roravec/RastoBot/Docs/ESP32/ESP32Pinout-FullPinout-768x576.png

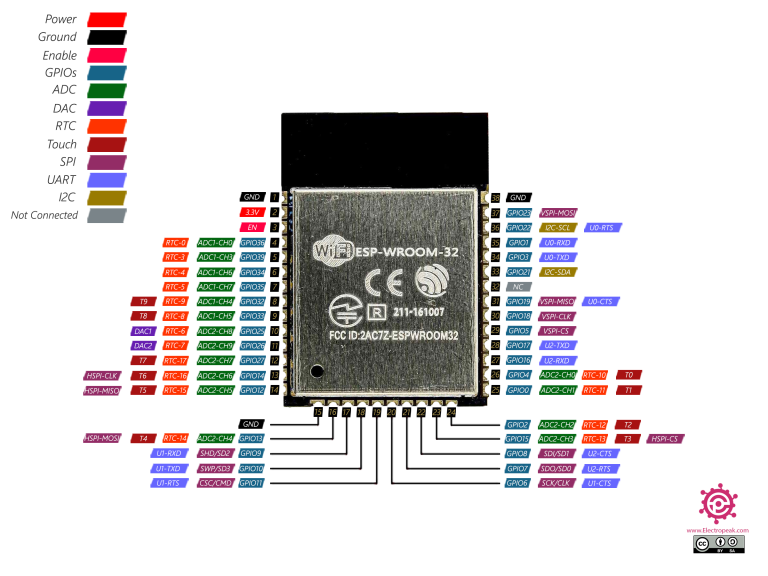
Docs/ESP32/ESP32Pinout-FullPinout-768x576.png
