roravec/RastoBot/Docs/ESP32/ESP32-S-pinout-mischianti-low-resolution.jpg

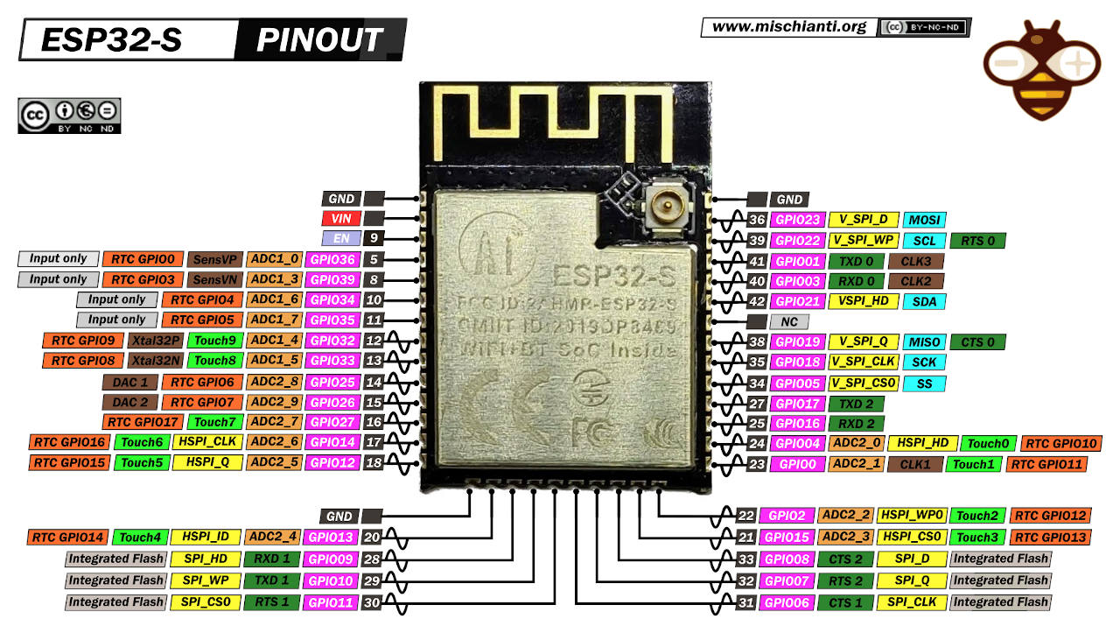
Docs/ESP32/ESP32-S-pinout-mischianti-low-resolution.jpg
