roravec/RastoBot/Docs/ACS712/d-768x346.png

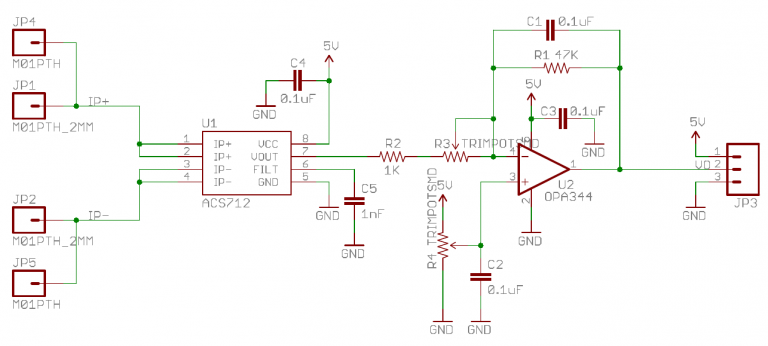
Docs/ACS712/d-768x346.png
