roravec/RastoBot/Docs/ESP32/xRequired-Circuit-For-Bare-Minimum-ESP32-Module.jpg.pagespeed.ic.3xBncZGP1E.webp

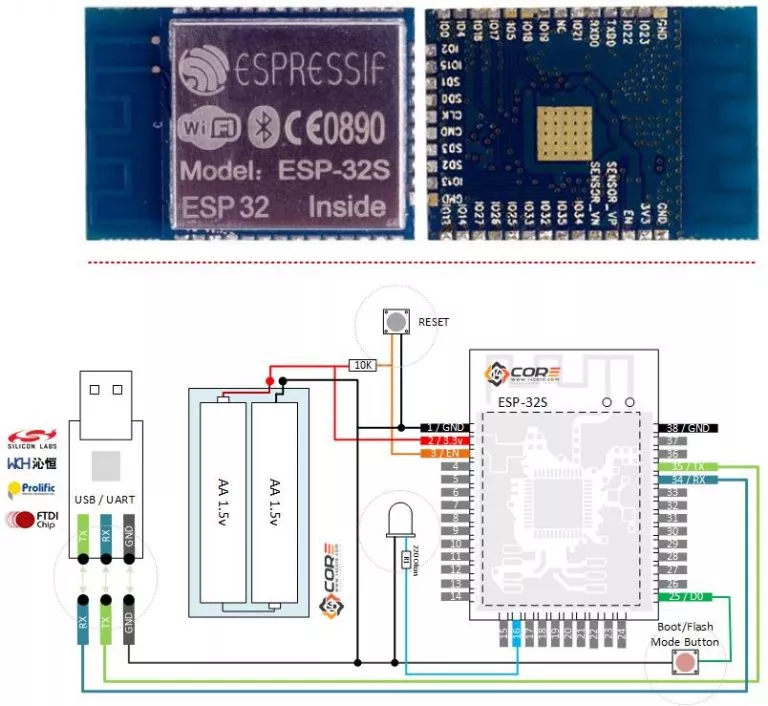
Docs/ESP32/xRequired-Circuit-For-Bare-Minimum-ESP32-Module.jpg.pagespeed.ic.3xBncZGP1E.webp
