roravec/RastoBot/Docs/mosfet driving.png

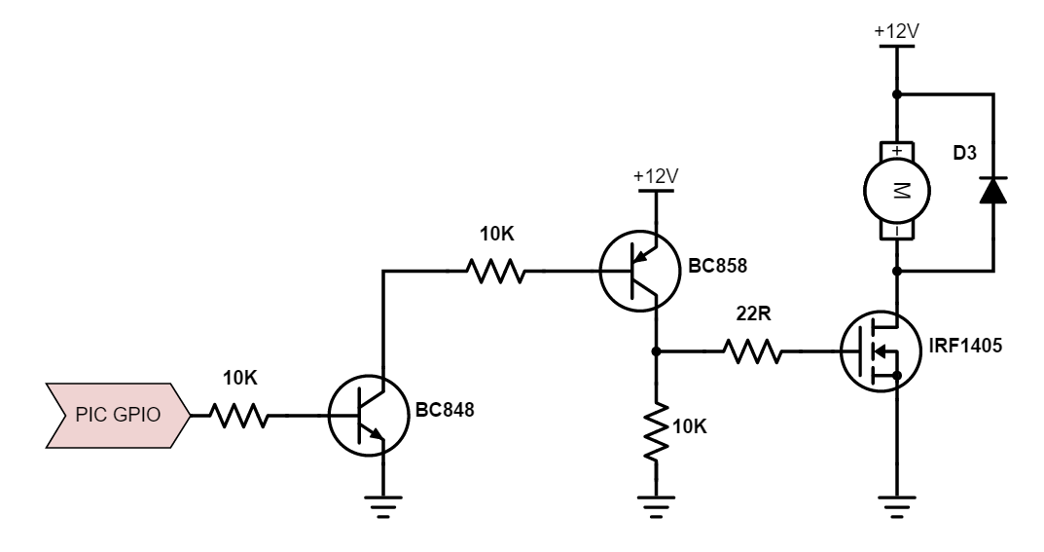
Docs/mosfet driving.png
