roravec/RastoBot/Docs/MP6500/MP6500.png

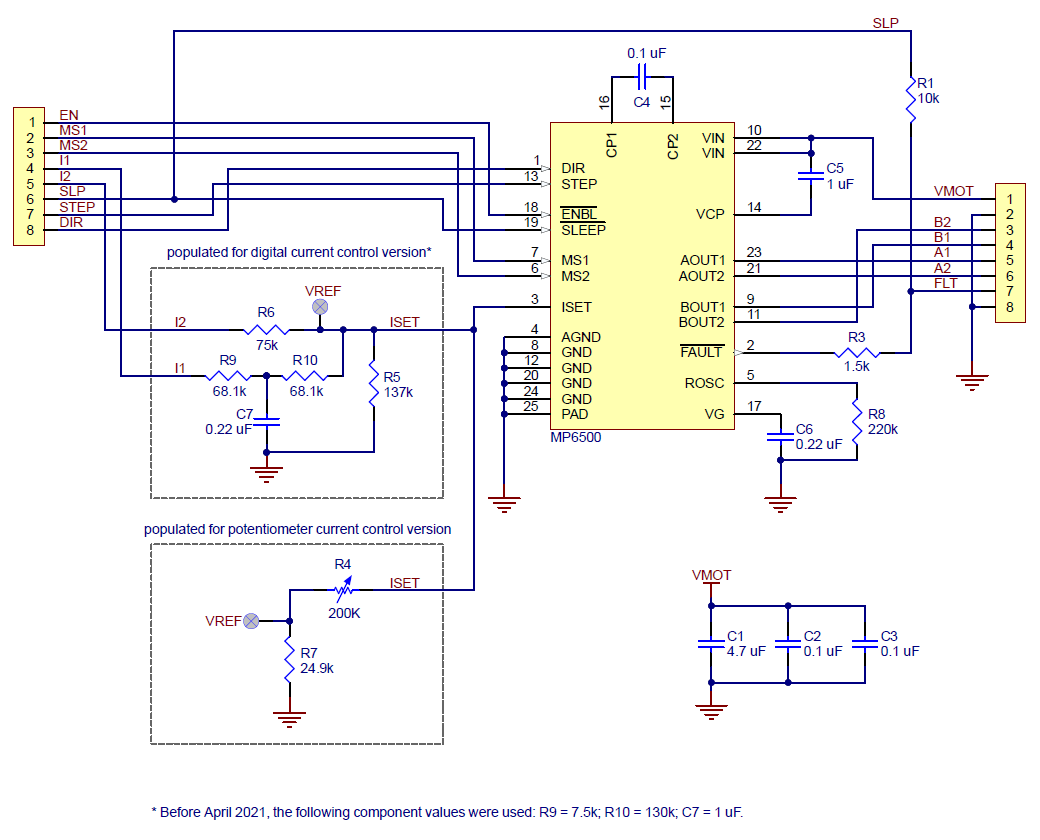
Docs/MP6500/MP6500.png
