roravec/RastoBot/Docs/MP6500/MP6500_a.png

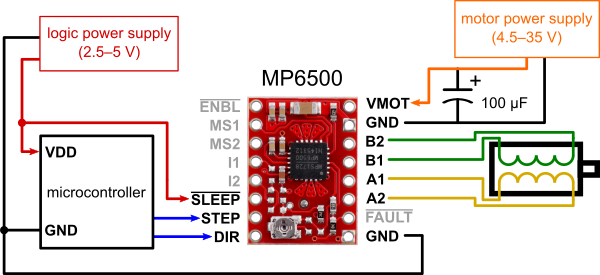
Docs/MP6500/MP6500_a.png
