roravec/RastoBot/Docs/optocoupler_mosfet_driver.gif

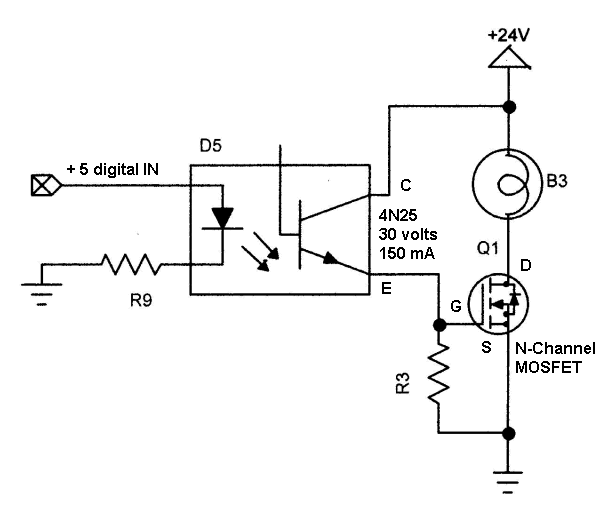
Docs/optocoupler_mosfet_driver.gif
