roravec/RastoBot/Docs/std resistors.PNG

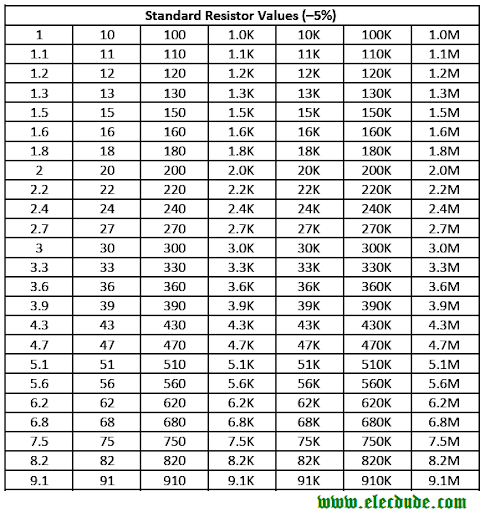
Docs/std resistors.PNG
