roravec/RastoBot/Docs/tilt_sensor_value.jpg

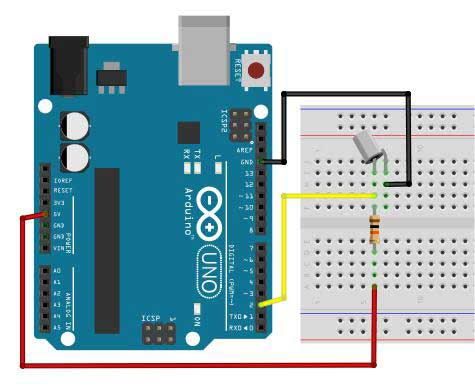
Docs/tilt_sensor_value.jpg
