roravec/RastoBot/Mower.drawio.png

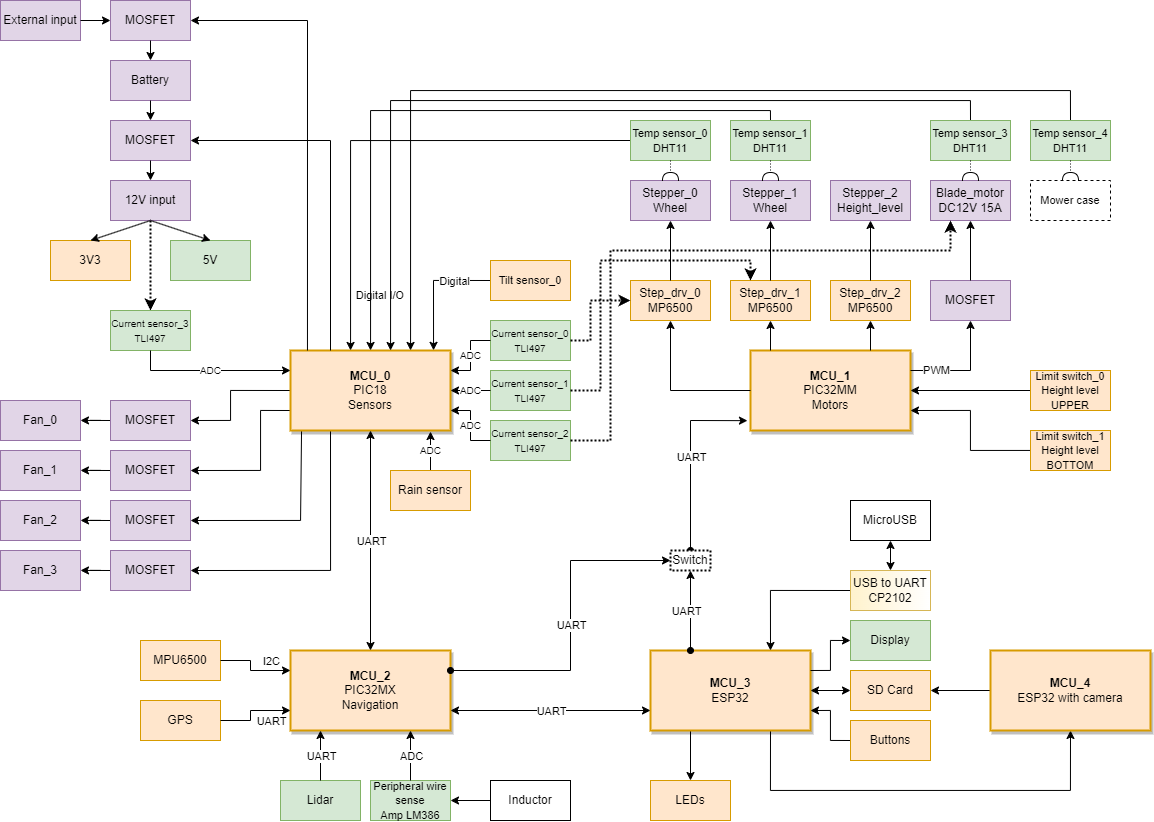
Mower.drawio.png
