roravec/RastoBot/Mower.png

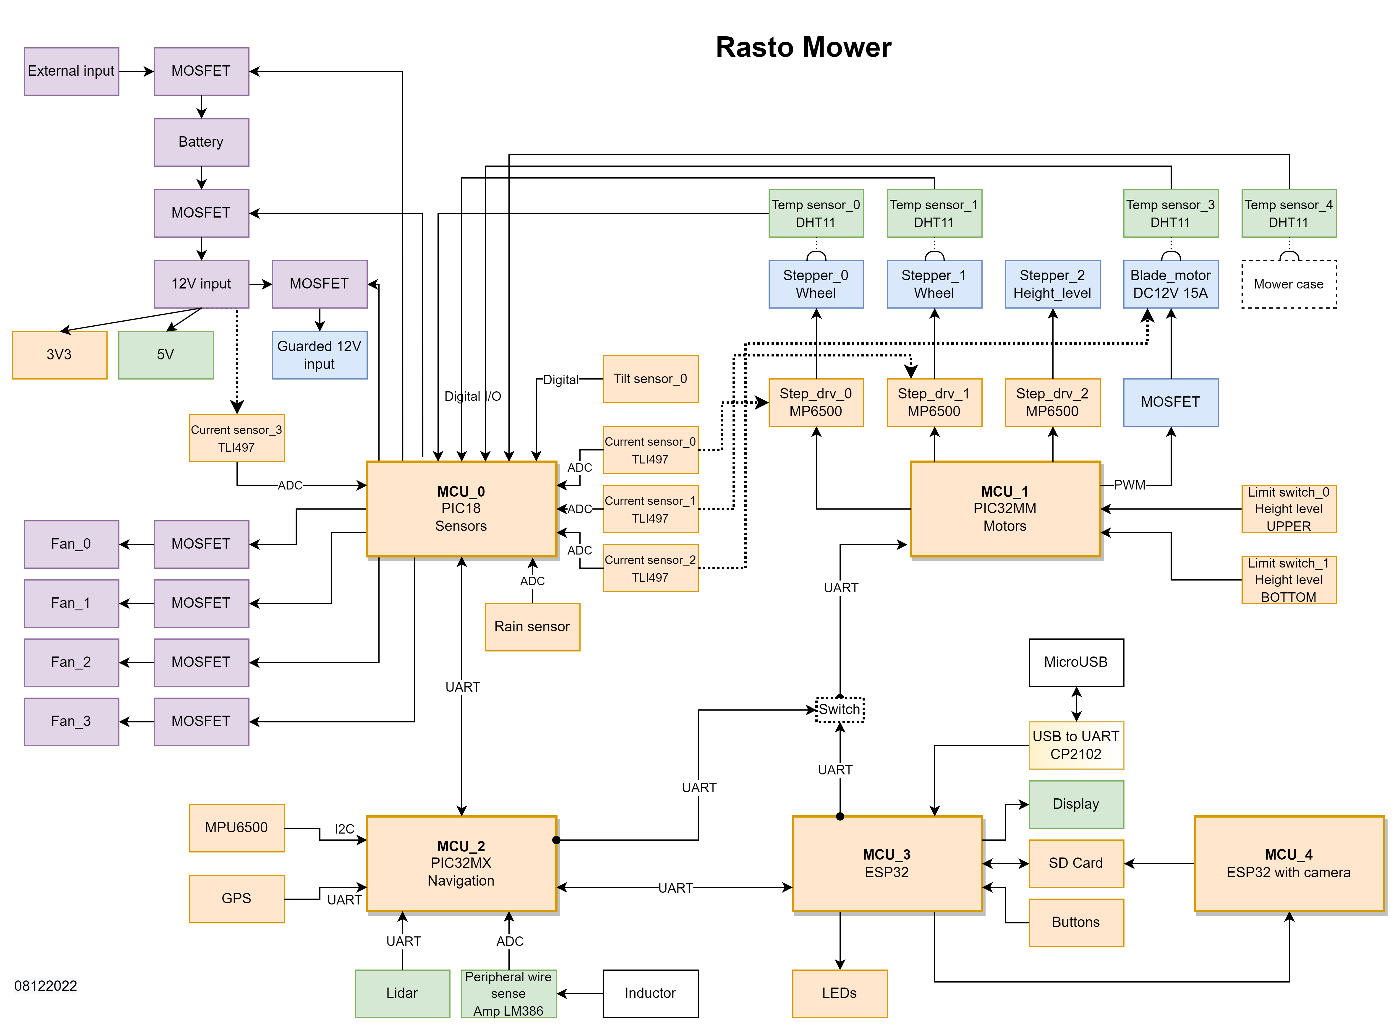
Mower.png
