roravec/RastoBot/PCB/Production_221101/RastoBot-r1.dxf

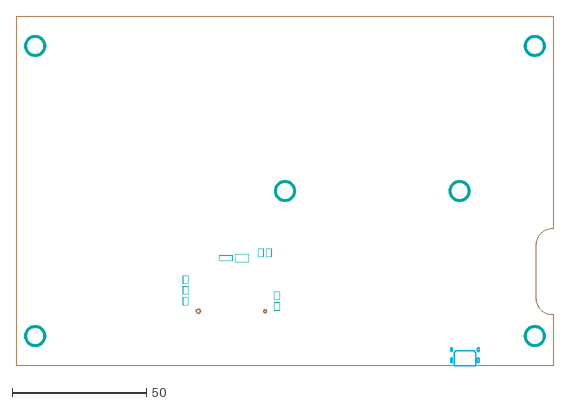
[picture p13: CAD file, 2023-02-13]
PCB/Production_221101/RastoBot-r1.dxf
200.2 x 130.2
