roravec/RastoBot/Docs/step_23_wire_sensor.webp

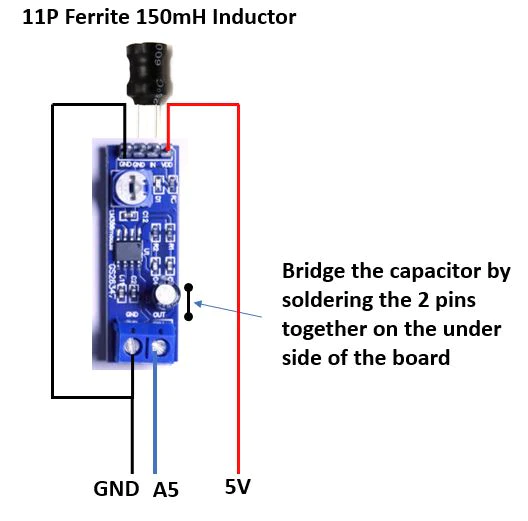
Docs/step_23_wire_sensor.webp
