roravec/RastoBot/PCB/RastoBot-r2.pdf

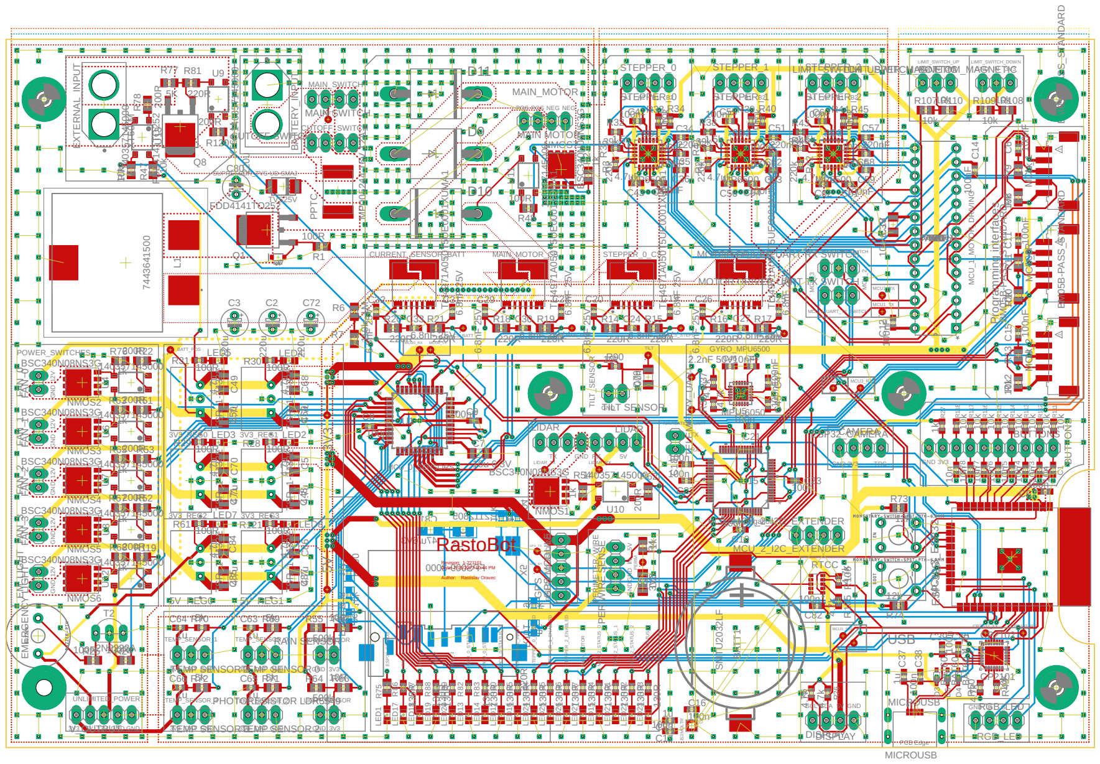
[picture p15: page 1]

POS POS NEG NEG

MOTOR DRIVER UART RX SWITCH

MOTOR DRIVER UART TX SWITCH

GND 12V GND 12V GND 12V GND 12V GND 12V

PPS RX TX GND 3V3
