roravec/RastoBot/PCB/RastoBot-r2.brd

## EAGLE design PCB/RastoBot-r2.brd (2023-02-19)

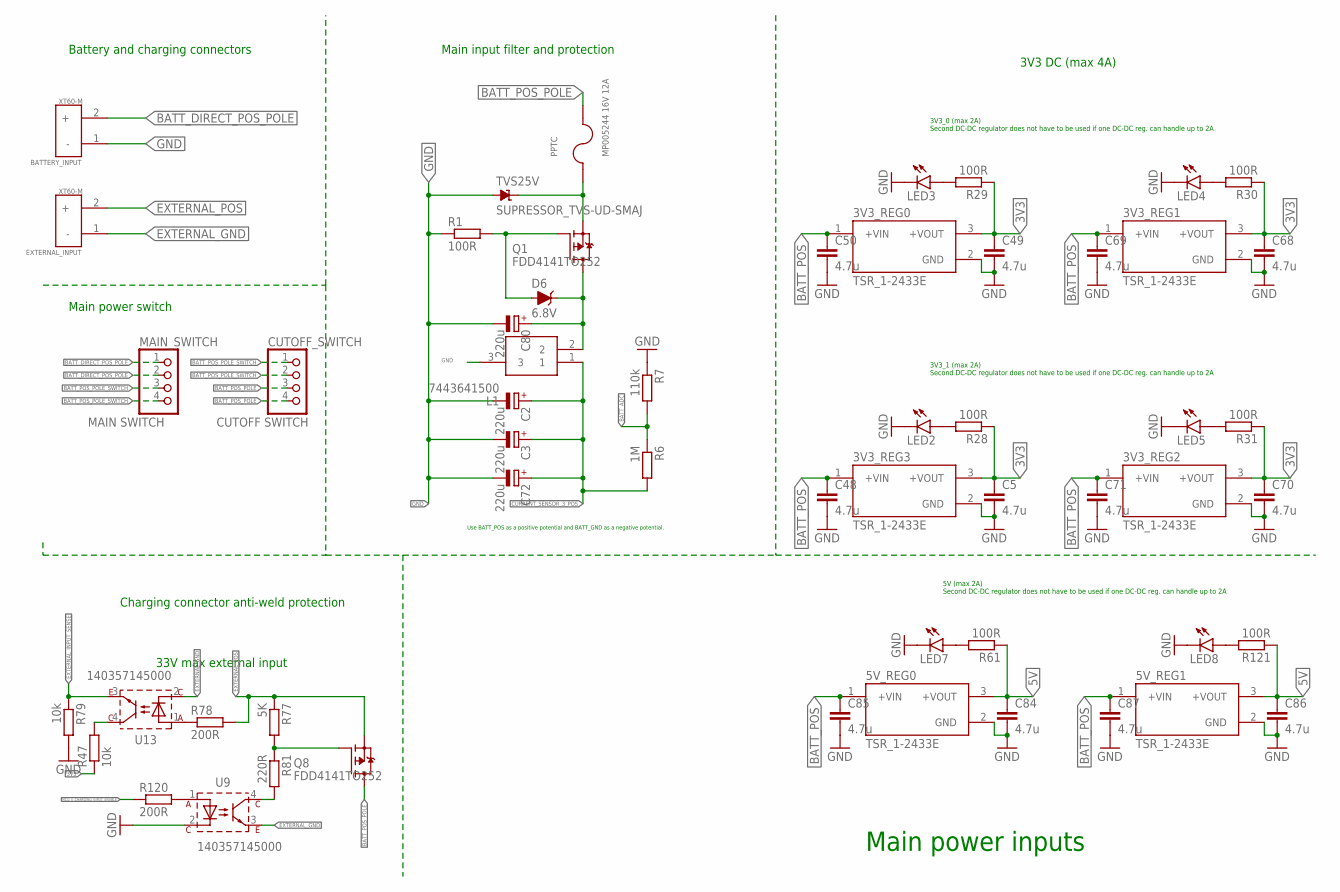
[picture p16: schematic RastoBot-r2.sch, sheet 1, Inputs]

Parts:
3V3_REG0, 3V3_REG1, 3V3_REG2, 3V3_REG3, 5V_REG0, 5V_REG1: TSR_1-2433E; CONV_TSR_1-2433E
BATTERY_INPUT: XT60-M; AMASS_XT60-M
C2, C3, C72, C80: 220u; E2,5-5
C5, C48, C49, C50, C68, C69, C70, C71, C84, C85, C86, C87: 4.7u; C1206
CUTOFF_SWITCH: CUTOFF SWITCH; 1X04
D6: 6.8V; SOD-323
EXTERNAL_INPUT: XT60-M; AMASS_XT60-M
L1: 7443641500; 74436413300
LED2, LED3, LED4, LED5, LED7, LED8: LEDSML0805; SML0805
MAIN_SWITCH: MAIN SWITCH; 1X04
PPTC: MP005244 16V 12A; FUSE_0ZCF0075AF2C
Q1, Q8: FDD4141TO252; TO252
R1: 100R; R0805
R6: 1M; R0805
R7: 110k; R0805
R28, R29, R30, R31, R61, R121: 100R; R0603
R47, R79: 10k; R0805
R77: 5K; R0805
R78, R120: 200R; R0805
R81: 220R; R0805
TVS25V: SUPRESSOR_TVS-UD-SMAJ; SUPRESSOR_SMAJ
U9, U13: 140357145000; WL-OCPT_SOP4

Connections:
3V3: 3V3_REG0.3 (+VOUT), 3V3_REG1.3 (+VOUT), 3V3_REG2.3 (+VOUT), 3V3_REG3.3 (+VOUT), C5.1, C49.1, C68.1, C70.1, R28.1, R29.1, R30.1, R31.1, R47.1; also elsewhere on the board
5V: 5V_REG0.3 (+VOUT), 5V_REG1.3 (+VOUT), C84.1, C86.1, R61.1, R121.1; also elsewhere on the board
BATT_ADC: R6.1, R7.2; also elsewhere on the board
BATT_DIRECT_POS_POLE: BATTERY_INPUT.2 (+), MAIN_SWITCH.1, MAIN_SWITCH.2; also elsewhere on the board
BATT_POS: 3V3_REG0.1 (+VIN), 3V3_REG1.1 (+VIN), 3V3_REG2.1 (+VIN), 3V3_REG3.1 (+VIN), 5V_REG0.1 (+VIN), 5V_REG1.1 (+VIN), C48.1, C50.1, C69.1, C71.1, C85.1, C87.1; also elsewhere on the board
BATT_POS_POLE: CUTOFF_SWITCH.3, CUTOFF_SWITCH.4, PPTC.2, Q8.3 (D)
BATT_POS_POLE_SWITCH: CUTOFF_SWITCH.1, CUTOFF_SWITCH.2, MAIN_SWITCH.3, MAIN_SWITCH.4
CURRENT_SENSOR_3_POS: C2.+, C3.+, C72.+, L1.1, R6.2; also elsewhere on the board
EXTERNAL_GND: EXTERNAL_INPUT.1 (-), U9.3, U13.2
EXTERNAL_INPUT_SENSE: R79.1, U13.3; also elsewhere on the board
EXTERNAL_POS: EXTERNAL_INPUT.2 (+), Q8.2 (S), R77.1, R78.2
GND: 3V3_REG0.2 (GND), 3V3_REG1.2 (GND), 3V3_REG2.2 (GND), 3V3_REG3.2 (GND), 5V_REG0.2 (GND), 5V_REG1.2 (GND), BATTERY_INPUT.1 (-), C2.-, C3.-, C5.2, C48.2, C49.2, C50.2, C68.2, C69.2, C70.2, C71.2, C72.-, C80.-, C84.2, C85.2, C86.2, C87.2, L1.3, LED2.C, LED3.C, LED4.C, LED5.C, LED7.C, LED8.C, R1.1, R7.1, R79.2, TVS25V.A, U9.2; also elsewhere on the board
MCU_0_CHARGING_INPUT_ENABLE: R120.1; also elsewhere on the board
unnamed: D6.A, Q1.1 (G), R1.2
unnamed: C80.+, D6.C, L1.2, Q1.3 (D)
unnamed: PPTC.1, Q1.2 (S), TVS25V.C
unnamed: LED2.A, R28.2
unnamed: LED3.A, R29.2
unnamed: LED4.A, R30.2
unnamed: LED5.A, R31.2
unnamed: R120.2, U9.1
unnamed: Q8.1 (G), R77.2, R81.1
unnamed: R81.2, U9.4
unnamed: R47.2, U13.4
unnamed: LED7.A, R61.2
unnamed: LED8.A, R121.2
unnamed: R78.1, U13.1

Notes on the sheet:
33V max external input
Charging connector anti-weld protection
Use BATT_POS as a positive potential and BATT_GND as a negative potential.
Main power inputs
3V3 DC (max 4A)
3V3_0 (max 2A) Second DC-DC regulator does not have to be used if one DC-DC reg. can handle up to 2A
3V3_1 (max 2A) Second DC-DC regulator does not have to be used if one DC-DC reg. can handle up to 2A
Main input filter and protection
Battery and charging connectors
Main power switch
5V (max 2A) Second DC-DC regulator does not have to be used if one DC-DC reg. can handle up to 2A

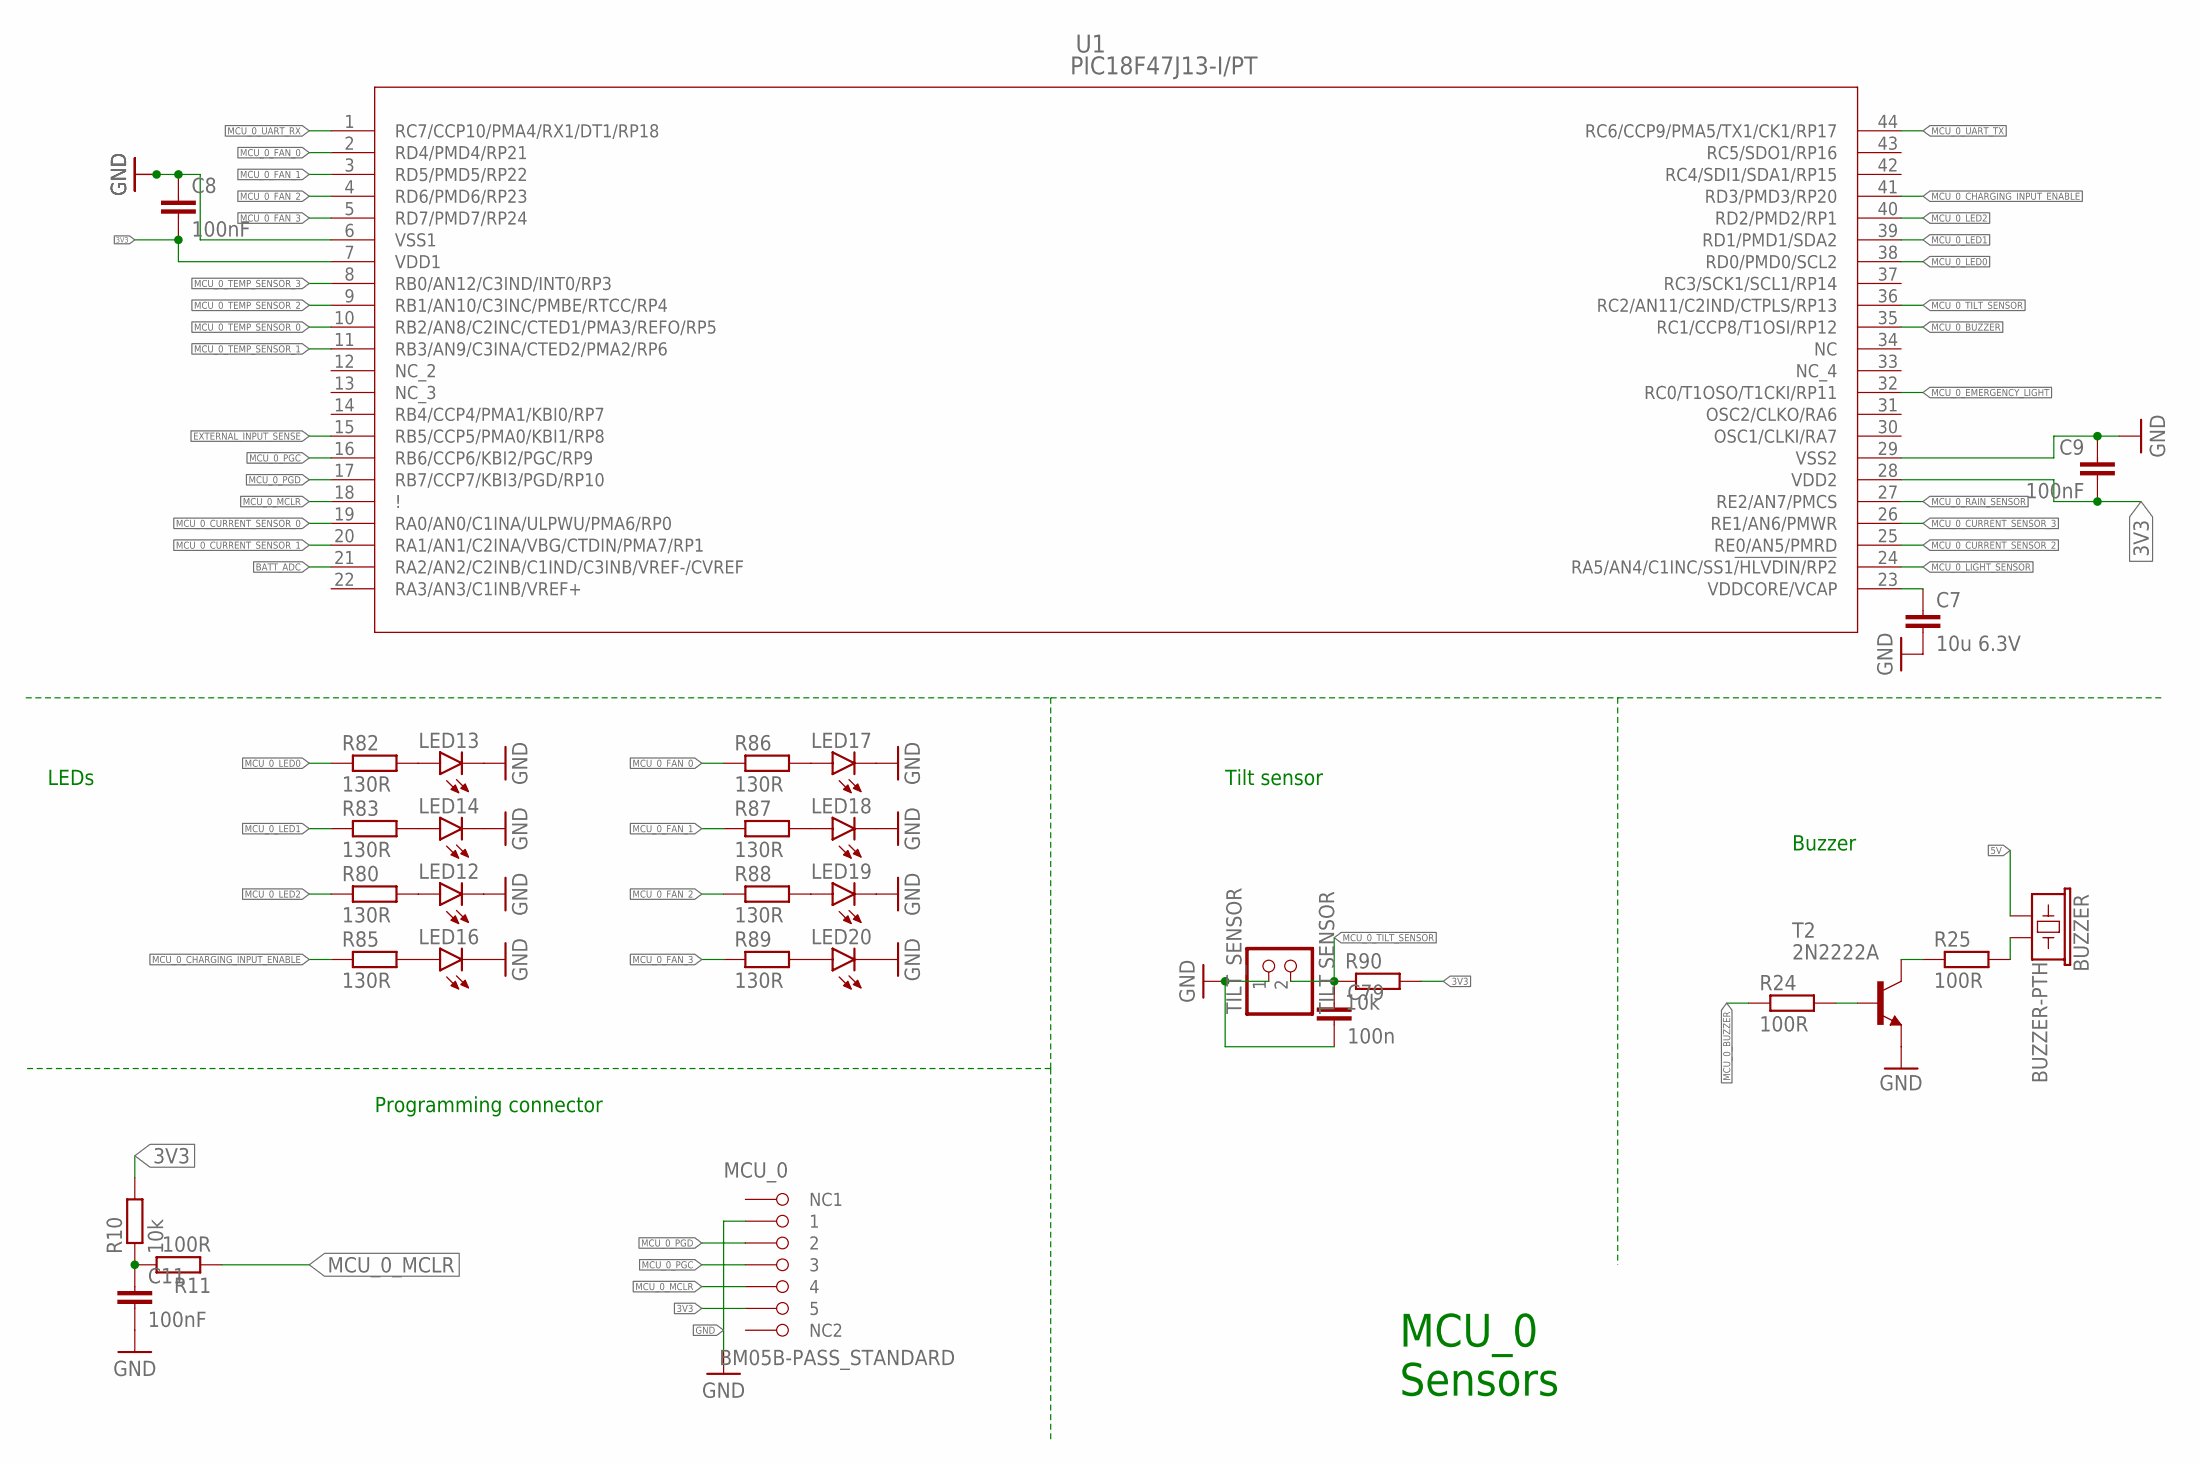
[picture p17: schematic RastoBot-r2.sch, sheet 2, MCU_0 PIC18 Sensors]

Parts:
BUZZER: BUZZER-PTH; BUZZER-12MM
C7: 10u 6.3V; C1206
C8, C9, C11: 100nF; C0603
C79: 100n; C1206
LED12, LED13, LED14, LED16, LED17, LED18, LED19, LED20: LEDSML0805; SML0805
MCU_0: BM05B-PASS_STANDARD; BM05B-PASS
R10: 10k; R0805
R11, R24, R25: 100R; R0805
R80, R82, R83, R85, R86, R87, R88, R89: 130R; R0603
R90: 10k; R0603
T2: 2N2222A; TO92-CBE
TILT_SENSOR: TILT SENSOR; 1X02
U1: PIC18F47J13-I/PT; TQFP44_10X10MC_MCH

Connections:
3V3: C8.2, C9.2, MCU_0.P$5 (5), R10.2, R90.2, U1.7 (VDD1), U1.28 (VDD2); also elsewhere on the board
5V: BUZZER.+ (1); also elsewhere on the board
BATT_ADC: U1.21 (RA2/AN2/C2INB/C1IND/C3INB/VREF-/CVREF); also elsewhere on the board
EXTERNAL_INPUT_SENSE: U1.15 (RB5/CCP5/PMA0/KBI1/RP8); also elsewhere on the board
GND: C7.2, C8.1, C9.1, C11.2, C79.2, LED12.C, LED13.C, LED14.C, LED16.C, LED17.C, LED18.C, LED19.C, LED20.C, MCU_0.P$1 (1), T2.E, TILT_SENSOR.1, U1.6 (VSS1), U1.29 (VSS2); also elsewhere on the board
MCU_0_BUZZER: R24.1, U1.35 (RC1/CCP8/T1OSI/RP12)
MCU_0_CHARGING_INPUT_ENABLE: R85.1, U1.41 (RD3/PMD3/RP20); also elsewhere on the board
MCU_0_CURRENT_SENSOR_0: U1.19 (RA0/AN0/C1INA/ULPWU/PMA6/RP0); also elsewhere on the board
MCU_0_CURRENT_SENSOR_1: U1.20 (RA1/AN1/C2INA/VBG/CTDIN/PMA7/RP1); also elsewhere on the board
MCU_0_CURRENT_SENSOR_2: U1.25 (RE0/AN5/PMRD); also elsewhere on the board
MCU_0_CURRENT_SENSOR_3: U1.26 (RE1/AN6/PMWR); also elsewhere on the board
MCU_0_EMERGENCY_LIGHT: U1.32 (RC0/T1OSO/T1CKI/RP11); also elsewhere on the board
MCU_0_FAN_0: R86.1, U1.2 (RD4/PMD4/RP21); also elsewhere on the board
MCU_0_FAN_1: R87.1, U1.3 (RD5/PMD5/RP22); also elsewhere on the board
MCU_0_FAN_2: R88.1, U1.4 (RD6/PMD6/RP23); also elsewhere on the board
MCU_0_FAN_3: R89.1, U1.5 (RD7/PMD7/RP24); also elsewhere on the board
MCU_0_LED0: R82.1, U1.38 (RD0/PMD0/SCL2)
MCU_0_LED1: R83.1, U1.39 (RD1/PMD1/SDA2)
MCU_0_LED2: R80.1, U1.40 (RD2/PMD2/RP1)
MCU_0_LIGHT_SENSOR: U1.24 (RA5/AN4/C1INC/SS1!/HLVDIN/RP2); also elsewhere on the board
MCU_0_MCLR: MCU_0.P$4 (4), R11.1, U1.18 (!)
MCU_0_PGC: MCU_0.P$3 (3), U1.16 (RB6/CCP6/KBI2/PGC/RP9)
MCU_0_PGD: MCU_0.P$2 (2), U1.17 (RB7/CCP7/KBI3/PGD/RP10)
MCU_0_RAIN_SENSOR: U1.27 (RE2/AN7/PMCS); also elsewhere on the board
MCU_0_TEMP_SENSOR_0: U1.10 (RB2/AN8/C2INC/CTED1/PMA3/REFO/RP5); also elsewhere on the board
MCU_0_TEMP_SENSOR_1: U1.11 (RB3/AN9/C3INA/CTED2/PMA2/RP6); also elsewhere on the board
MCU_0_TEMP_SENSOR_2: U1.9 (RB1/AN10/C3INC/PMBE/RTCC/RP4); also elsewhere on the board
MCU_0_TEMP_SENSOR_3: U1.8 (RB0/AN12/C3IND/INT0/RP3); also elsewhere on the board
MCU_0_TILT_SENSOR: C79.1, R90.1, TILT_SENSOR.2, U1.36 (RC2/AN11/C2IND/CTPLS/RP13); also elsewhere on the board
MCU_0_UART_RX: U1.1 (RC7/CCP10/PMA4/RX1/DT1/RP18); also elsewhere on the board
MCU_0_UART_TX: U1.44 (RC6/CCP9/PMA5/TX1/CK1/RP17); also elsewhere on the board
unnamed: C7.1, U1.23 (VDDCORE/VCAP)
unnamed: C11.1, R10.1, R11.2
unnamed: R24.2, T2.B
unnamed: BUZZER.- (2), R25.2
unnamed: R25.1, T2.C
unnamed: LED12.A, R80.2
unnamed: LED13.A, R82.2
unnamed: LED14.A, R83.2
unnamed: LED16.A, R85.2
unnamed: LED17.A, R86.2
unnamed: LED18.A, R87.2
unnamed: LED19.A, R88.2
unnamed: LED20.A, R89.2

Notes on the sheet:
Buzzer
MCU_0 Sensors
Tilt sensor
LEDs
Programming connector

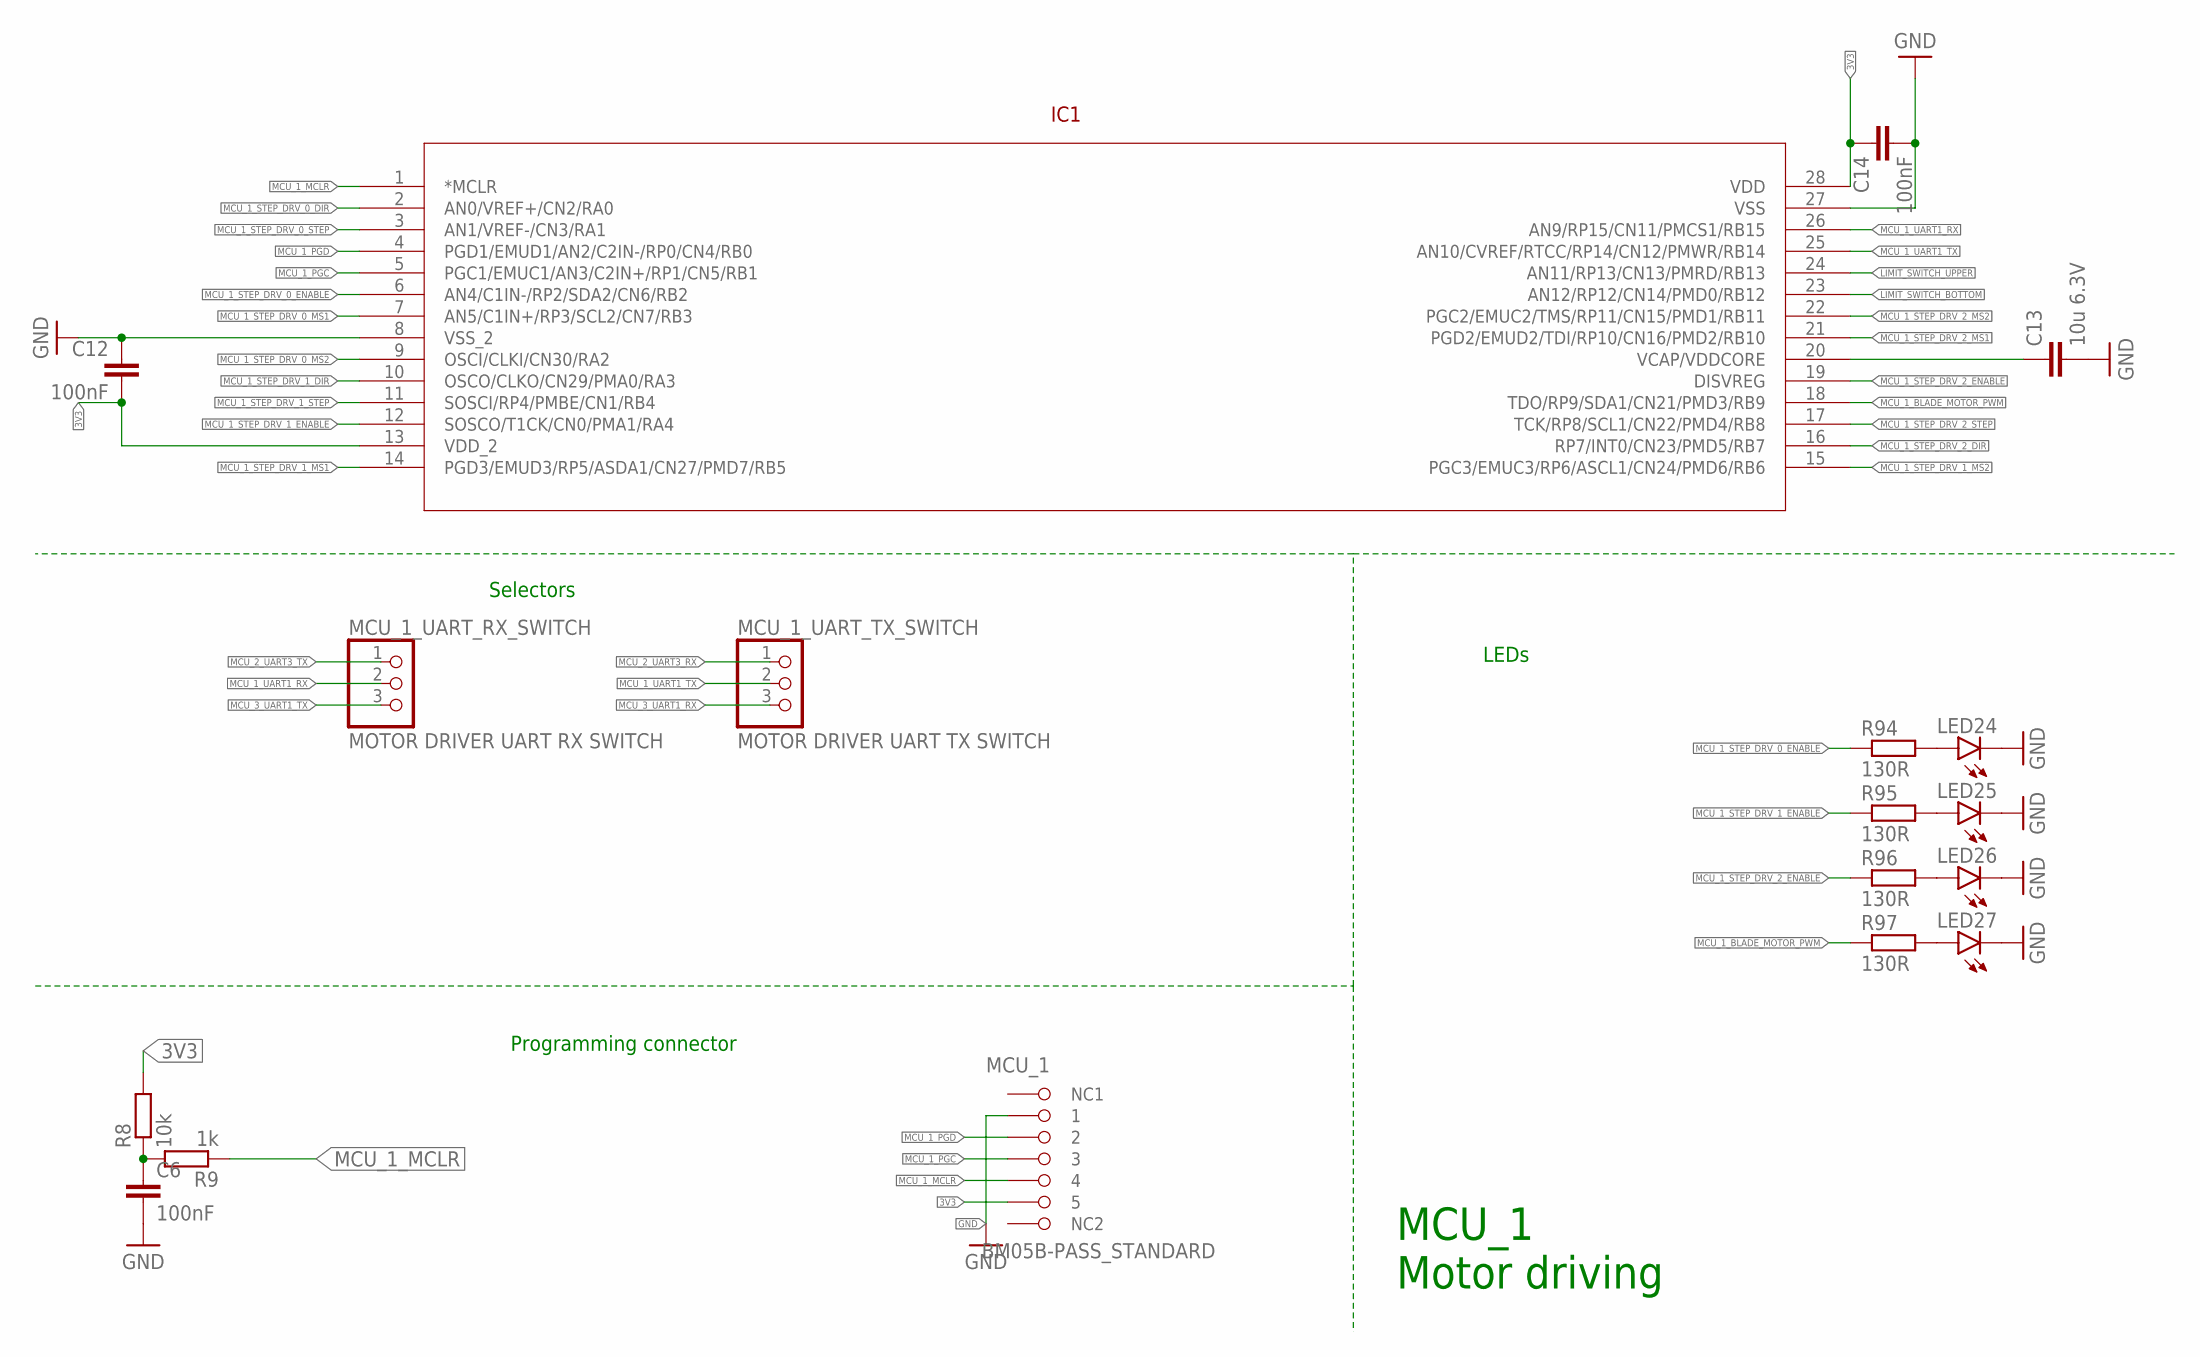
[picture p18: schematic RastoBot-r2.sch, sheet 3, MCU_1 PIC32MM Motor Driving]

Parts:
C6, C12, C14: 100nF; C0603
C13: 10u 6.3V; C1206
IC1: PIC24FJ32GA002-X; SPDIP28_300MC
LED24, LED25, LED26, LED27: LEDSML0805; SML0805
MCU_1: BM05B-PASS_STANDARD; BM05B-PASS
MCU_1_UART_RX_SWITCH: MOTOR DRIVER UART RX SWITCH; 1X03
MCU_1_UART_TX_SWITCH: MOTOR DRIVER UART TX SWITCH; 1X03
R8: 10k; R0805
R9: 1k; R0805
R94, R95, R96, R97: 130R; R0603

Connections:
3V3: C12.2, C14.1, IC1.13 (VDD_2), IC1.28 (VDD), MCU_1.P$5 (5), R8.2; also elsewhere on the board
GND: C6.2, C12.1, C13.2, C14.2, IC1.8 (VSS_2), IC1.27 (VSS), LED24.C, LED25.C, LED26.C, LED27.C, MCU_1.P$1 (1); also elsewhere on the board
LIMIT_SWITCH_BOTTOM: IC1.23 (AN12/RP12/CN14/PMD0/RB12); also elsewhere on the board
LIMIT_SWITCH_UPPER: IC1.24 (AN11/RP13/CN13/PMRD/RB13); also elsewhere on the board
MCU_1_BLADE_MOTOR_PWM: IC1.18 (TDO/RP9/SDA1/CN21/PMD3/RB9), R97.1; also elsewhere on the board
MCU_1_MCLR: IC1.1 (*MCLR), MCU_1.P$4 (4), R9.1
MCU_1_PGC: IC1.5 (PGC1/EMUC1/AN3/C2IN+/RP1/CN5/RB1), MCU_1.P$3 (3)
MCU_1_PGD: IC1.4 (PGD1/EMUD1/AN2/C2IN-/RP0/CN4/RB0), MCU_1.P$2 (2)
MCU_1_STEP_DRV_0_DIR: IC1.2 (AN0/VREF+/CN2/RA0); also elsewhere on the board
MCU_1_STEP_DRV_0_ENABLE: IC1.6 (AN4/C1IN-/RP2/SDA2/CN6/RB2), R94.1; also elsewhere on the board
MCU_1_STEP_DRV_0_MS1: IC1.7 (AN5/C1IN+/RP3/SCL2/CN7/RB3); also elsewhere on the board
MCU_1_STEP_DRV_0_MS2: IC1.9 (OSCI/CLKI/CN30/RA2); also elsewhere on the board
MCU_1_STEP_DRV_0_STEP: IC1.3 (AN1/VREF-/CN3/RA1); also elsewhere on the board
MCU_1_STEP_DRV_1_DIR: IC1.10 (OSCO/CLKO/CN29/PMA0/RA3); also elsewhere on the board
MCU_1_STEP_DRV_1_ENABLE: IC1.12 (SOSCO/T1CK/CN0/PMA1/RA4), R95.1; also elsewhere on the board
MCU_1_STEP_DRV_1_MS1: IC1.14 (PGD3/EMUD3/RP5/ASDA1/CN27/PMD7/RB5); also elsewhere on the board
MCU_1_STEP_DRV_1_MS2: IC1.15 (PGC3/EMUC3/RP6/ASCL1/CN24/PMD6/RB6); also elsewhere on the board
MCU_1_STEP_DRV_1_STEP: IC1.11 (SOSCI/RP4/PMBE/CN1/RB4); also elsewhere on the board
MCU_1_STEP_DRV_2_DIR: IC1.16 (RP7/INT0/CN23/PMD5/RB7); also elsewhere on the board
MCU_1_STEP_DRV_2_ENABLE: IC1.19 (DISVREG), R96.1; also elsewhere on the board
MCU_1_STEP_DRV_2_MS1: IC1.21 (PGD2/EMUD2/TDI/RP10/CN16/PMD2/RB10); also elsewhere on the board
MCU_1_STEP_DRV_2_MS2: IC1.22 (PGC2/EMUC2/TMS/RP11/CN15/PMD1/RB11); also elsewhere on the board
MCU_1_STEP_DRV_2_STEP: IC1.17 (TCK/RP8/SCL1/CN22/PMD4/RB8); also elsewhere on the board
MCU_1_UART1_RX: IC1.26 (AN9/RP15/CN11/PMCS1/RB15), MCU_1_UART_RX_SWITCH.2; also elsewhere on the board
MCU_1_UART1_TX: IC1.25 (AN10/CVREF/RTCC/RP14/CN12/PMWR/RB14), MCU_1_UART_TX_SWITCH.2; also elsewhere on the board
MCU_2_UART3_RX: MCU_1_UART_TX_SWITCH.1; also elsewhere on the board
MCU_2_UART3_TX: MCU_1_UART_RX_SWITCH.1; also elsewhere on the board
MCU_3_UART1_RX: MCU_1_UART_TX_SWITCH.3; also elsewhere on the board
MCU_3_UART1_TX: MCU_1_UART_RX_SWITCH.3; also elsewhere on the board
unnamed: C6.1, R8.1, R9.2
unnamed: C13.1, IC1.20 (VCAP/VDDCORE)
unnamed: LED24.A, R94.2
unnamed: LED25.A, R95.2
unnamed: LED26.A, R96.2
unnamed: LED27.A, R97.2

Notes on the sheet:
MCU_1 Motor driving
LEDs
Programming connector
Selectors

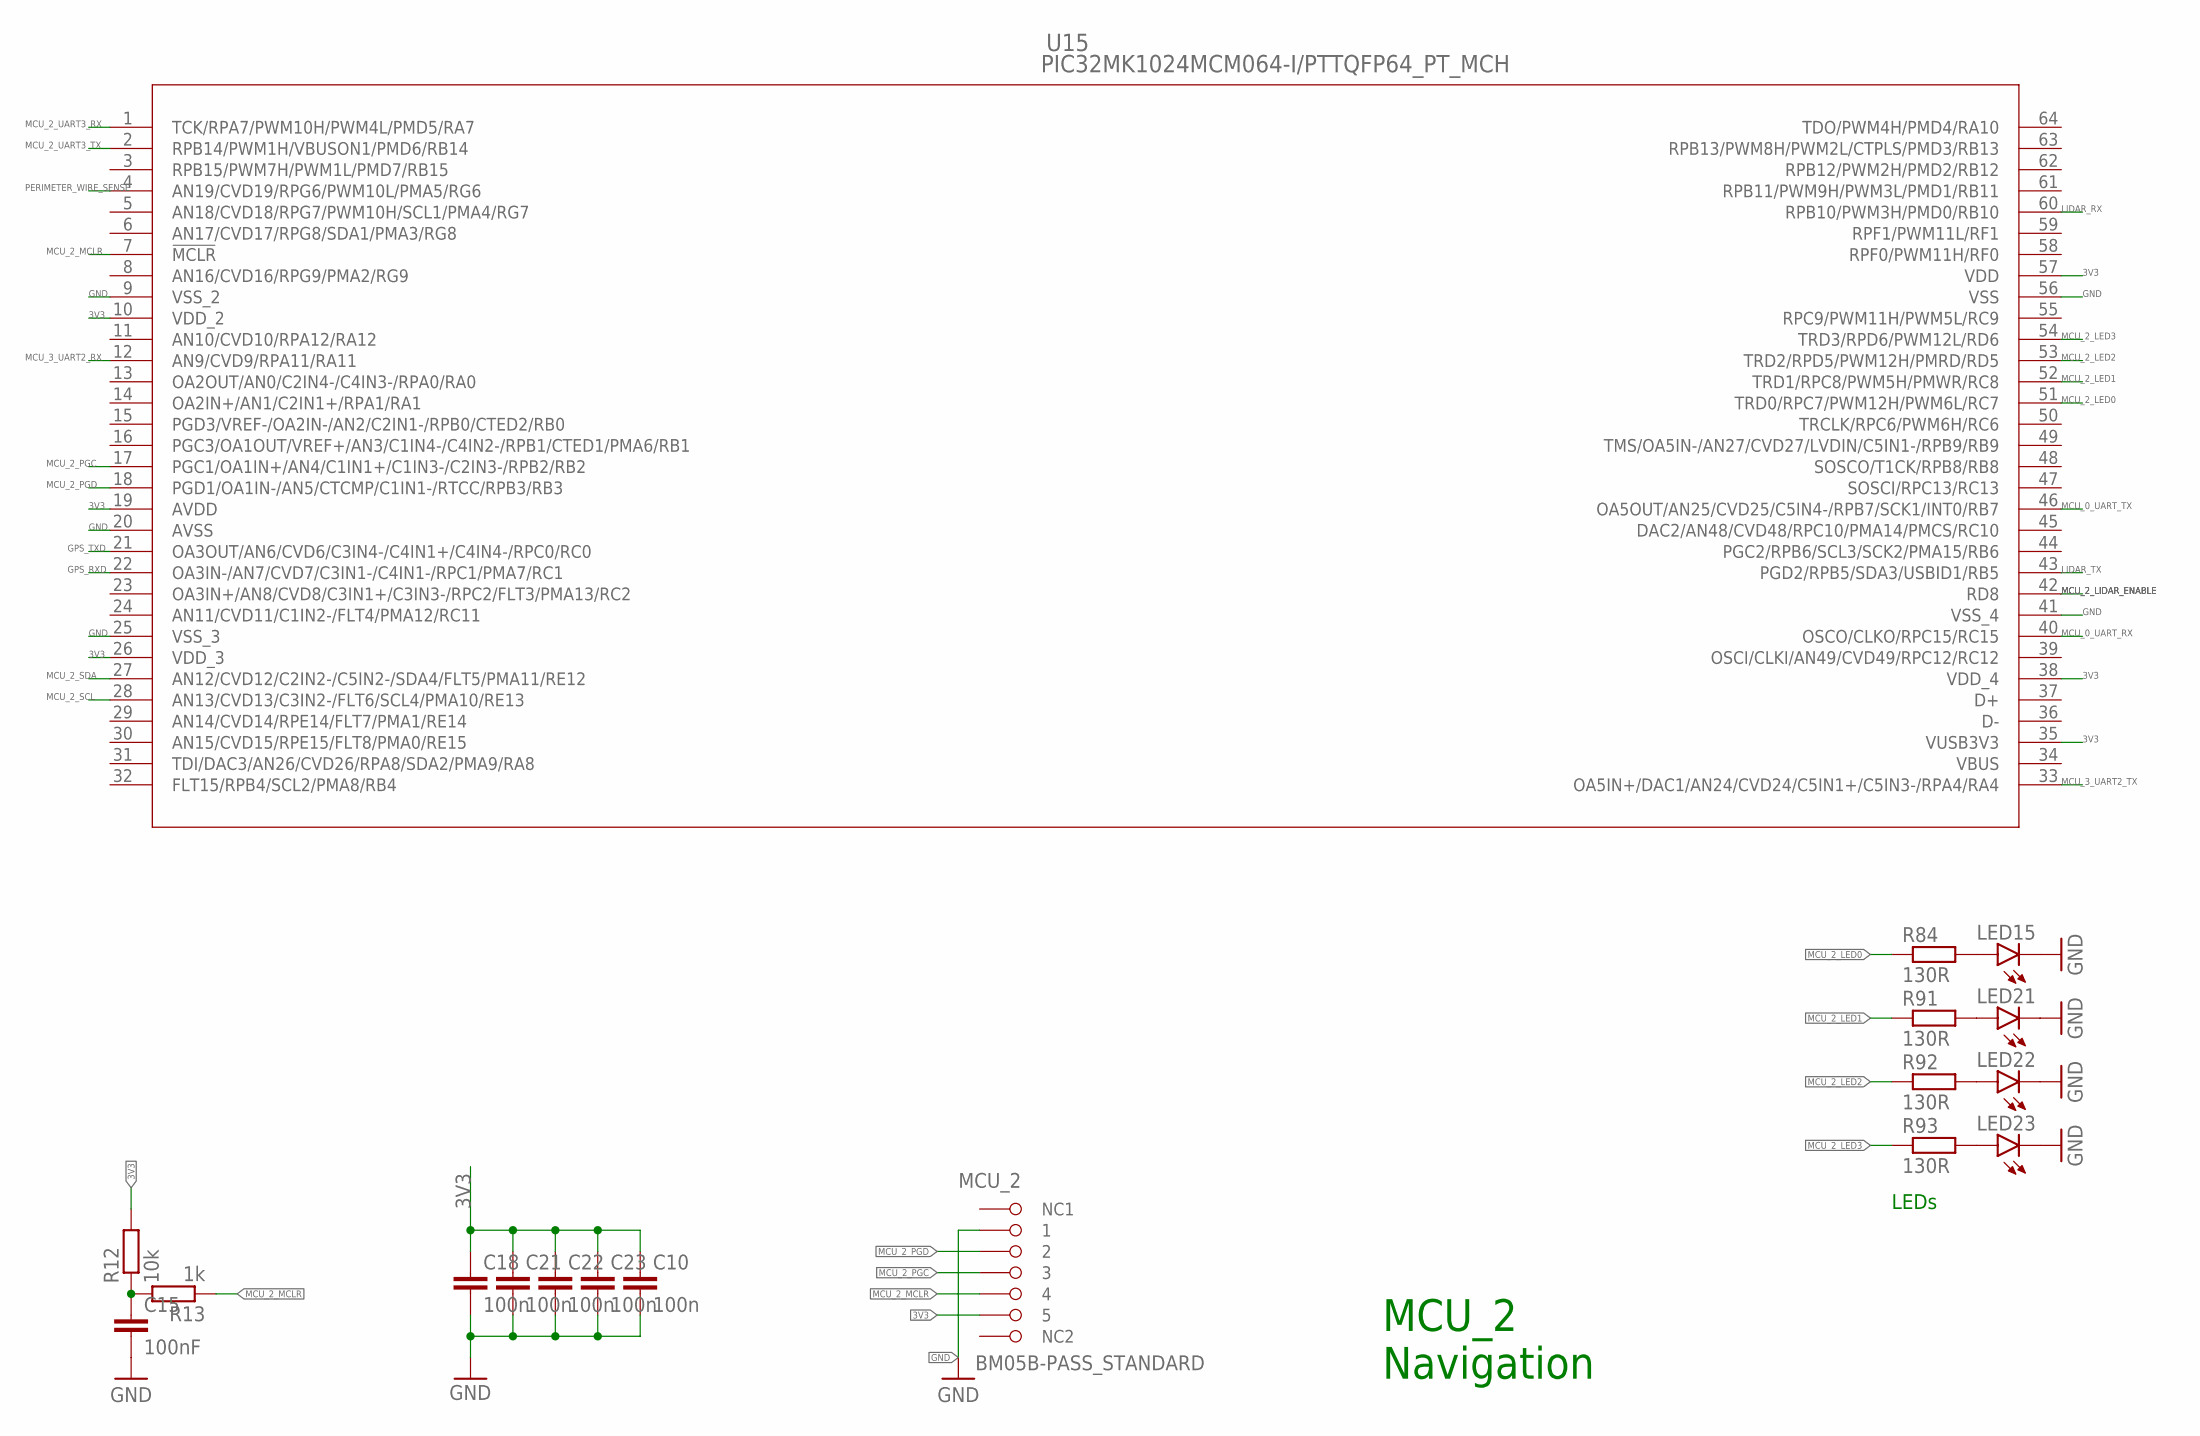
[picture p19: schematic RastoBot-r2.sch, sheet 4, MCU_2 PIC32MX Navigation]

Parts:
C10, C18, C21, C22, C23: 100n; C0603
C15: 100nF; C0603
LED15, LED21, LED22, LED23: LEDSML0805; SML0805
MCU_2: BM05B-PASS_STANDARD; BM05B-PASS
R12: 10k; R0805
R13: 1k; R0805
R84, R91, R92, R93: 130R; R0603
U15: PIC32MK1024MCM064-I/PTTQFP64_PT_MCH; TQFP64_PT_MCH

Connections:
3V3: C10.1, C18.1, C21.1, C22.1, C23.1, MCU_2.P$5 (5), R12.2, U15.10 (VDD_2), U15.19 (AVDD), U15.26 (VDD_3), U15.35 (VUSB3V3), U15.38 (VDD_4), U15.57 (VDD); also elsewhere on the board
GND: C10.2, C15.2, C18.2, C21.2, C22.2, C23.2, LED15.C, LED21.C, LED22.C, LED23.C, MCU_2.P$1 (1), U15.9 (VSS_2), U15.20 (AVSS), U15.25 (VSS_3), U15.41 (VSS_4), U15.56 (VSS); also elsewhere on the board
GPS_RXD: U15.22 (OA3IN-/AN7/CVD7/C3IN1-/C4IN1-/RPC1/PMA7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); also elsewhere on the board
GPS_TXD: U15.21 (OA3OUT/AN6/CVD6/C3IN4-/C4IN1+/C4IN4-/RP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); also elsewhere on the board
LIDAR_RX: U15.60 (RPB10/PWM3H/PMD0/RB10); also elsewhere on the board
LIDAR_TX: U15.43 (PGD2/RPB5/SDA3/USBID1/RB5); also elsewhere on the board
MCU_0_UART_RX: U15.40 (OSCO/CLKO/RPC15/RC15); also elsewhere on the board
MCU_0_UART_TX: U15.46 (OA5OUT/AN25/CVD25/C5IN4-/RPB7/SCK1/INT0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); also elsewhere on the board
MCU_2_LED0: R84.1, U15.51 (TRD0/RPC7/PWM12H/PWM6L/RC7)
MCU_2_LED1: R91.1, U15.52 (TRD1/RPC8/PWM5H/PMWR/RC8)
MCU_2_LED2: R92.1, U15.53 (TRD2/RPD5/PWM12H/PMRD/RD5)
MCU_2_LED3: R93.1, U15.54 (TRD3/RPD6/PWM12L/RD6)
MCU_2_LIDAR_ENABLE: U15.42 (RD8); also elsewhere on the board
MCU_2_MCLR: MCU_2.P$4 (4), R13.1, U15.7 (!MCLR)
MCU_2_PGC: MCU_2.P$3 (3), U15.17 (PGC1/OA1IN+/AN4/C1IN1+/C1IN3-/C2IN3-/RP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)
MCU_2_PGD: MCU_2.P$2 (2), U15.18 (PGD1/OA1IN-/AN5/CTCMP/C1IN1-/RTCC/RPB3/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)
MCU_2_SCL: U15.28 (AN13/CVD13/C3IN2-/FLT6/SCL4/PMA10/RE13); also elsewhere on the board
MCU_2_SDA: U15.27 (AN12/CVD12/C2IN2-/C5IN2-/SDA4/FLT5/PMA1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); also elsewhere on the board
MCU_2_UART3_RX: U15.1 (TCK/RPA7/PWM10H/PWM4L/PMD5/RA7); also elsewhere on the board
MCU_2_UART3_TX: U15.2 (RPB14/PWM1H/VBUSON1/PMD6/RB14); also elsewhere on the board
MCU_3_UART2_RX: U15.12 (AN9/CVD9/RPA11/RA11); also elsewhere on the board
MCU_3_UART2_TX: U15.33 (OA5IN+/DAC1/AN24/CVD24/C5IN1+/C5IN3-/RP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); also elsewhere on the board
unnamed: C15.1, R12.1, R13.2
unnamed: LED15.A, R84.2
unnamed: LED21.A, R91.2
unnamed: LED22.A, R92.2
unnamed: LED23.A, R93.2
PERIMETER_WIRE_SENSE: U15.4 (AN19/CVD19/RPG6/PWM10L/PMA5/RG6); also elsewhere on the board
VBUS: U15.34 (VBUS)

Notes on the sheet:
MCU_2 Navigation
LEDs

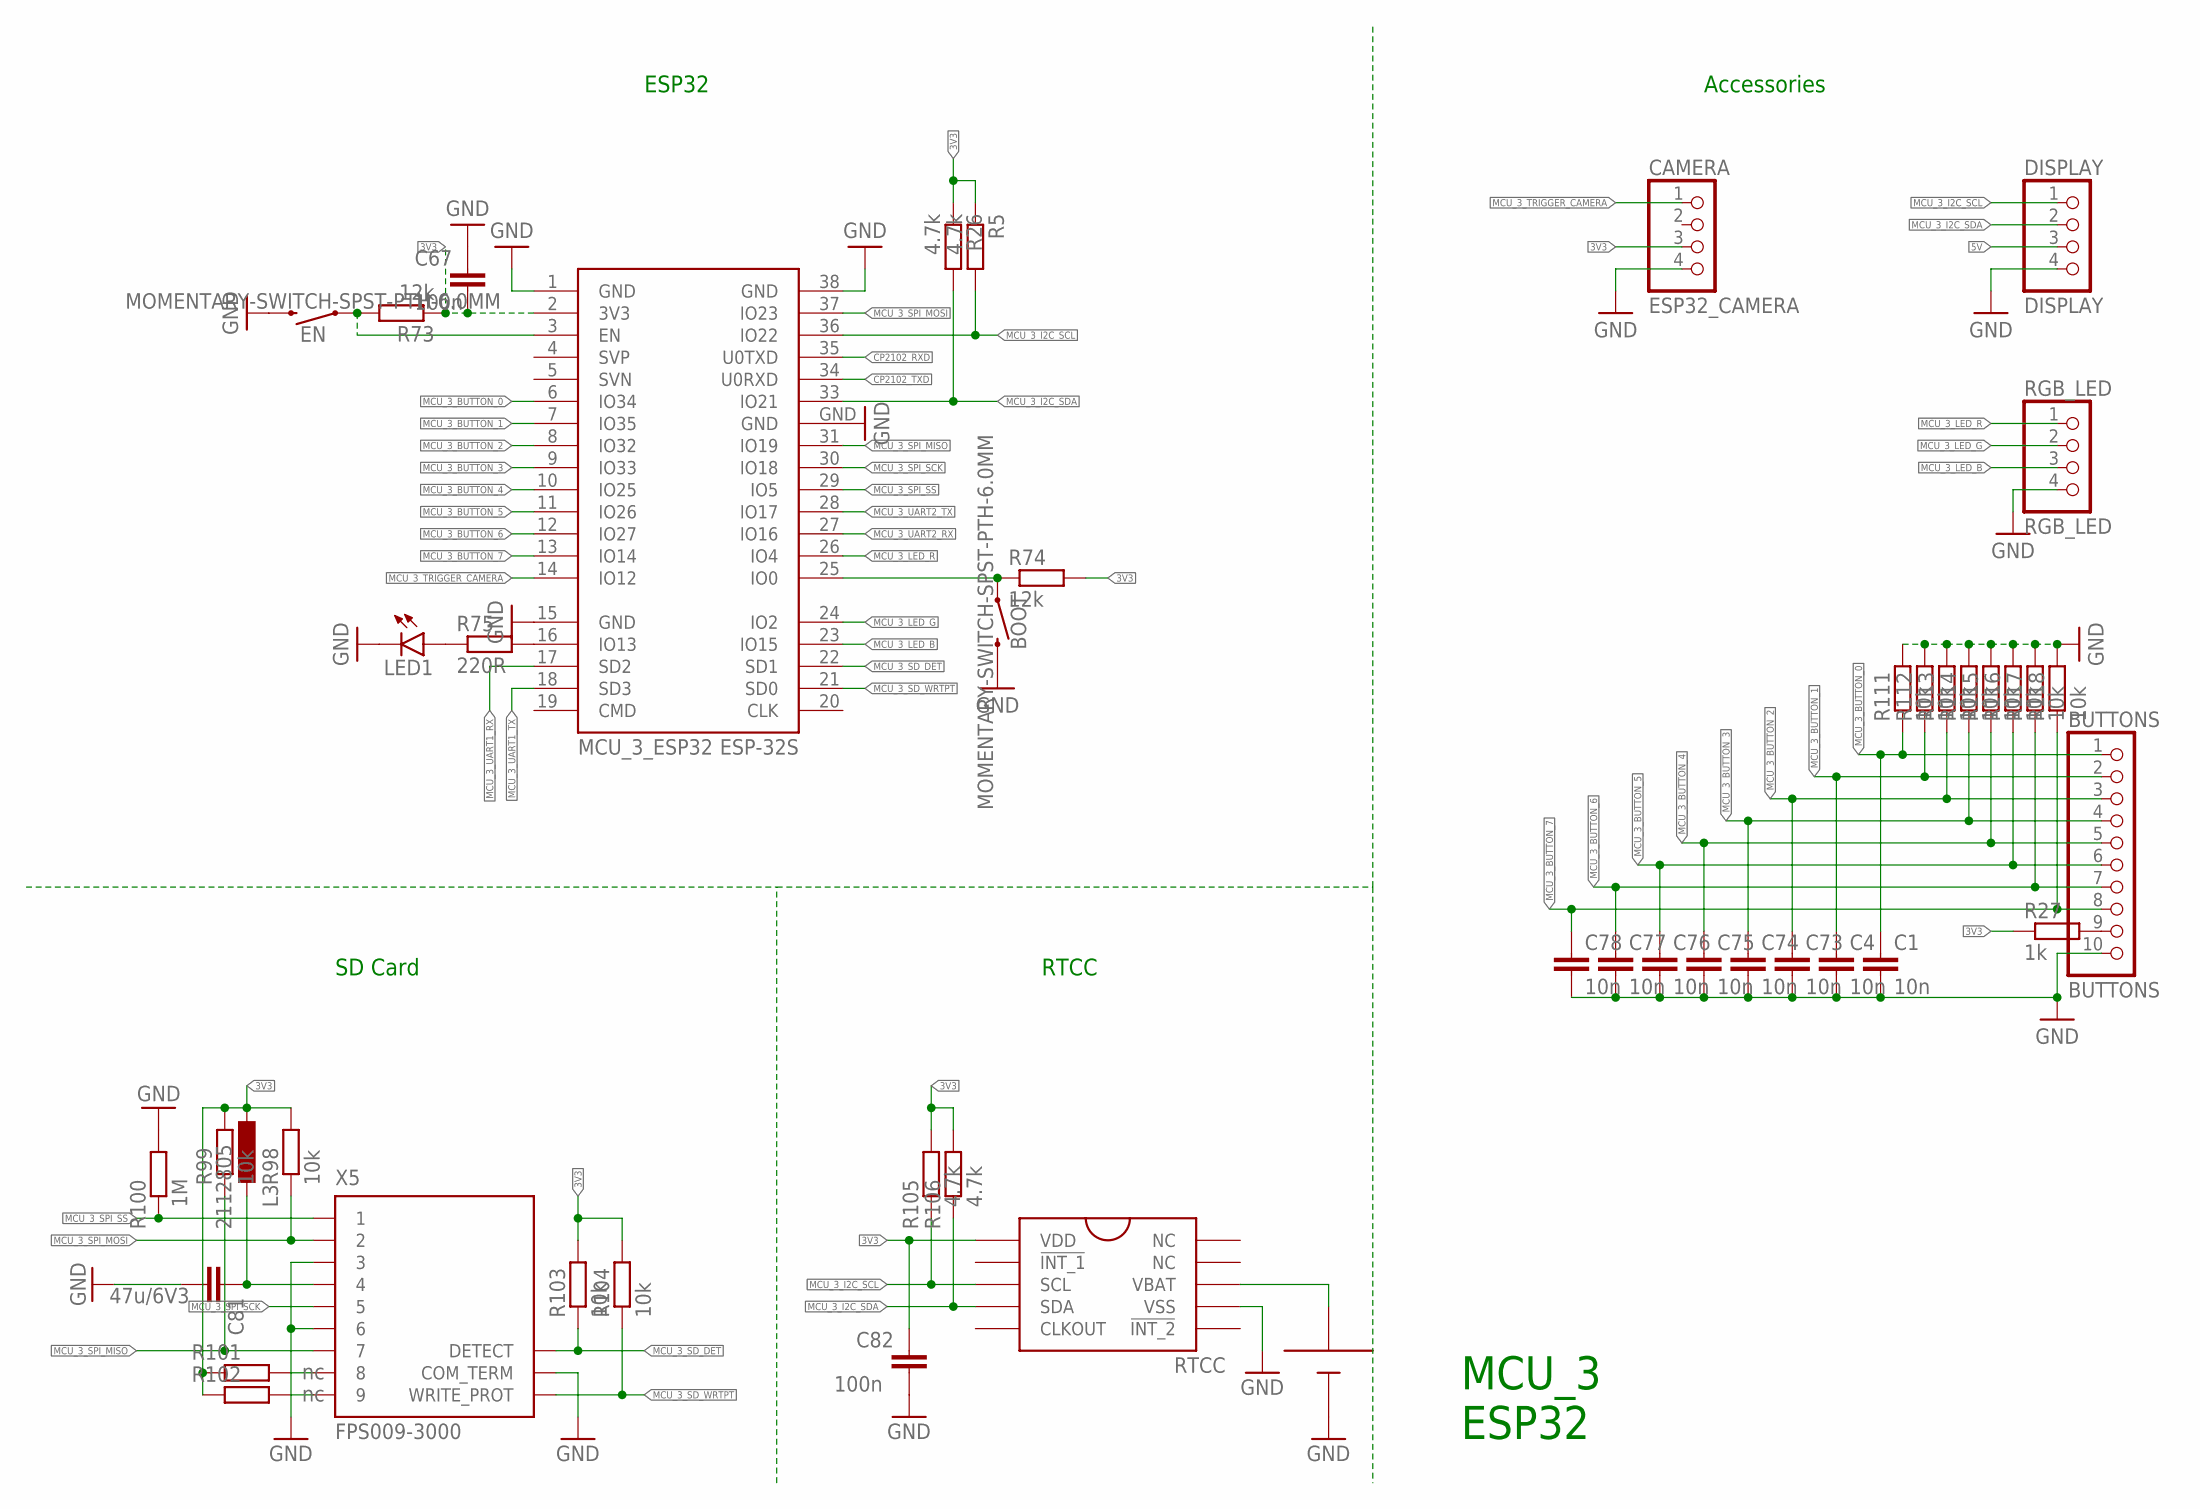
[picture p20: schematic RastoBot-r2.sch, sheet 5, MCU_3 ESP32]

Parts:
BATT1: SMTU2032LF
BOOT: MOMENTARY-SWITCH-SPST-PTH-6.0MM; TACTILE_SWITCH_PTH_6.0MM
BUTTONS: BUTTONS; 1X10
C1, C4, C73, C74, C75, C76, C77, C78: 10n; C0603
C67, C82: 100n; C0603
C81: 47u/6V3; C1206
CAMERA: ESP32_CAMERA; 1X04
DISPLAY: DISPLAY; 1X04
EN: MOMENTARY-SWITCH-SPST-PTH-6.0MM; TACTILE_SWITCH_PTH_6.0MM
L3: 2112805; L2825P
LED1: LEDSML0805; SML0805
MCU_3_ESP32: ESP-32S
R5, R26, R105, R106: 4.7k; R0603
R27: 1k; R0603
R73, R74: 12k; R0805
R75: 220R; R0805
R98, R99, R103, R104, R111, R112, R113, R114, R115, R116, R117, R118: 10k; R0603
R100: 1M; R0603
R101, R102: nc; R0603
RGB_LED: RGB_LED; 1X04
RTCC: AB-RTCMC-32.768KHZ-B5ZE-S3-T
X5: FPS009-3000

Connections:
3V3: C67.2, C82.1, CAMERA.3, L3.2, MCU_3_ESP32.2 (3V3), R5.1, R26.1, R27.1, R73.1, R74.2, R98.2, R99.2, R101.1, R102.1, R103.2, R104.2, R105.2, R106.2, RTCC.1 (VDD); also elsewhere on the board
5V: DISPLAY.3; also elsewhere on the board
CP2102_RXD: MCU_3_ESP32.35 (U0TXD); also elsewhere on the board
CP2102_TXD: MCU_3_ESP32.34 (U0RXD); also elsewhere on the board
GND: BATT1.MINUS, BOOT.3 (2), BUTTONS.10, C1.2, C4.2, C67.1, C73.2, C74.2, C75.2, C76.2, C77.2, C78.2, C81.2, C82.2, CAMERA.4, DISPLAY.4, EN.3 (2), LED1.C, MCU_3_ESP32.1 (GND), MCU_3_ESP32.15 (GND), MCU_3_ESP32.38 (GND), MCU_3_ESP32.GND, R100.2, R111.2, R112.2, R113.2, R114.2, R115.2, R116.2, R117.2, R118.2, RGB_LED.4, RTCC.7 (VSS), X5.3, X5.6, X5.COM_TERM; also elsewhere on the board
MCU_3_BUTTON_0: BUTTONS.1, C1.1, MCU_3_ESP32.6 (IO34), R111.1
MCU_3_BUTTON_1: BUTTONS.2, C4.1, MCU_3_ESP32.7 (IO35), R112.1
MCU_3_BUTTON_2: BUTTONS.3, C73.1, MCU_3_ESP32.8 (IO32), R113.1
MCU_3_BUTTON_3: BUTTONS.4, C74.1, MCU_3_ESP32.9 (IO33), R114.1
MCU_3_BUTTON_4: BUTTONS.5, C75.1, MCU_3_ESP32.10 (IO25), R115.1
MCU_3_BUTTON_5: BUTTONS.6, C76.1, MCU_3_ESP32.11 (IO26), R116.1
MCU_3_BUTTON_6: BUTTONS.7, C77.1, MCU_3_ESP32.12 (IO27), R117.1
MCU_3_BUTTON_7: BUTTONS.8, C78.1, MCU_3_ESP32.13 (IO14), R118.1
MCU_3_I2C_SCL: DISPLAY.1, MCU_3_ESP32.36 (IO22), R5.2, R105.1, RTCC.3 (SCL); also elsewhere on the board
MCU_3_I2C_SDA: DISPLAY.2, MCU_3_ESP32.33 (IO21), R26.2, R106.1, RTCC.4 (SDA); also elsewhere on the board
MCU_3_LED_B: MCU_3_ESP32.23 (IO15), RGB_LED.3
MCU_3_LED_G: MCU_3_ESP32.24 (IO2), RGB_LED.2
MCU_3_LED_R: MCU_3_ESP32.26 (IO4), RGB_LED.1
MCU_3_SD_DET: MCU_3_ESP32.22 (SD1), R103.1, X5.DETECT
MCU_3_SD_WRTPT: MCU_3_ESP32.21 (SD0), R104.1, X5.WRITE_PROT
MCU_3_SPI_MISO: MCU_3_ESP32.31 (IO19), R99.1, X5.7
MCU_3_SPI_MOSI: MCU_3_ESP32.37 (IO23), R98.1, X5.2
MCU_3_SPI_SCK: MCU_3_ESP32.30 (IO18), X5.5
MCU_3_SPI_SS: MCU_3_ESP32.29 (IO5), R100.1, X5.1
MCU_3_TRIGGER_CAMERA: CAMERA.1, MCU_3_ESP32.14 (IO12)
MCU_3_UART1_RX: MCU_3_ESP32.17 (SD2); also elsewhere on the board
MCU_3_UART1_TX: MCU_3_ESP32.18 (SD3); also elsewhere on the board
MCU_3_UART2_RX: MCU_3_ESP32.27 (IO16); also elsewhere on the board
MCU_3_UART2_TX: MCU_3_ESP32.28 (IO17); also elsewhere on the board
unnamed: BUTTONS.9, R27.2
unnamed: BOOT.1, MCU_3_ESP32.25 (IO0), R74.1
unnamed: EN.1, MCU_3_ESP32.3 (EN), R73.2
unnamed: MCU_3_ESP32.16 (IO13), R75.2
unnamed: LED1.A, R75.1
unnamed: R102.2, X5.9
unnamed: R101.2, X5.8
unnamed: BATT1.PLUS, RTCC.8 (VBAT)
unnamed: C81.1, L3.1, X5.4

Notes on the sheet:
SD Card
RTCC
Accessories
ESP32
MCU_3 ESP32
