roravec/RastoBot/PCB/RastoBot-r2.brd

## EAGLE design PCB/RastoBot-r2.brd (continued)

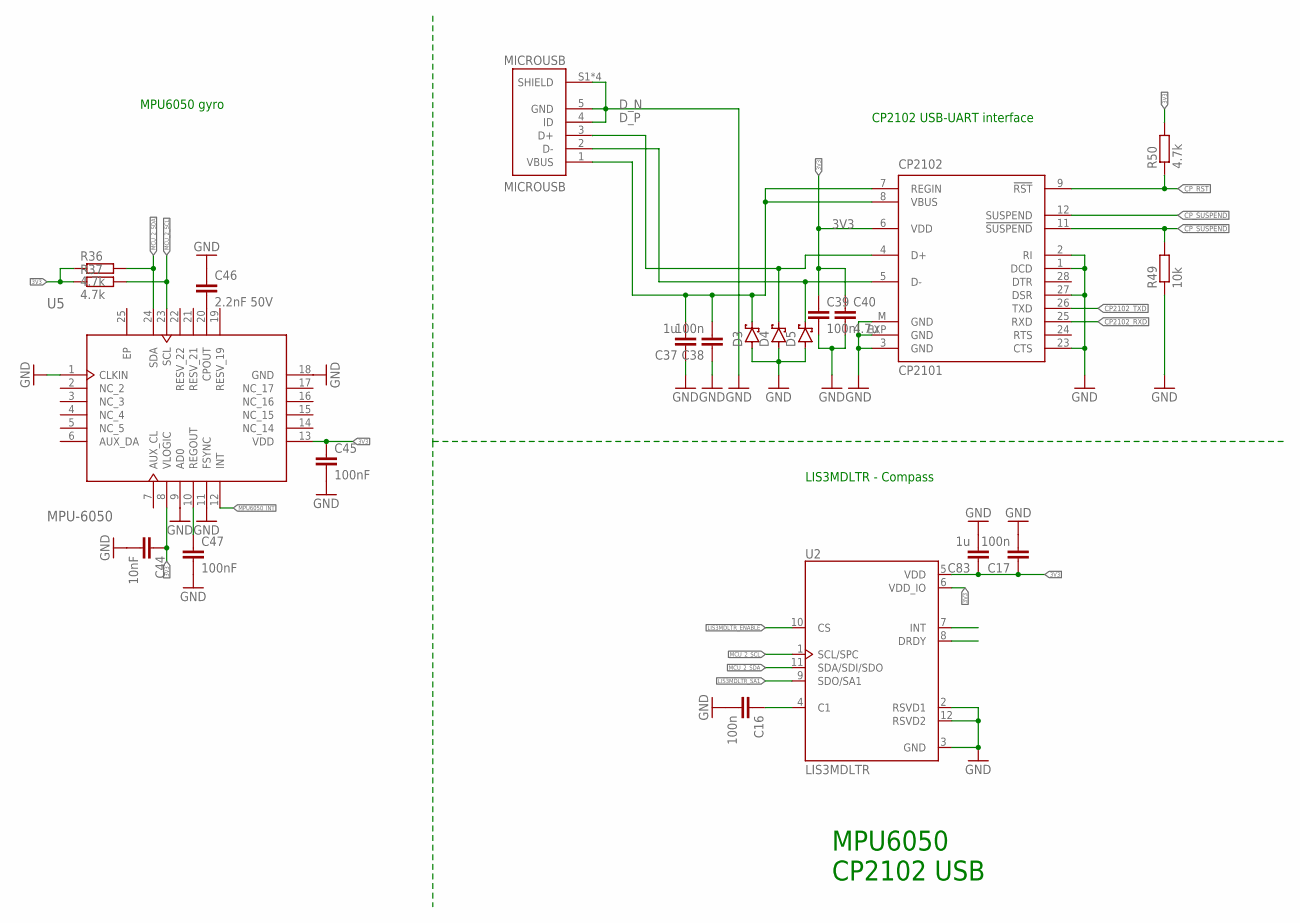
[picture p21: schematic RastoBot-r2.sch, sheet 6, CP2102]

Parts:
C16, C17, C38, C39: 100n; C0603
C37, C83: 1u; C0603
C40: 4.7u; C0603
C44: 10nF; C0603
C45, C47: 100nF; C0603
C46: 2.2nF 50V; C0603
CP2102: CP2101; MLP28
D3, D4, D5: BAT60J; SOD323_ST
MICROUSB: MICROUSB; MOLEX_47642-0001
R36, R37, R50: 4.7k; R0603
R49: 10k; R0603
U2: LIS3MDLTR; XDCR_LIS3MDLTR
U5: MPU-6050; 24-VFQFN

Connections:
3V3: C17.1, C39.1, C40.1, C44.1, C45.1, C83.1, CP2102.6 (VDD), R36.1, R37.1, R50.2, U2.5 (VDD), U2.6 (VDD_IO), U5.8 (VLOGIC), U5.13 (VDD); also elsewhere on the board
!CP_SUSPEND: CP2102.11 (!SUSPEND), R49.2
CP2102_RXD: CP2102.25 (RXD); also elsewhere on the board
CP2102_TXD: CP2102.26 (TXD); also elsewhere on the board
CP_RST: CP2102.9 (!RST), R50.1
CP_SUSPEND: CP2102.12 (SUSPEND)
D_N: CP2102.5 (D-), D5.C, MICROUSB.2 (D-)
D_P: CP2102.4 (D+), D4.C, MICROUSB.3 (D+)
EP: U5.25 (EP)
GND: C16.2, C17.2, C37.1, C38.1, C39.2, C40.2, C44.2, C45.2, C46.1, C47.2, C83.2, CP2102.1 (DCD), CP2102.2 (RI), CP2102.3 (GND), CP2102.23 (CTS), CP2102.27 (DSR), CP2102.EXP (GND), CP2102.M (GND), D3.A, D4.A, D5.A, MICROUSB.4 (ID), MICROUSB.5 (GND), MICROUSB.S1 (SHIELD), MICROUSB.S2 (SHIELD), MICROUSB.S3 (SHIELD), MICROUSB.S4 (SHIELD), R49.1, U2.2 (RSVD1), U2.3 (GND), U2.12 (RSVD2), U5.1 (CLKIN), U5.9 (AD0), U5.11 (FSYNC), U5.18 (GND); also elsewhere on the board
LIS3MDLTR_ENABLE: U2.10 (CS)
LIS3MDLTR_SA1: U2.9 (SDO/SA1)
MCU_2_SCL: R37.2, U2.1 (SCL/SPC), U5.23 (SCL); also elsewhere on the board
MCU_2_SDA: R36.2, U2.11 (SDA/SDI/SDO), U5.24 (SDA); also elsewhere on the board
MPU6050_INT: U5.12 (INT)
unnamed: C37.2, C38.2, CP2102.7 (REGIN), CP2102.8 (VBUS), D3.C, MICROUSB.1 (VBUS)
unnamed: C46.2, U5.20 (CPOUT)
unnamed: C47.1, U5.10 (REGOUT)
unnamed: C16.1, U2.4 (C1)

Notes on the sheet:
MPU6050 CP2102 USB
MPU6050 gyro
CP2102 USB-UART interface
LIS3MDLTR - Compass

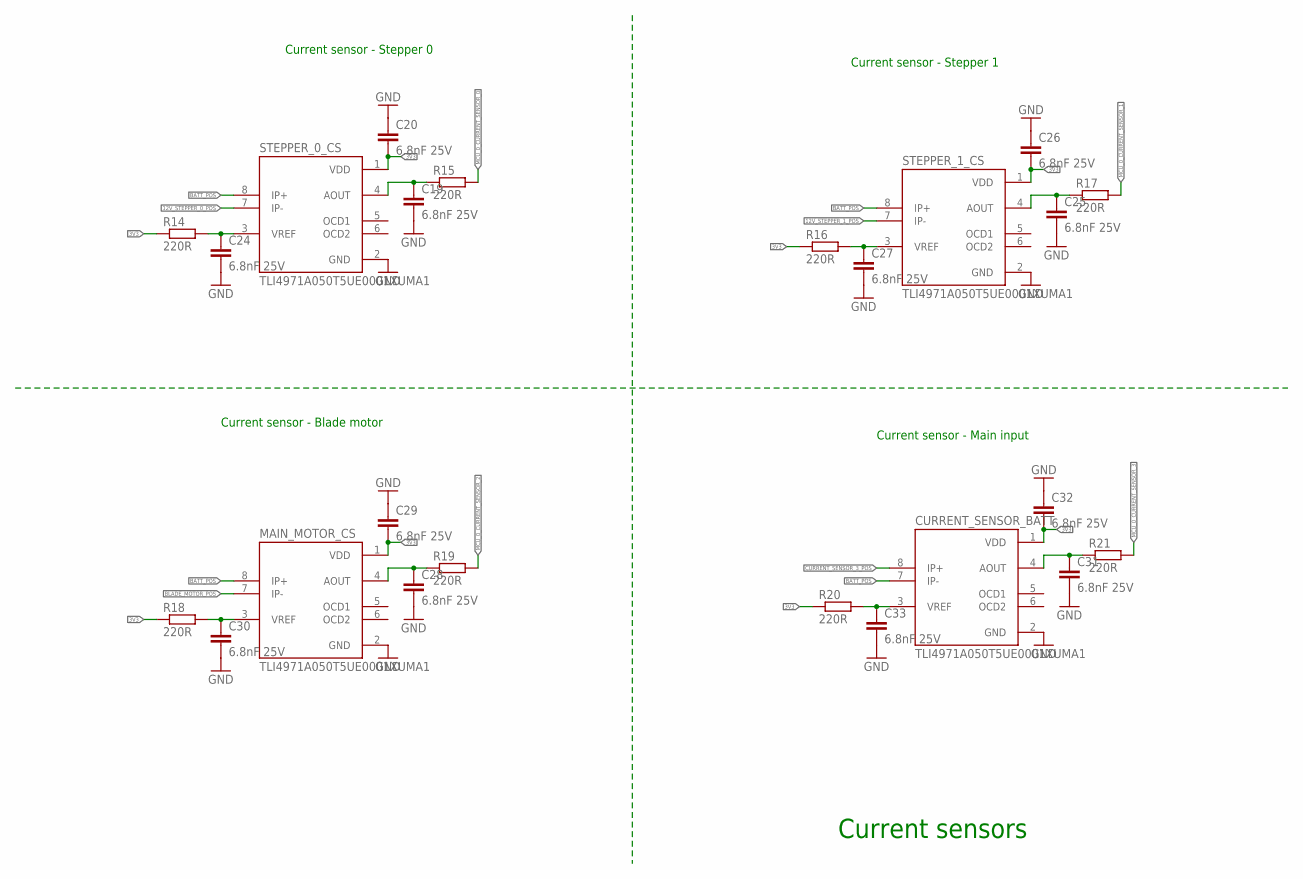
[picture p22: schematic RastoBot-r2.sch, sheet 7, Current sensors]

Parts:
C19, C20, C24, C25, C26, C27, C28, C29, C30, C31, C32, C33: 6.8nF 25V; C0603
CURRENT_SENSOR_BATT: TLI4971A050T5UE0001XUMA1; IC_TLI4971A050T5UE0001XUMA1
MAIN_MOTOR_CS: TLI4971A050T5UE0001XUMA1; IC_TLI4971A050T5UE0001XUMA1
R14, R15, R16, R17, R18, R19, R20, R21: 220R; R0805
STEPPER_0_CS, STEPPER_1_CS: TLI4971A050T5UE0001XUMA1; IC_TLI4971A050T5UE0001XUMA1

Connections:
3V3: C20.2, C26.2, C29.2, C32.2, CURRENT_SENSOR_BATT.1 (VDD), MAIN_MOTOR_CS.1 (VDD), R14.1, R16.1, R18.1, R20.1, STEPPER_0_CS.1 (VDD), STEPPER_1_CS.1 (VDD); also elsewhere on the board
12V_STEPPER_0_POS: STEPPER_0_CS.7 (IP-); also elsewhere on the board
12V_STEPPER_1_POS: STEPPER_1_CS.7 (IP-); also elsewhere on the board
BATT_POS: CURRENT_SENSOR_BATT.7 (IP-), MAIN_MOTOR_CS.8 (IP+), STEPPER_0_CS.8 (IP+), STEPPER_1_CS.8 (IP+); also elsewhere on the board
BLADE_MOTOR_POS: MAIN_MOTOR_CS.7 (IP-); also elsewhere on the board
CURRENT_SENSOR_3_POS: CURRENT_SENSOR_BATT.8 (IP+); also elsewhere on the board
GND: C19.2, C20.1, C24.2, C25.2, C26.1, C27.2, C28.2, C29.1, C30.2, C31.2, C32.1, C33.2, CURRENT_SENSOR_BATT.2 (GND), MAIN_MOTOR_CS.2 (GND), STEPPER_0_CS.2 (GND), STEPPER_1_CS.2 (GND); also elsewhere on the board
MCU_0_CURRENT_SENSOR_0: R15.2; also elsewhere on the board
MCU_0_CURRENT_SENSOR_1: R17.2; also elsewhere on the board
MCU_0_CURRENT_SENSOR_2: R19.2; also elsewhere on the board
MCU_0_CURRENT_SENSOR_3: R21.2; also elsewhere on the board
unnamed: C19.1, R15.1, STEPPER_0_CS.4 (AOUT)
unnamed: C27.1, R16.2, STEPPER_1_CS.3 (VREF)
unnamed: C25.1, R17.1, STEPPER_1_CS.4 (AOUT)
unnamed: C24.1, R14.2, STEPPER_0_CS.3 (VREF)
unnamed: C30.1, MAIN_MOTOR_CS.3 (VREF), R18.2
unnamed: C28.1, MAIN_MOTOR_CS.4 (AOUT), R19.1
unnamed: C33.1, CURRENT_SENSOR_BATT.3 (VREF), R20.2
unnamed: C31.1, CURRENT_SENSOR_BATT.4 (AOUT), R21.1

Notes on the sheet:
Current sensors
Current sensor - Stepper 0
Current sensor - Stepper 1
Current sensor - Blade motor
Current sensor - Main input

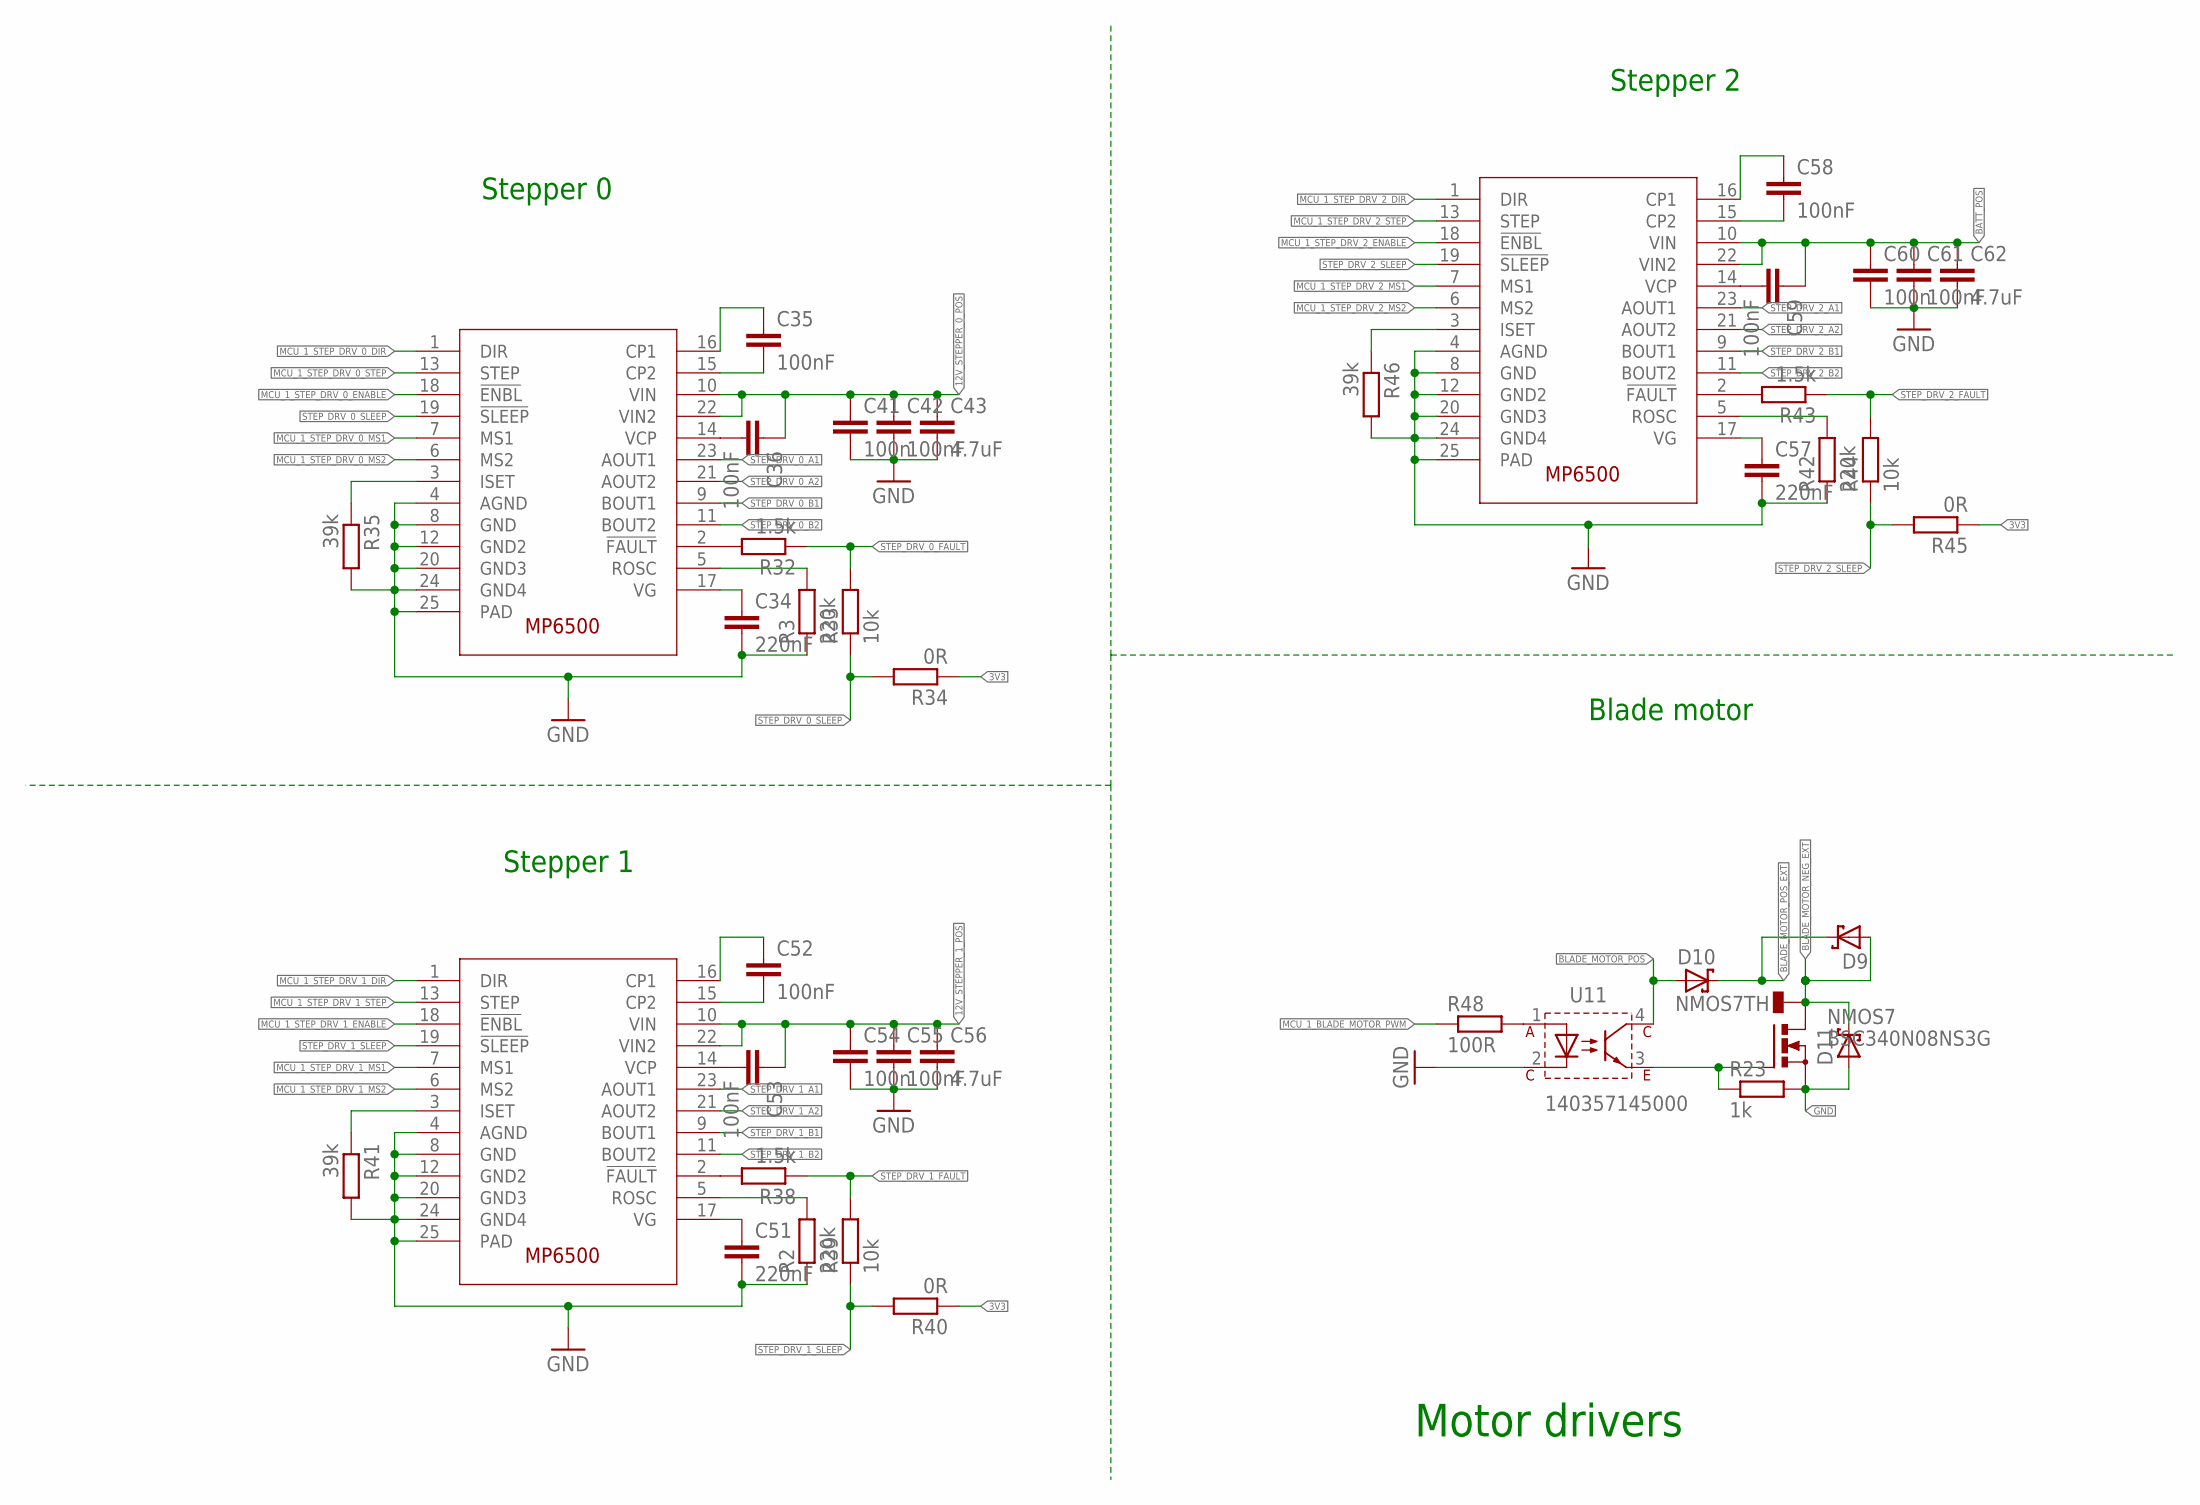
[picture p23: schematic RastoBot-r2.sch, sheet 8, Motor drivers]

Parts:
C34, C51, C57: 220nF; C0603
C35, C36, C42, C52, C53, C55, C58, C59, C61: 100nF; C0603
C41, C54, C60: 100n; C0603
C43, C56, C62: 4.7uF; C0603
D9, D10, D11: SCHOTTKY-DIODEAG; AG
NMOS7: BSC340N08NS3G; PG-TDSON-8
R2, R3, R42: 220k; R0603
R23: 1k; R0805
R32, R38, R43: 1.5k; R0603
R33, R39, R44: 10k; R0603
R34, R40, R45: 0R; R0603
R35, R41, R46: 39k; R0603
R48: 100R; R0805
SD1, SD2, SD3: MP6500; QFN65P500X500X100-25N
U11: 140357145000; WL-OCPT_SOP4

Connections:
3V3: R34.1, R40.1, R45.1; also elsewhere on the board
12V_STEPPER_0_POS: C36.1, C41.1, C42.1, C43.1, SD1.10 (VIN), SD1.22 (VIN2); also elsewhere on the board
12V_STEPPER_1_POS: C53.1, C54.1, C55.1, C56.1, SD2.10 (VIN), SD2.22 (VIN2); also elsewhere on the board
BATT_POS: C59.1, C60.1, C61.1, C62.1, SD3.10 (VIN), SD3.22 (VIN2); also elsewhere on the board
BLADE_MOTOR_NEG_EXT: D9.A, D11.C, NMOS7.5 (D), NMOS7.6 (D), NMOS7.7 (D), NMOS7.8 (D), NMOS7.TH; also elsewhere on the board
BLADE_MOTOR_POS: D10.A, U11.4; also elsewhere on the board
BLADE_MOTOR_POS_EXT: D9.C, D10.C; also elsewhere on the board
GND: C34.2, C41.2, C42.2, C43.2, C51.2, C54.2, C55.2, C56.2, C57.2, C60.2, C61.2, C62.2, D11.A, NMOS7.1 (S), NMOS7.2 (S), NMOS7.3 (S), R2.1, R3.1, R23.2, R35.2, R41.2, R42.1, R46.2, SD1.4 (AGND), SD1.8 (GND), SD1.12 (GND2), SD1.20 (GND3), SD1.24 (GND4), SD1.25 (PAD), SD2.4 (AGND), SD2.8 (GND), SD2.12 (GND2), SD2.20 (GND3), SD2.24 (GND4), SD2.25 (PAD), SD3.4 (AGND), SD3.8 (GND), SD3.12 (GND2), SD3.20 (GND3), SD3.24 (GND4), SD3.25 (PAD), U11.2; also elsewhere on the board
MCU_1_BLADE_MOTOR_PWM: R48.1; also elsewhere on the board
MCU_1_STEP_DRV_0_DIR: SD1.1 (DIR); also elsewhere on the board
MCU_1_STEP_DRV_0_ENABLE: SD1.18 (!ENBL); also elsewhere on the board
MCU_1_STEP_DRV_0_MS1: SD1.7 (MS1); also elsewhere on the board
MCU_1_STEP_DRV_0_MS2: SD1.6 (MS2); also elsewhere on the board
MCU_1_STEP_DRV_0_STEP: SD1.13 (STEP); also elsewhere on the board
MCU_1_STEP_DRV_1_DIR: SD2.1 (DIR); also elsewhere on the board
MCU_1_STEP_DRV_1_ENABLE: SD2.18 (!ENBL); also elsewhere on the board
MCU_1_STEP_DRV_1_MS1: SD2.7 (MS1); also elsewhere on the board
MCU_1_STEP_DRV_1_MS2: SD2.6 (MS2); also elsewhere on the board
MCU_1_STEP_DRV_1_STEP: SD2.13 (STEP); also elsewhere on the board
MCU_1_STEP_DRV_2_DIR: SD3.1 (DIR); also elsewhere on the board
MCU_1_STEP_DRV_2_ENABLE: SD3.18 (!ENBL); also elsewhere on the board
MCU_1_STEP_DRV_2_MS1: SD3.7 (MS1); also elsewhere on the board
MCU_1_STEP_DRV_2_MS2: SD3.6 (MS2); also elsewhere on the board
MCU_1_STEP_DRV_2_STEP: SD3.13 (STEP); also elsewhere on the board
unnamed: C34.1, SD1.17 (VG)
unnamed: R3.2, SD1.5 (ROSC)
unnamed: R48.2, U11.1
unnamed: NMOS7.4 (G), R23.1, U11.3
unnamed: C35.2, SD1.15 (CP2)
unnamed: C35.1, SD1.16 (CP1)
unnamed: R32.2, SD1.2 (!FAULT)
unnamed: C36.2, SD1.14 (VCP)
unnamed: C51.1, SD2.17 (VG)
unnamed: R35.1, SD1.3 (ISET)
unnamed: R2.2, SD2.5 (ROSC)
unnamed: C52.2, SD2.15 (CP2)
unnamed: C52.1, SD2.16 (CP1)
unnamed: C53.2, SD2.14 (VCP)
unnamed: R41.1, SD2.3 (ISET)
unnamed: R38.2, SD2.2 (!FAULT)
unnamed: C57.1, SD3.17 (VG)
unnamed: R42.2, SD3.5 (ROSC)
unnamed: C58.2, SD3.15 (CP2)
unnamed: C58.1, SD3.16 (CP1)
unnamed: C59.2, SD3.14 (VCP)
unnamed: R46.1, SD3.3 (ISET)
unnamed: R43.2, SD3.2 (!FAULT)
STEP_DRV_0_A1: SD1.23 (AOUT1); also elsewhere on the board
STEP_DRV_0_A2: SD1.21 (AOUT2); also elsewhere on the board
STEP_DRV_0_B1: SD1.9 (BOUT1); also elsewhere on the board
STEP_DRV_0_B2: SD1.11 (BOUT2); also elsewhere on the board
STEP_DRV_0_FAULT: R32.1, R33.2
STEP_DRV_0_SLEEP: R33.1, R34.2, SD1.19 (!SLEEP)
STEP_DRV_1_A1: SD2.23 (AOUT1); also elsewhere on the board
STEP_DRV_1_A2: SD2.21 (AOUT2); also elsewhere on the board
STEP_DRV_1_B1: SD2.9 (BOUT1); also elsewhere on the board
STEP_DRV_1_B2: SD2.11 (BOUT2); also elsewhere on the board
STEP_DRV_1_FAULT: R38.1, R39.2
STEP_DRV_1_SLEEP: R39.1, R40.2, SD2.19 (!SLEEP)
STEP_DRV_2_A1: SD3.23 (AOUT1); also elsewhere on the board
STEP_DRV_2_A2: SD3.21 (AOUT2); also elsewhere on the board
STEP_DRV_2_B1: SD3.9 (BOUT1); also elsewhere on the board
STEP_DRV_2_B2: SD3.11 (BOUT2); also elsewhere on the board
STEP_DRV_2_FAULT: R43.1, R44.2
STEP_DRV_2_SLEEP: R44.1, R45.2, SD3.19 (!SLEEP)

Notes on the sheet:
Stepper 0
Stepper 1
Stepper 2
Blade motor
Motor drivers

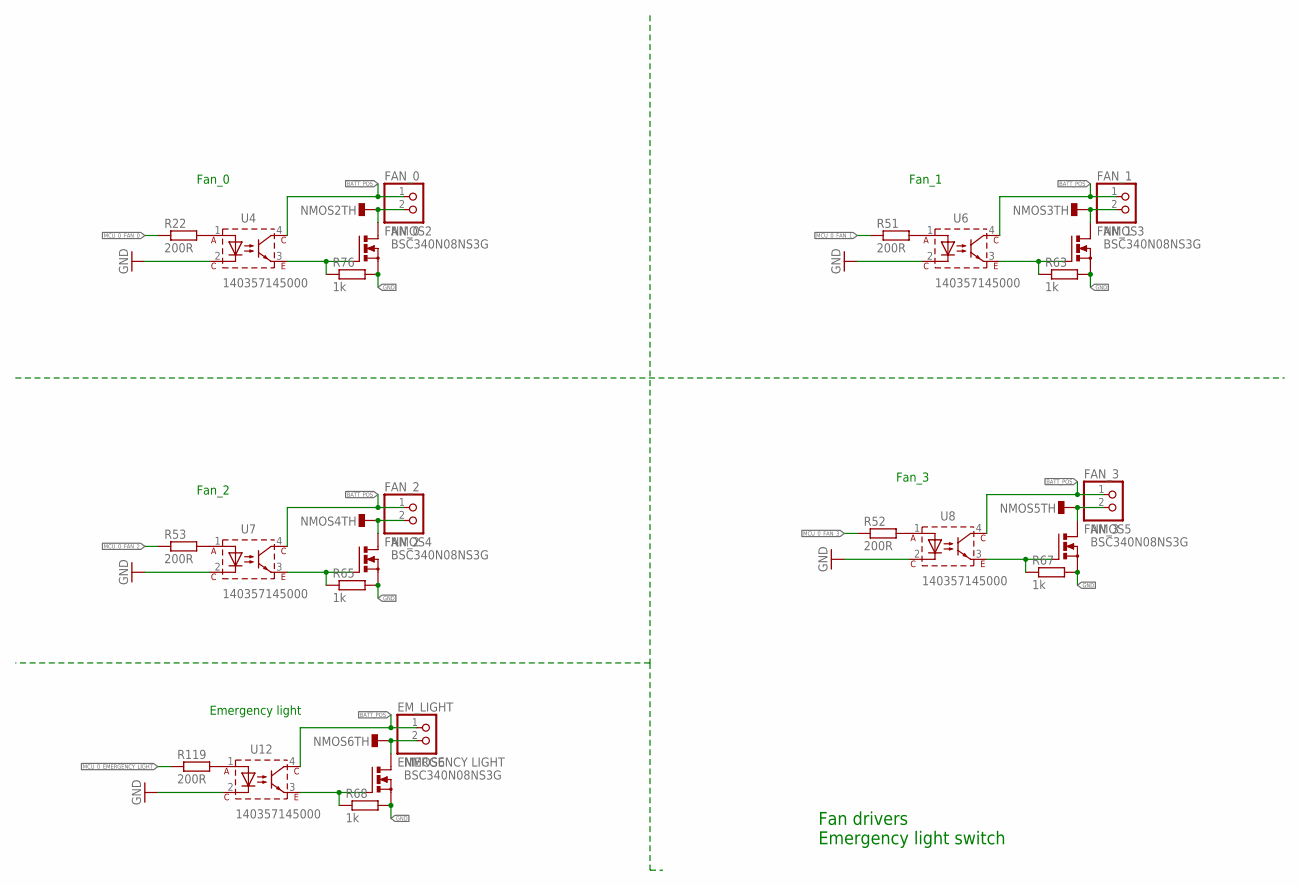
[picture p24: schematic RastoBot-r2.sch, sheet 9, Fans]

Parts:
EM_LIGHT: EMERGENCY LIGHT; 1X02
FAN_0: FAN_0; 1X02
FAN_1: FAN_1; 1X02
FAN_2: FAN_2; 1X02
FAN_3: FAN_3; 1X02
NMOS2, NMOS3, NMOS4, NMOS5, NMOS6: BSC340N08NS3G; PG-TDSON-8
R22, R51, R52, R53, R119: 200R; R0805
R63, R65, R67, R68, R76: 1k; R0805
U4, U6, U7, U8, U12: 140357145000; WL-OCPT_SOP4

Connections:
BATT_POS: EM_LIGHT.1, FAN_0.1, FAN_1.1, FAN_2.1, FAN_3.1, U4.4, U6.4, U7.4, U8.4, U12.4; also elsewhere on the board
GND: NMOS2.1 (S), NMOS2.2 (S), NMOS2.3 (S), NMOS3.1 (S), NMOS3.2 (S), NMOS3.3 (S), NMOS4.1 (S), NMOS4.2 (S), NMOS4.3 (S), NMOS5.1 (S), NMOS5.2 (S), NMOS5.3 (S), NMOS6.1 (S), NMOS6.2 (S), NMOS6.3 (S), R63.2, R65.2, R67.2, R68.2, R76.2, U4.2, U6.2, U7.2, U8.2, U12.2; also elsewhere on the board
MCU_0_EMERGENCY_LIGHT: R119.1; also elsewhere on the board
MCU_0_FAN_0: R22.1; also elsewhere on the board
MCU_0_FAN_1: R51.1; also elsewhere on the board
MCU_0_FAN_2: R53.1; also elsewhere on the board
MCU_0_FAN_3: R52.1; also elsewhere on the board
unnamed: NMOS6.4 (G), R68.1, U12.3
unnamed: EM_LIGHT.2, NMOS6.5 (D), NMOS6.6 (D), NMOS6.7 (D), NMOS6.8 (D), NMOS6.TH
unnamed: R119.2, U12.1
unnamed: R22.2, U4.1
unnamed: FAN_0.2, NMOS2.5 (D), NMOS2.6 (D), NMOS2.7 (D), NMOS2.8 (D), NMOS2.TH
unnamed: R51.2, U6.1
unnamed: R52.2, U8.1
unnamed: NMOS2.4 (G), R76.1, U4.3
unnamed: NMOS3.4 (G), R63.1, U6.3
unnamed: FAN_1.2, NMOS3.5 (D), NMOS3.6 (D), NMOS3.7 (D), NMOS3.8 (D), NMOS3.TH
unnamed: R53.2, U7.1
unnamed: NMOS4.4 (G), R65.1, U7.3
unnamed: FAN_2.2, NMOS4.5 (D), NMOS4.6 (D), NMOS4.7 (D), NMOS4.8 (D), NMOS4.TH
unnamed: NMOS5.4 (G), R67.1, U8.3
unnamed: FAN_3.2, NMOS5.5 (D), NMOS5.6 (D), NMOS5.7 (D), NMOS5.8 (D), NMOS5.TH

Notes on the sheet:
Fan_0
Fan_1
Fan_2
Fan_3
Fan drivers Emergency light switch
Emergency light

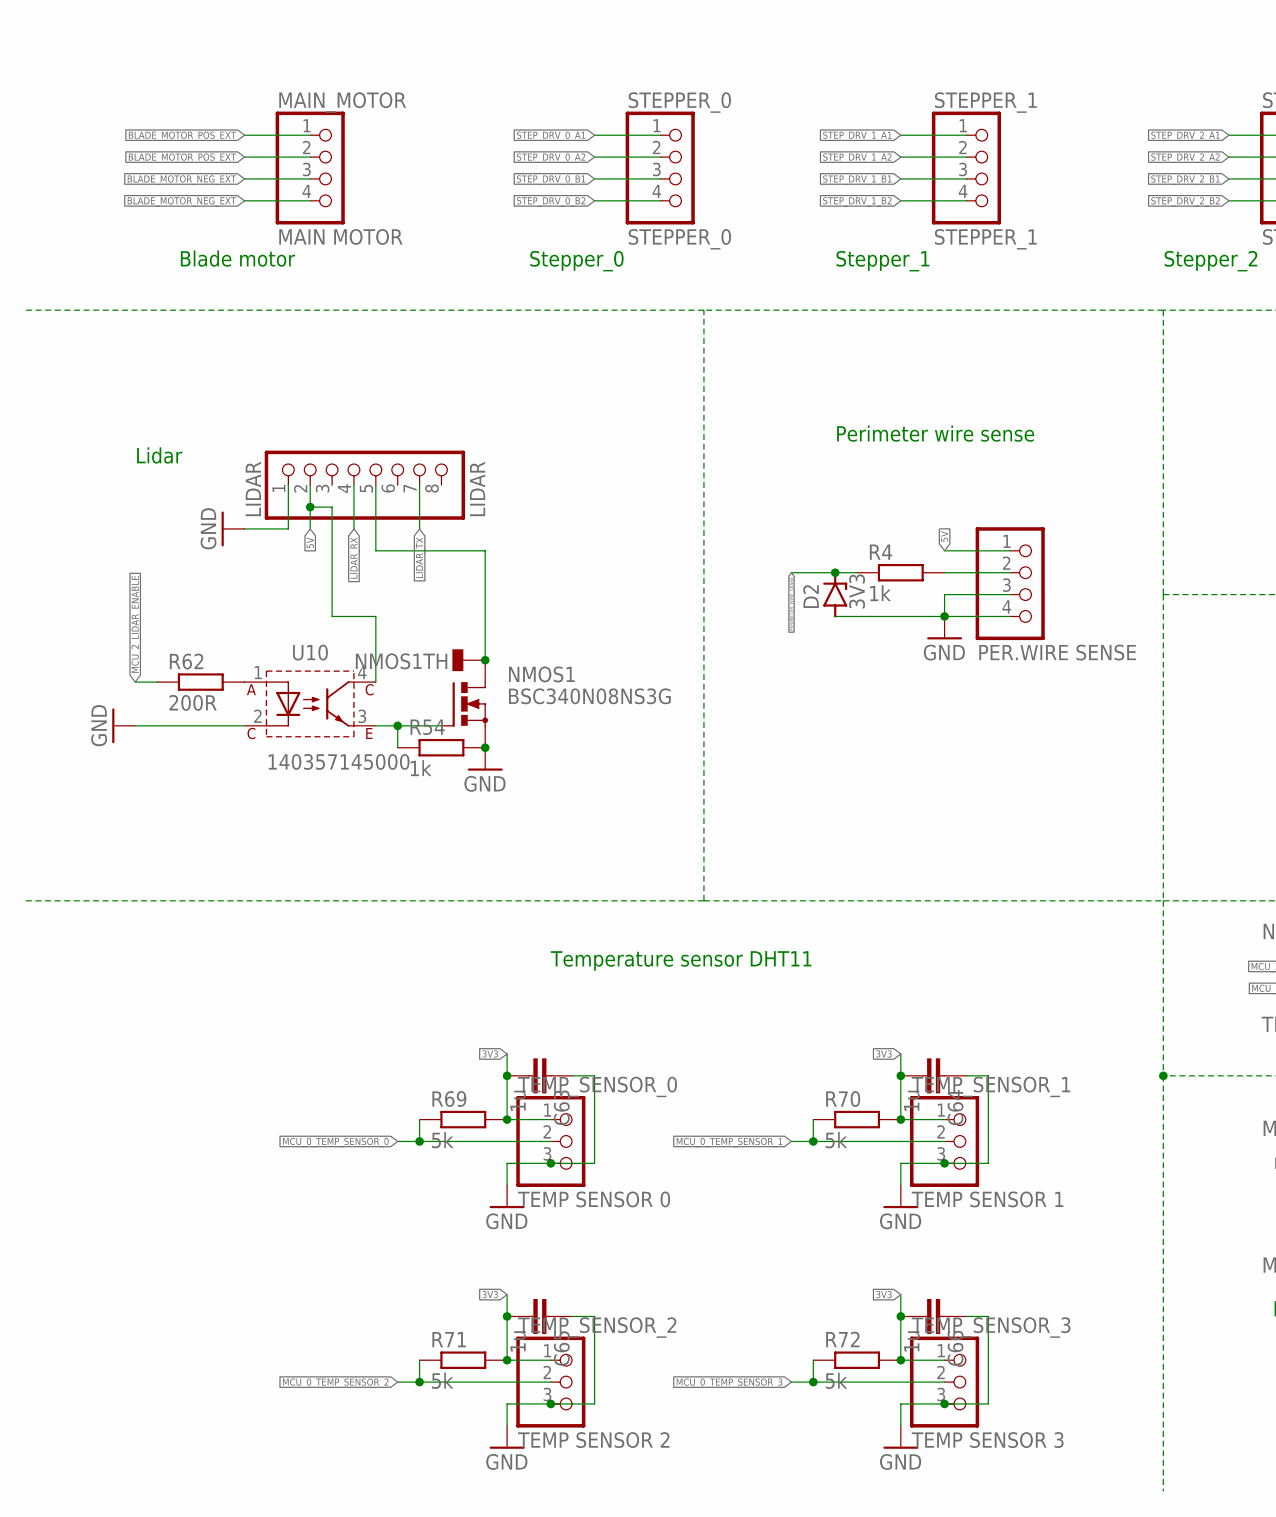
[picture p25: schematic RastoBot-r2.sch, sheet 10, Pinheaders, part in row 1, column 1]

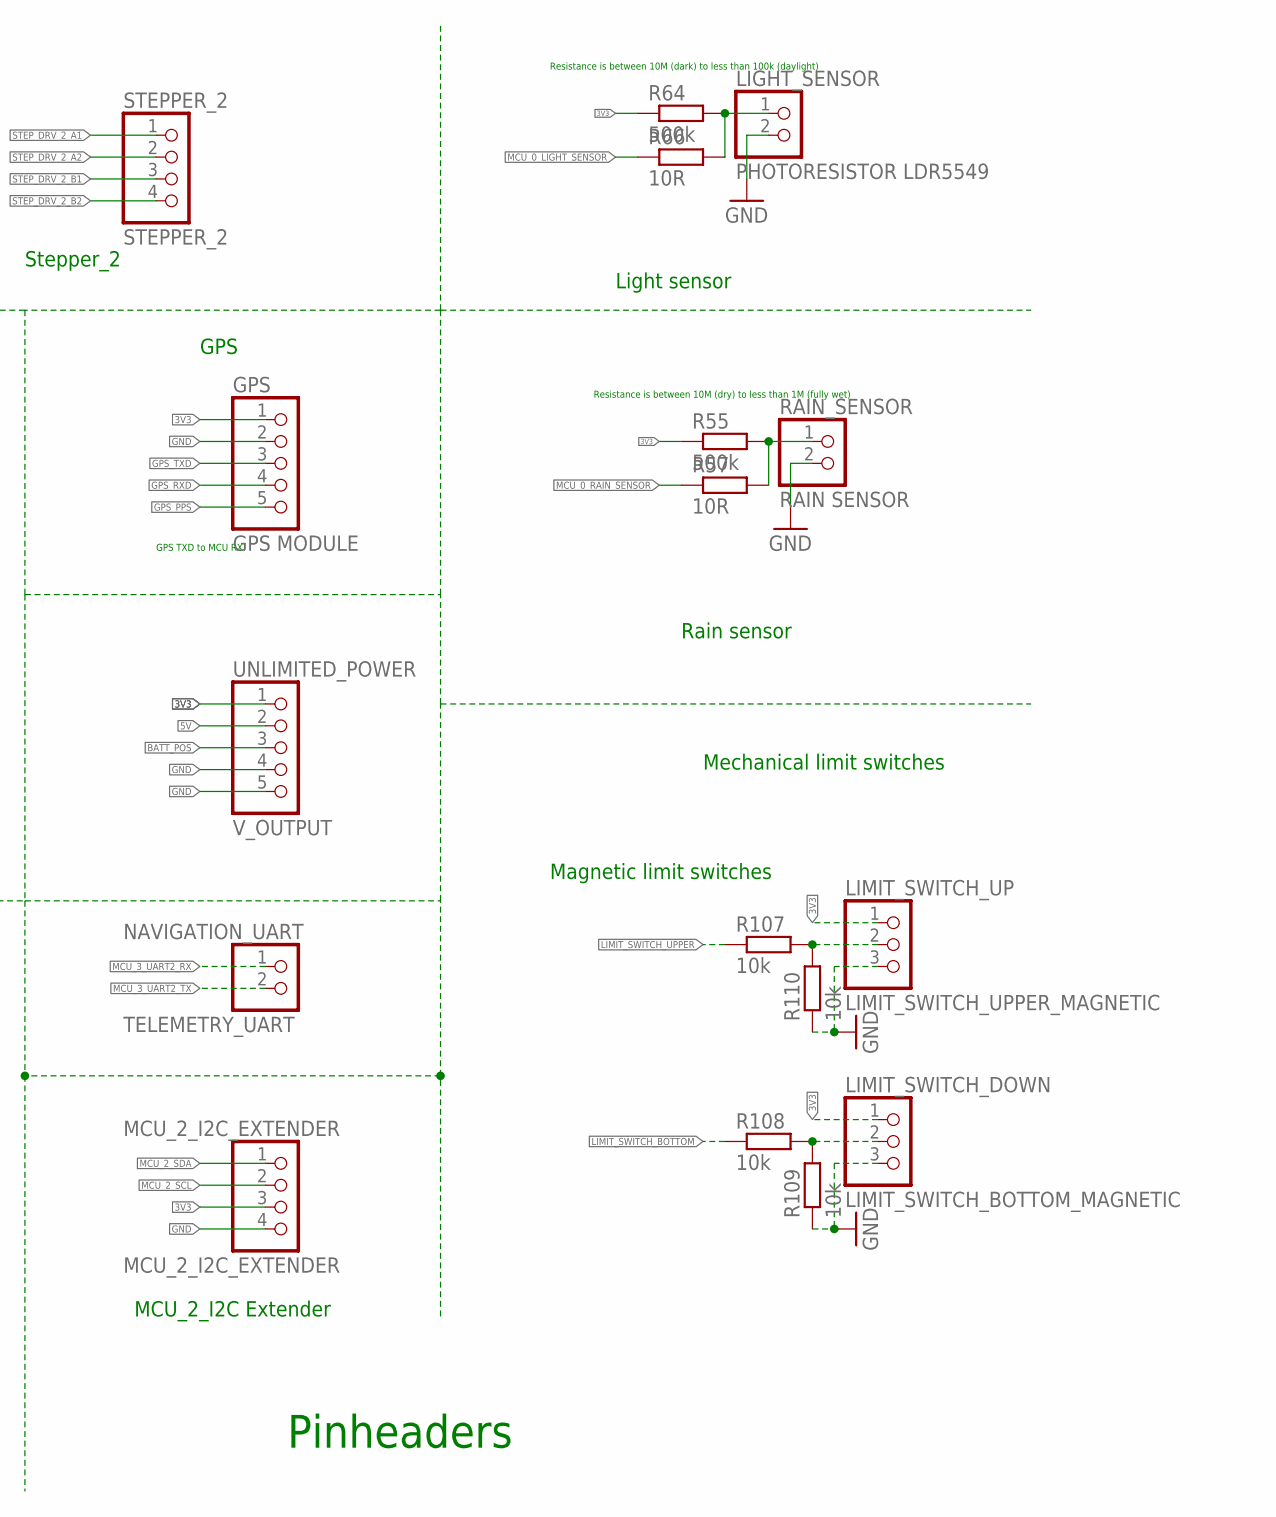
[picture p26: schematic RastoBot-r2.sch, sheet 10, Pinheaders, part in row 1, column 2]

Parts:
C63, C64, C65, C66: 1u; C0603
D2: 3V3; SOD80C
GPS: GPS MODULE; 1X05
LIDAR: LIDAR; 1X08
LIGHT_SENSOR: PHOTORESISTOR LDR5549; 1X02
LIMIT_SWITCH_DOWN: LIMIT_SWITCH_BOTTOM_MAGNETIC; 1X03
LIMIT_SWITCH_UP: LIMIT_SWITCH_UPPER_MAGNETIC; 1X03
MAIN_MOTOR: MAIN MOTOR; 1X04
MCU_2_I2C_EXTENDER: MCU_2_I2C_EXTENDER; 1X04
NAVIGATION_UART: TELEMETRY_UART; 1X02
NMOS1: BSC340N08NS3G; PG-TDSON-8
PERIMETER_WIRE: PER.WIRE SENSE; 1X04
R4, R54: 1k; R0805
R55, R64: 500k; R0805
R57, R66: 10R; R0805
R62: 200R; R0805
R69, R71, R72: 5k; R0805
R70: 5k; R0603
R107, R108, R109, R110: 10k; R0805
RAIN_SENSOR: RAIN SENSOR; 1X02
STEPPER_0: STEPPER_0; 1X04
STEPPER_1: STEPPER_1; 1X04
STEPPER_2: STEPPER_2; 1X04
TEMP_SENSOR_0: TEMP SENSOR 0; 1X03
TEMP_SENSOR_1: TEMP SENSOR 1; 1X03
TEMP_SENSOR_2: TEMP SENSOR 2; 1X03
TEMP_SENSOR_3: TEMP SENSOR 3; 1X03
U10: 140357145000; WL-OCPT_SOP4
UNLIMITED_POWER: V_OUTPUT; 1X05

Connections:
3V3: C63.2, C64.2, C65.2, C66.2, GPS.1, LIMIT_SWITCH_DOWN.1, LIMIT_SWITCH_UP.1, MCU_2_I2C_EXTENDER.3, R55.1, R64.1, R69.2, R70.2, R71.2, R72.2, TEMP_SENSOR_0.1, TEMP_SENSOR_1.1, TEMP_SENSOR_2.1, TEMP_SENSOR_3.1, UNLIMITED_POWER.1; also elsewhere on the board
5V: LIDAR.2, PERIMETER_WIRE.1, U10.4, UNLIMITED_POWER.2; also elsewhere on the board
BATT_POS: UNLIMITED_POWER.3; also elsewhere on the board
BLADE_MOTOR_NEG_EXT: MAIN_MOTOR.3, MAIN_MOTOR.4; also elsewhere on the board
BLADE_MOTOR_POS_EXT: MAIN_MOTOR.1, MAIN_MOTOR.2; also elsewhere on the board
GND: C63.1, C64.1, C65.1, C66.1, D2.A, GPS.2, LIDAR.1, LIGHT_SENSOR.2, LIMIT_SWITCH_DOWN.3, LIMIT_SWITCH_UP.3, MCU_2_I2C_EXTENDER.4, NMOS1.1 (S), NMOS1.2 (S), NMOS1.3 (S), PERIMETER_WIRE.3, PERIMETER_WIRE.4, R54.2, R109.1, R110.1, RAIN_SENSOR.2, TEMP_SENSOR_0.3, TEMP_SENSOR_1.3, TEMP_SENSOR_2.3, TEMP_SENSOR_3.3, U10.2, UNLIMITED_POWER.4, UNLIMITED_POWER.5; also elsewhere on the board
GPS_PPS: GPS.5
GPS_RXD: GPS.4; also elsewhere on the board
GPS_TXD: GPS.3; also elsewhere on the board
LIDAR_RX: LIDAR.4; also elsewhere on the board
LIDAR_TX: LIDAR.7; also elsewhere on the board
LIMIT_SWITCH_BOTTOM: R108.1; also elsewhere on the board
LIMIT_SWITCH_UPPER: R107.1; also elsewhere on the board
MCU_0_LIGHT_SENSOR: R66.1; also elsewhere on the board
MCU_0_RAIN_SENSOR: R57.1; also elsewhere on the board
MCU_0_TEMP_SENSOR_0: R69.1, TEMP_SENSOR_0.2; also elsewhere on the board
MCU_0_TEMP_SENSOR_1: R70.1, TEMP_SENSOR_1.2; also elsewhere on the board
MCU_0_TEMP_SENSOR_2: R71.1, TEMP_SENSOR_2.2; also elsewhere on the board
MCU_0_TEMP_SENSOR_3: R72.1, TEMP_SENSOR_3.2; also elsewhere on the board
MCU_2_LIDAR_ENABLE: R62.1; also elsewhere on the board
MCU_2_SCL: MCU_2_I2C_EXTENDER.2; also elsewhere on the board
MCU_2_SDA: MCU_2_I2C_EXTENDER.1; also elsewhere on the board
MCU_3_UART2_RX: NAVIGATION_UART.1; also elsewhere on the board
MCU_3_UART2_TX: NAVIGATION_UART.2; also elsewhere on the board
unnamed: PERIMETER_WIRE.2, R4.2
unnamed: LIDAR.5, NMOS1.5 (D), NMOS1.6 (D), NMOS1.7 (D), NMOS1.8 (D), NMOS1.TH
unnamed: LIGHT_SENSOR.1, R64.2, R66.2
unnamed: NMOS1.4 (G), R54.1, U10.3
unnamed: R55.2, R57.2, RAIN_SENSOR.1
unnamed: R62.2, U10.1
unnamed: LIMIT_SWITCH_DOWN.2, R108.2, R109.2
unnamed: LIMIT_SWITCH_UP.2, R107.2, R110.2
PERIMETER_WIRE_SENSE: D2.C, R4.1; also elsewhere on the board
STEP_DRV_0_A1: STEPPER_0.1; also elsewhere on the board
STEP_DRV_0_A2: STEPPER_0.2; also elsewhere on the board
STEP_DRV_0_B1: STEPPER_0.3; also elsewhere on the board
STEP_DRV_0_B2: STEPPER_0.4; also elsewhere on the board
STEP_DRV_1_A1: STEPPER_1.1; also elsewhere on the board
STEP_DRV_1_A2: STEPPER_1.2; also elsewhere on the board
STEP_DRV_1_B1: STEPPER_1.3; also elsewhere on the board
STEP_DRV_1_B2: STEPPER_1.4; also elsewhere on the board
STEP_DRV_2_A1: STEPPER_2.1; also elsewhere on the board
STEP_DRV_2_A2: STEPPER_2.2; also elsewhere on the board
STEP_DRV_2_B1: STEPPER_2.3; also elsewhere on the board
STEP_DRV_2_B2: STEPPER_2.4; also elsewhere on the board

Notes on the sheet:
GPS TXD to MCU RX!
Resistance is between 10M (dry) to less than 1M (fully wet)
Blade motor
Stepper_0
Stepper_1
Stepper_2
GPS
Rain sensor
Mechanical limit switches
Temperature sensor DHT11
Perimeter wire sense
Lidar
Magnetic limit switches
Pinheaders
Resistance is between 10M (dark) to less than 100k (daylight)
Light sensor
MCU_2_I2C Extender

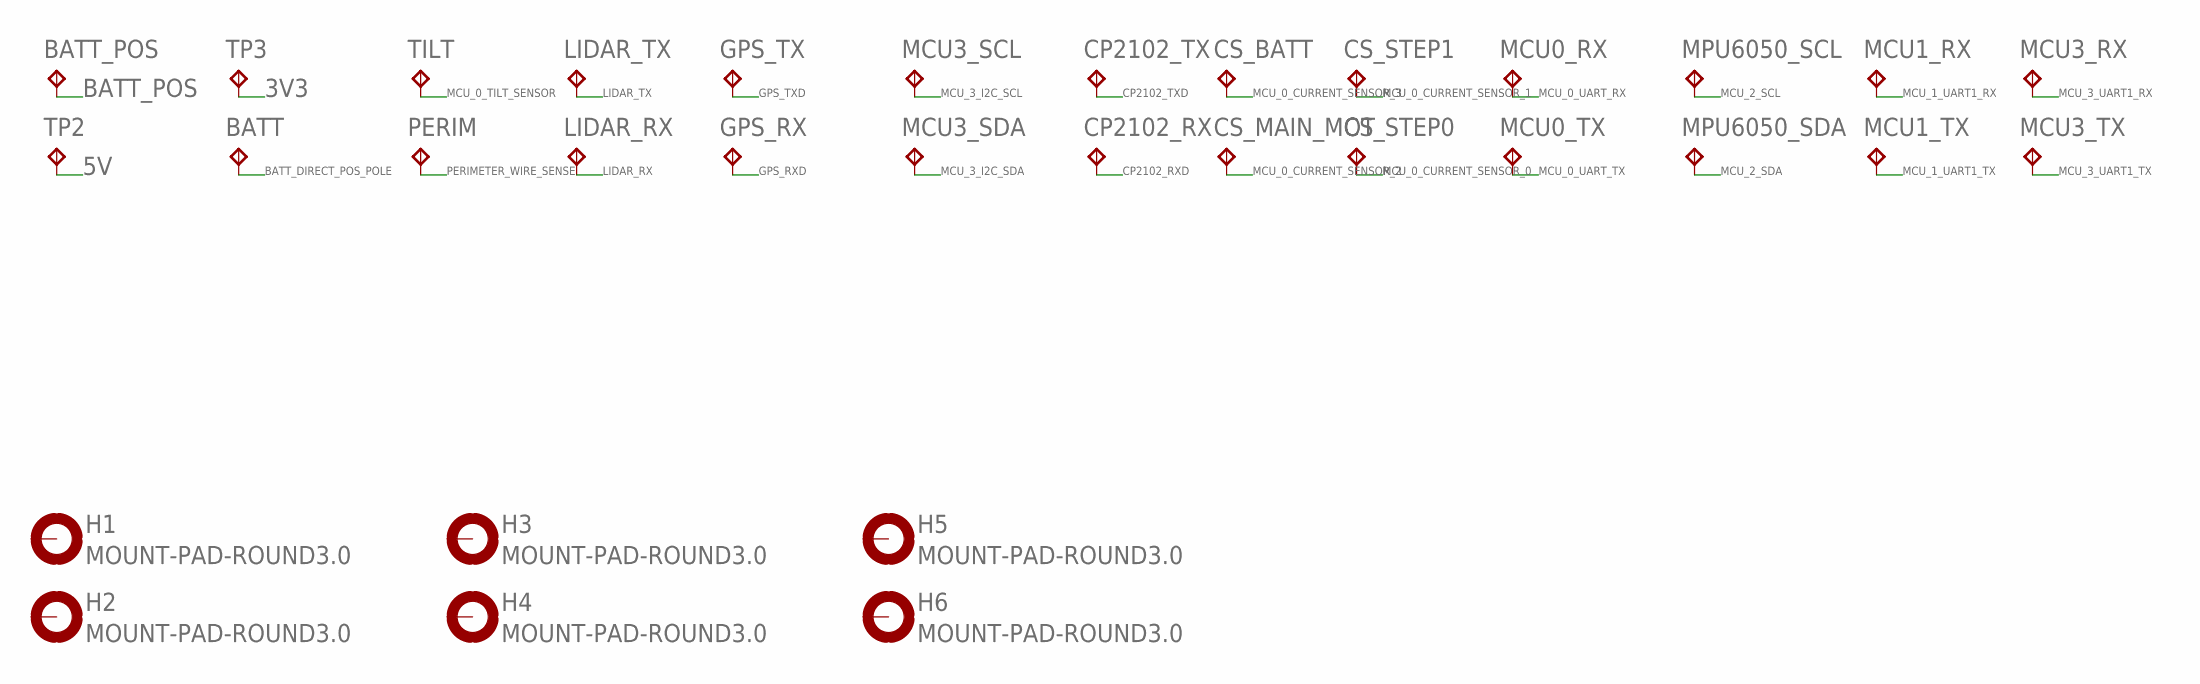
[picture p27: schematic RastoBot-r2.sch, sheet 11, Misc]

Parts:
BATT: TPB1,27; B1,27
BATT_POS: TPB1,27; B1,27
CP2102_RX, CP2102_TX: TPB1,27; B1,27
CS_BATT: TPB1,27; B1,27
CS_MAIN_MOT: TPB1,27; B1,27
CS_STEP0, CS_STEP1: TPB1,27; B1,27
GPS_RX: TPB1,27; B1,27
GPS_TX: TPB1,27; B1,27
H1, H2, H3, H4, H5, H6: MOUNT-PAD-ROUND3.0; 3,0-PAD
LIDAR_RX: TPB1,27; B1,27
LIDAR_TX: TPB1,27; B1,27
MCU0_RX, MCU0_TX, MCU1_RX, MCU1_TX, MCU3_RX, MCU3_SCL, MCU3_SDA, MCU3_TX: TPB1,27; B1,27
MPU6050_SCL, MPU6050_SDA: TPB1,27; B1,27
PERIM: TPB1,27; B1,27
TILT: TPB1,27; B1,27
TP2, TP3: TPB1,27; B1,27

Connections:
3V3: TP3.TP; also elsewhere on the board
5V: TP2.TP; also elsewhere on the board
BATT_DIRECT_POS_POLE: BATT.TP; also elsewhere on the board
BATT_POS: BATT_POS.TP; also elsewhere on the board
CP2102_RXD: CP2102_RX.TP; also elsewhere on the board
CP2102_TXD: CP2102_TX.TP; also elsewhere on the board
GPS_RXD: GPS_RX.TP; also elsewhere on the board
GPS_TXD: GPS_TX.TP; also elsewhere on the board
LIDAR_RX: LIDAR_RX.TP; also elsewhere on the board
LIDAR_TX: LIDAR_TX.TP; also elsewhere on the board
MCU_0_CURRENT_SENSOR_0: CS_STEP0.TP; also elsewhere on the board
MCU_0_CURRENT_SENSOR_1: CS_STEP1.TP; also elsewhere on the board
MCU_0_CURRENT_SENSOR_2: CS_MAIN_MOT.TP; also elsewhere on the board
MCU_0_CURRENT_SENSOR_3: CS_BATT.TP; also elsewhere on the board
MCU_0_TILT_SENSOR: TILT.TP; also elsewhere on the board
MCU_0_UART_RX: MCU0_RX.TP; also elsewhere on the board
MCU_0_UART_TX: MCU0_TX.TP; also elsewhere on the board
MCU_1_UART1_RX: MCU1_RX.TP; also elsewhere on the board
MCU_1_UART1_TX: MCU1_TX.TP; also elsewhere on the board
MCU_2_SCL: MPU6050_SCL.TP; also elsewhere on the board
MCU_2_SDA: MPU6050_SDA.TP; also elsewhere on the board
MCU_3_I2C_SCL: MCU3_SCL.TP; also elsewhere on the board
MCU_3_I2C_SDA: MCU3_SDA.TP; also elsewhere on the board
MCU_3_UART1_RX: MCU3_RX.TP; also elsewhere on the board
MCU_3_UART1_TX: MCU3_TX.TP; also elsewhere on the board
PERIMETER_WIRE_SENSE: PERIM.TP; also elsewhere on the board
