roravec/RastoBot/PCB/RastoBot-r2.brd

## EAGLE design PCB/RastoBot-r2.brd (continued)

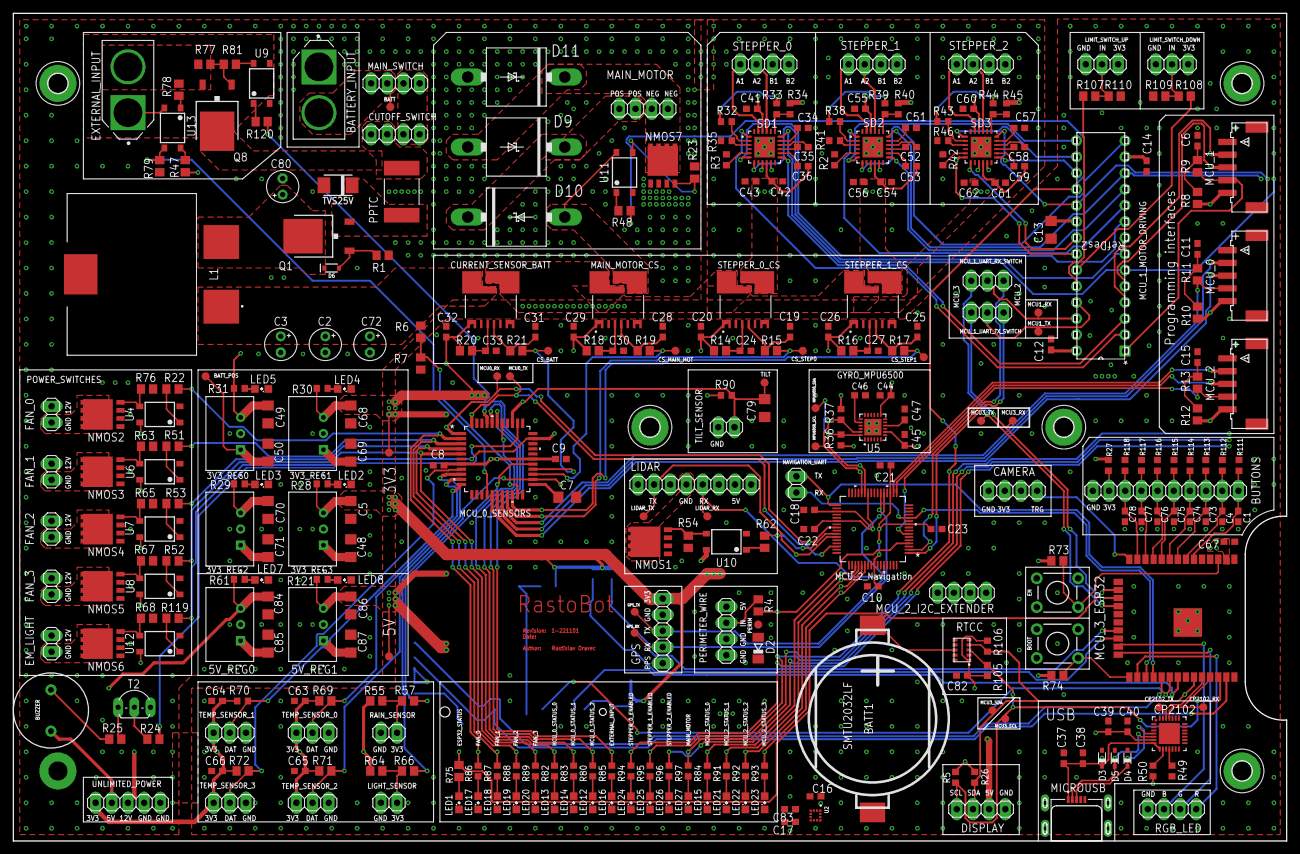
[picture p28: board RastoBot-r2.brd from above]

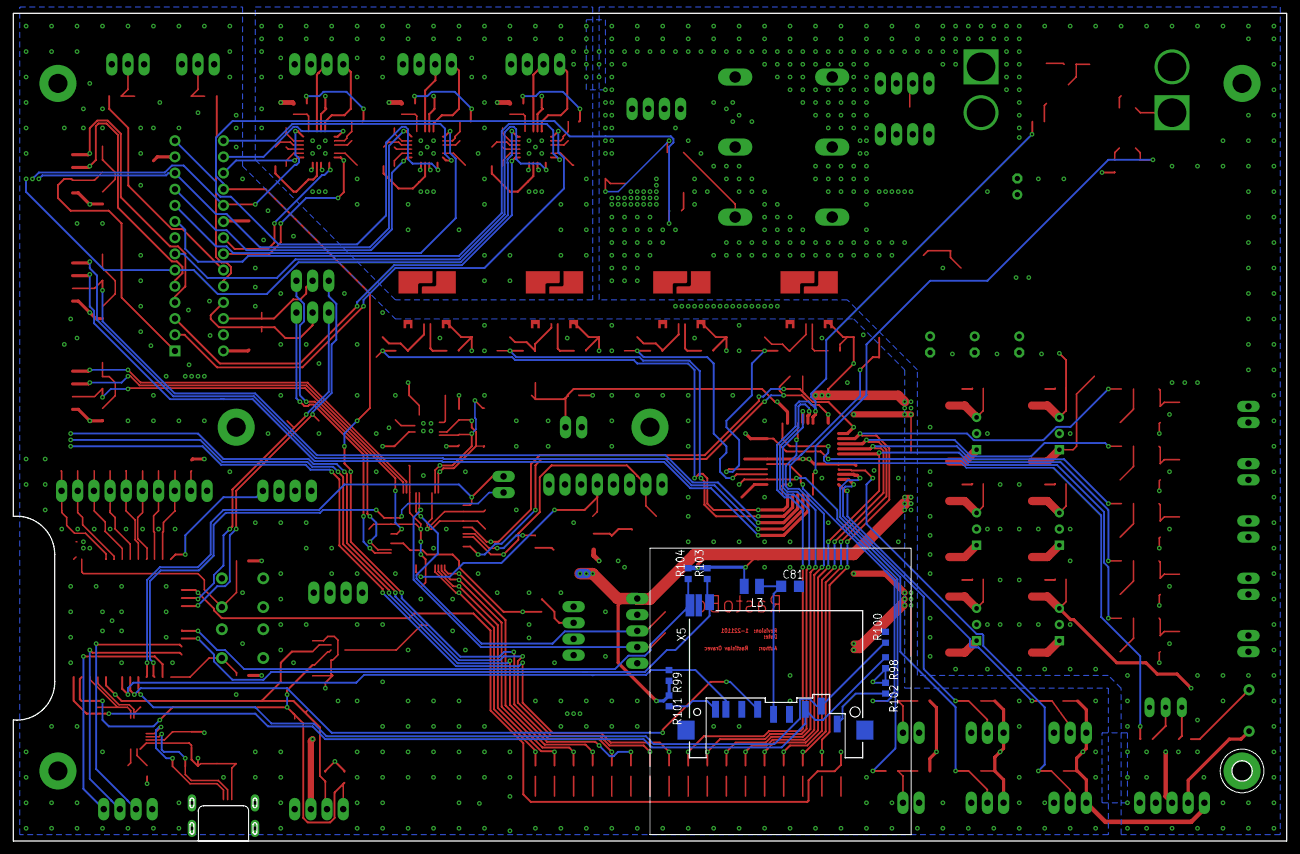
[picture p29: board RastoBot-r2.brd from below]

Board: 4 copper layers, 200.0 x 130.0 mm, 354 parts (11 on the bottom side), 236 nets.
