roravec/RastoBot/PCB/2grounds_backup_220922/RastoMower.brd

## EAGLE design PCB/2grounds_backup_220922/RastoMower.brd (2023-02-13)

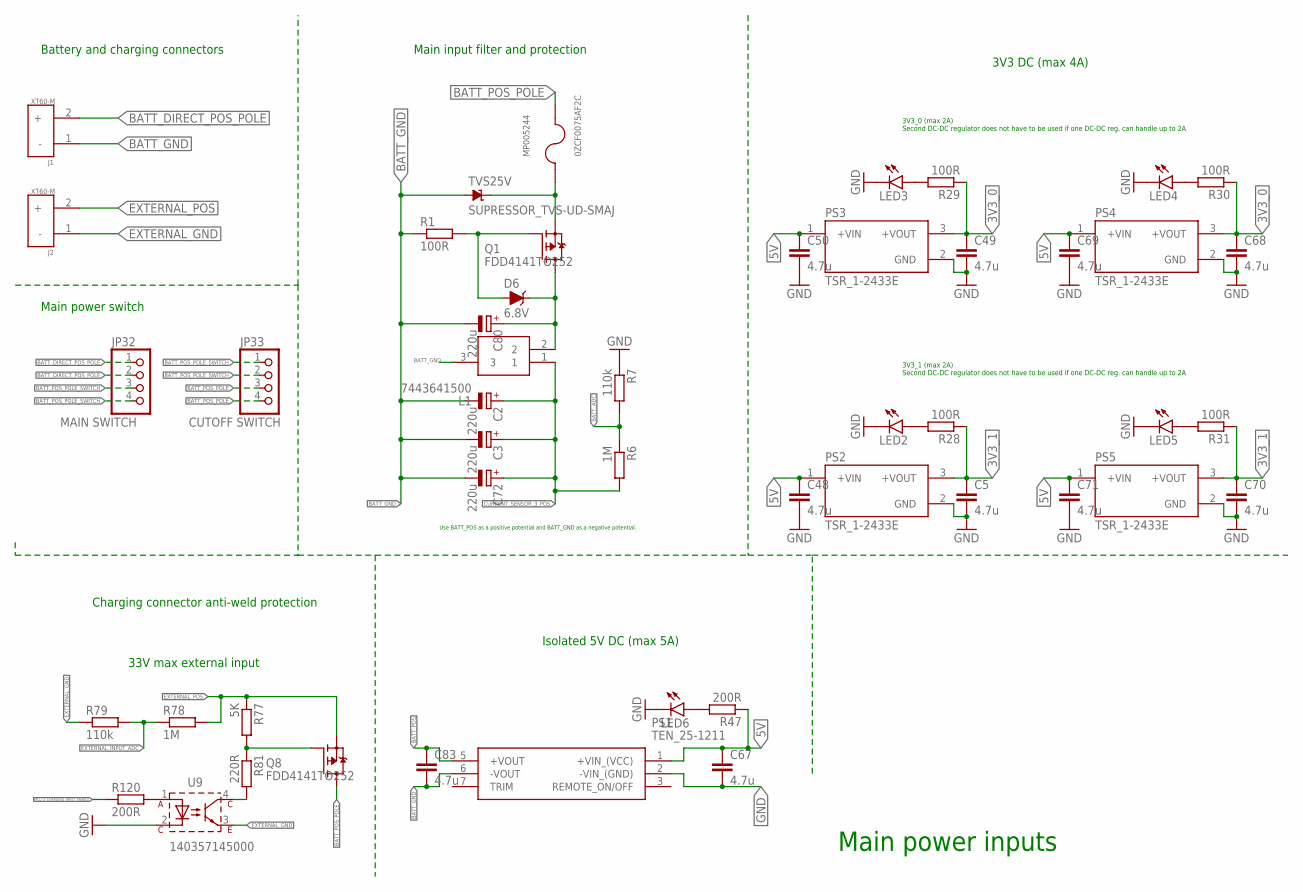
[picture p30: schematic RastoMower.sch, sheet 1, Inputs]

Parts:
C2, C3, C72, C80: 220u; E2,5-5
C5, C48, C49, C50, C67, C68, C69, C70, C71, C83: 4.7u; C1206
D6: 6.8V; SOD-323
J1, J2: XT60-M; AMASS_XT60-M
JP32: MAIN SWITCH; 1X04
JP33: CUTOFF SWITCH; 1X04
L1: 7443641500; 74436413300
LED2, LED3, LED4, LED5, LED6: LEDSML0805; SML0805
MP005244: 0ZCF0075AF2C; FUSE_0ZCF0075AF2C
PS1: TEN_25-1211; TEN251211
PS2, PS3, PS4, PS5: TSR_1-2433E; CONV_TSR_1-2433E
Q1, Q8: FDD4141TO252; TO252
R1: 100R; R0805
R6, R78: 1M; R0805
R7, R79: 110k; R0805
R28, R29, R30, R31: 100R; R0603
R47: 200R; R0603
R77: 5K; R0805
R81: 220R; R0805
R120: 200R; R0805
TVS25V: SUPRESSOR_TVS-UD-SMAJ; SUPRESSOR_SMAJ
U9: 140357145000; WL-OCPT_SOP4

Connections:
3V3_0: C49.1, C68.1, PS3.3 (+VOUT), PS4.3 (+VOUT), R29.1, R30.1; also elsewhere on the board
3V3_1: C5.1, C70.1, PS2.3 (+VOUT), PS5.3 (+VOUT), R28.1, R31.1; also elsewhere on the board
5V: C48.1, C50.1, C67.1, C69.1, C71.1, PS1.1 (+VIN_(VCC)), PS2.1 (+VIN), PS3.1 (+VIN), PS4.1 (+VIN), PS5.1 (+VIN), R47.1; also elsewhere on the board
BATT_ADC: R6.1, R7.2; also elsewhere on the board
BATT_DIRECT_POS_POLE: J1.2 (+), JP32.1, JP32.2
BATT_GND: C2.-, C3.-, C72.-, C80.-, C83.2, J1.1 (-), L1.3, PS1.6 (-VOUT), R1.1, TVS25V.A; also elsewhere on the board
BATT_POS: C83.1, PS1.5 (+VOUT); also elsewhere on the board
BATT_POS_POLE: JP33.3, JP33.4, MP005244.2, Q8.3 (D)
BATT_POS_POLE_SWITCH: JP32.3, JP32.4, JP33.1, JP33.2
CURRENT_SENSOR_3_POS: C2.+, C3.+, C72.+, L1.1, R6.2; also elsewhere on the board
EXTERNAL_GND: J2.1 (-), R79.1, U9.3
EXTERNAL_INPUT_ADC: R78.1, R79.2; also elsewhere on the board
EXTERNAL_POS: J2.2 (+), Q8.2 (S), R77.1, R78.2
GND: C5.2, C48.2, C49.2, C50.2, C67.2, C68.2, C69.2, C70.2, C71.2, LED2.C, LED3.C, LED4.C, LED5.C, LED6.C, PS1.2 (-VIN_(GND)), PS2.2 (GND), PS3.2 (GND), PS4.2 (GND), PS5.2 (GND), R7.1, U9.2; also elsewhere on the board
MCU_0_CHARGING_INPUT_ENABLE: R120.1; also elsewhere on the board
unnamed: D6.A, Q1.1 (G), R1.2
unnamed: C80.+, D6.C, L1.2, Q1.3 (D)
unnamed: MP005244.1, Q1.2 (S), TVS25V.C
unnamed: LED2.A, R28.2
unnamed: LED3.A, R29.2
unnamed: LED4.A, R30.2
unnamed: LED5.A, R31.2
unnamed: LED6.A, R47.2
unnamed: R120.2, U9.1
unnamed: Q8.1 (G), R77.2, R81.1
unnamed: R81.2, U9.4

Notes on the sheet:
33V max external input
Charging connector anti-weld protection
Use BATT_POS as a positive potential and BATT_GND as a negative potential.
Main power inputs
Isolated 5V DC (max 5A)
3V3 DC (max 4A)
3V3_0 (max 2A) Second DC-DC regulator does not have to be used if one DC-DC reg. can handle up to 2A
3V3_1 (max 2A) Second DC-DC regulator does not have to be used if one DC-DC reg. can handle up to 2A
Main input filter and protection
Battery and charging connectors
Main power switch

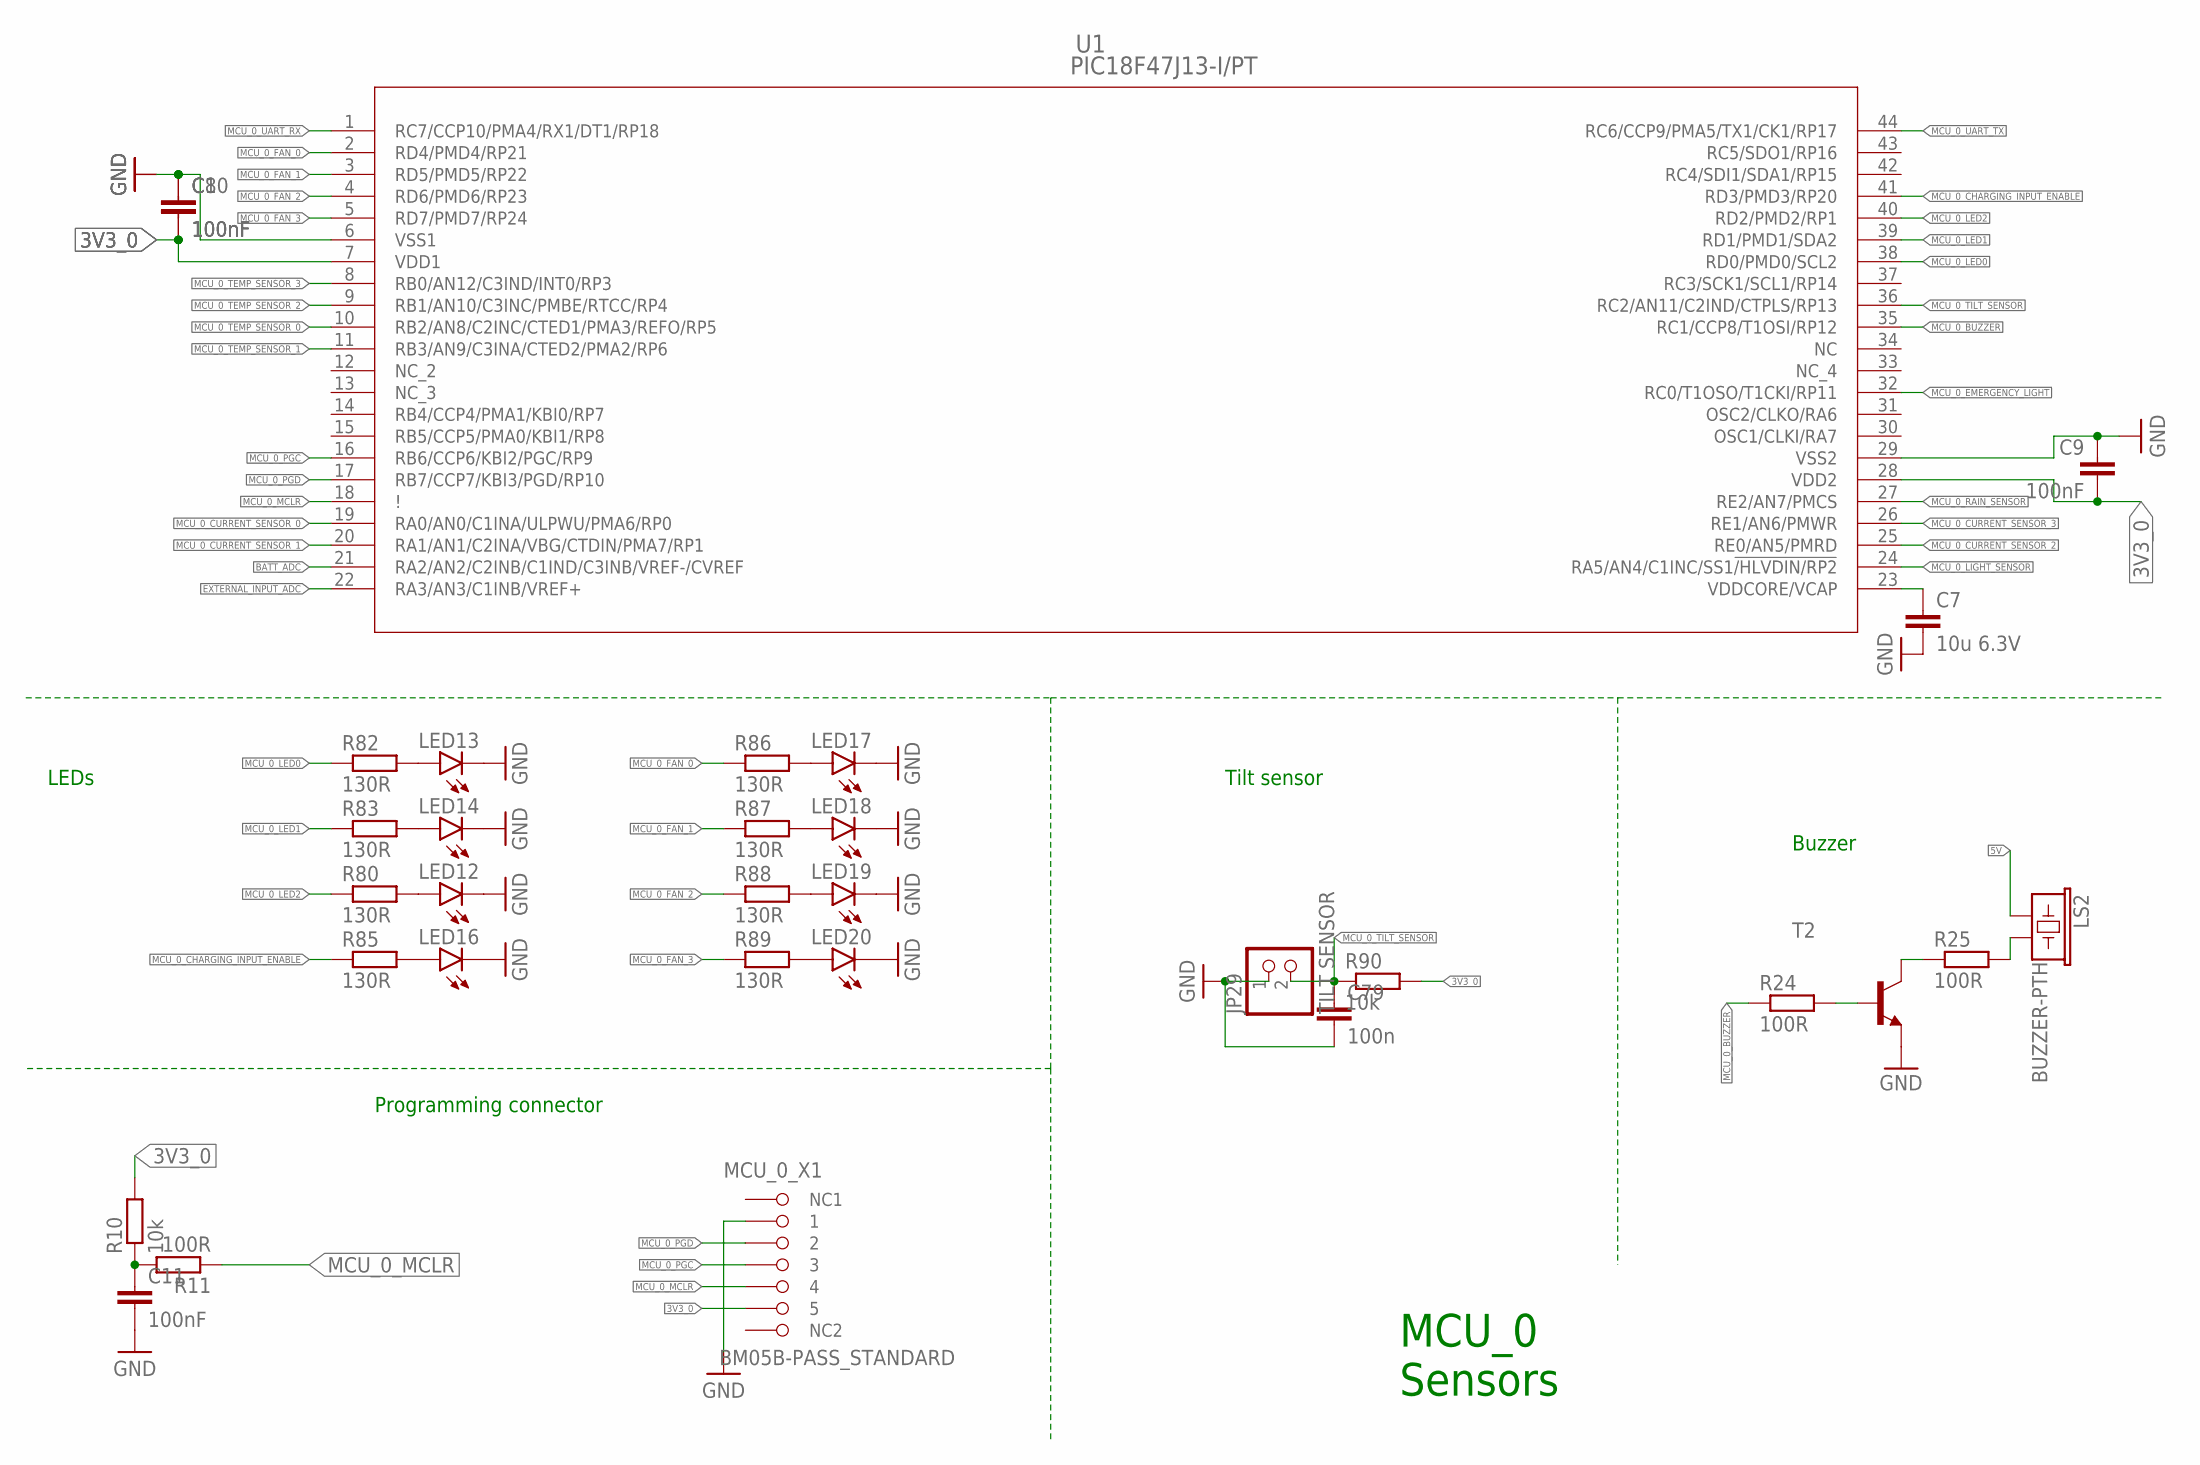
[picture p31: schematic RastoMower.sch, sheet 2, MCU_0 PIC18 Sensors]

Parts:
C7: 10u 6.3V; C1206
C8, C9, C10, C11: 100nF; C0603
C79: 100n; C1206
JP29: TILT SENSOR; 1X02
LED12, LED13, LED14, LED16, LED17, LED18, LED19, LED20: LEDSML0805; SML0805
LS2: BUZZER-PTH; BUZZER-12MM
MCU_0_X1: BM05B-PASS_STANDARD; BM05B-PASS
R10: 10k; R0805
R11, R24, R25: 100R; R0805
R80, R82, R83, R85, R86, R87, R88, R89: 130R; R0603
R90: 10k; R0603
T2: BC547-NPN-TO92-CBE; TO92-CBE
U1: PIC18F47J13-I/PT; TQFP44_10X10MC_MCH

Connections:
3V3_0: C8.2, C9.2, C10.2, MCU_0_X1.P$5 (5), R10.2, R90.2, U1.7 (VDD1), U1.28 (VDD2); also elsewhere on the board
5V: LS2.+ (1); also elsewhere on the board
BATT_ADC: U1.21 (RA2/AN2/C2INB/C1IND/C3INB/VREF-/CVREF); also elsewhere on the board
EXTERNAL_INPUT_ADC: U1.22 (RA3/AN3/C1INB/VREF+); also elsewhere on the board
GND: C7.2, C8.1, C9.1, C10.1, C11.2, C79.2, JP29.1, LED12.C, LED13.C, LED14.C, LED16.C, LED17.C, LED18.C, LED19.C, LED20.C, T2.E, U1.6 (VSS1), U1.29 (VSS2); also elsewhere on the board
MCU_0_BUZZER: R24.1, U1.35 (RC1/CCP8/T1OSI/RP12)
MCU_0_CHARGING_INPUT_ENABLE: R85.1, U1.41 (RD3/PMD3/RP20); also elsewhere on the board
MCU_0_CURRENT_SENSOR_0: U1.19 (RA0/AN0/C1INA/ULPWU/PMA6/RP0); also elsewhere on the board
MCU_0_CURRENT_SENSOR_1: U1.20 (RA1/AN1/C2INA/VBG/CTDIN/PMA7/RP1); also elsewhere on the board
MCU_0_CURRENT_SENSOR_2: U1.25 (RE0/AN5/PMRD); also elsewhere on the board
MCU_0_CURRENT_SENSOR_3: U1.26 (RE1/AN6/PMWR); also elsewhere on the board
MCU_0_EMERGENCY_LIGHT: U1.32 (RC0/T1OSO/T1CKI/RP11); also elsewhere on the board
MCU_0_FAN_0: R86.1, U1.2 (RD4/PMD4/RP21); also elsewhere on the board
MCU_0_FAN_1: R87.1, U1.3 (RD5/PMD5/RP22); also elsewhere on the board
MCU_0_FAN_2: R88.1, U1.4 (RD6/PMD6/RP23); also elsewhere on the board
MCU_0_FAN_3: R89.1, U1.5 (RD7/PMD7/RP24); also elsewhere on the board
MCU_0_LED0: R82.1, U1.38 (RD0/PMD0/SCL2)
MCU_0_LED1: R83.1, U1.39 (RD1/PMD1/SDA2)
MCU_0_LED2: R80.1, U1.40 (RD2/PMD2/RP1)
MCU_0_LIGHT_SENSOR: U1.24 (RA5/AN4/C1INC/SS1!/HLVDIN/RP2); also elsewhere on the board
MCU_0_MCLR: MCU_0_X1.P$4 (4), R11.1, U1.18 (!)
MCU_0_PGC: MCU_0_X1.P$3 (3), U1.16 (RB6/CCP6/KBI2/PGC/RP9)
MCU_0_PGD: MCU_0_X1.P$2 (2), U1.17 (RB7/CCP7/KBI3/PGD/RP10)
MCU_0_RAIN_SENSOR: U1.27 (RE2/AN7/PMCS); also elsewhere on the board
MCU_0_TEMP_SENSOR_0: U1.10 (RB2/AN8/C2INC/CTED1/PMA3/REFO/RP5); also elsewhere on the board
MCU_0_TEMP_SENSOR_1: U1.11 (RB3/AN9/C3INA/CTED2/PMA2/RP6); also elsewhere on the board
MCU_0_TEMP_SENSOR_2: U1.9 (RB1/AN10/C3INC/PMBE/RTCC/RP4); also elsewhere on the board
MCU_0_TEMP_SENSOR_3: U1.8 (RB0/AN12/C3IND/INT0/RP3); also elsewhere on the board
MCU_0_TILT_SENSOR: C79.1, JP29.2, R90.1, U1.36 (RC2/AN11/C2IND/CTPLS/RP13)
MCU_0_UART_RX: U1.1 (RC7/CCP10/PMA4/RX1/DT1/RP18); also elsewhere on the board
MCU_0_UART_TX: U1.44 (RC6/CCP9/PMA5/TX1/CK1/RP17); also elsewhere on the board
unnamed 128: MCU_0_X1.P$1 (1); also elsewhere on the board
unnamed: C7.1, U1.23 (VDDCORE/VCAP)
unnamed: C11.1, R10.1, R11.2
unnamed: R24.2, T2.B
unnamed: LS2.- (2), R25.2
unnamed: R25.1, T2.C
unnamed: LED12.A, R80.2
unnamed: LED13.A, R82.2
unnamed: LED14.A, R83.2
unnamed: LED16.A, R85.2
unnamed: LED17.A, R86.2
unnamed: LED18.A, R87.2
unnamed: LED19.A, R88.2
unnamed: LED20.A, R89.2

Notes on the sheet:
Buzzer
MCU_0 Sensors
Tilt sensor
LEDs
Programming connector

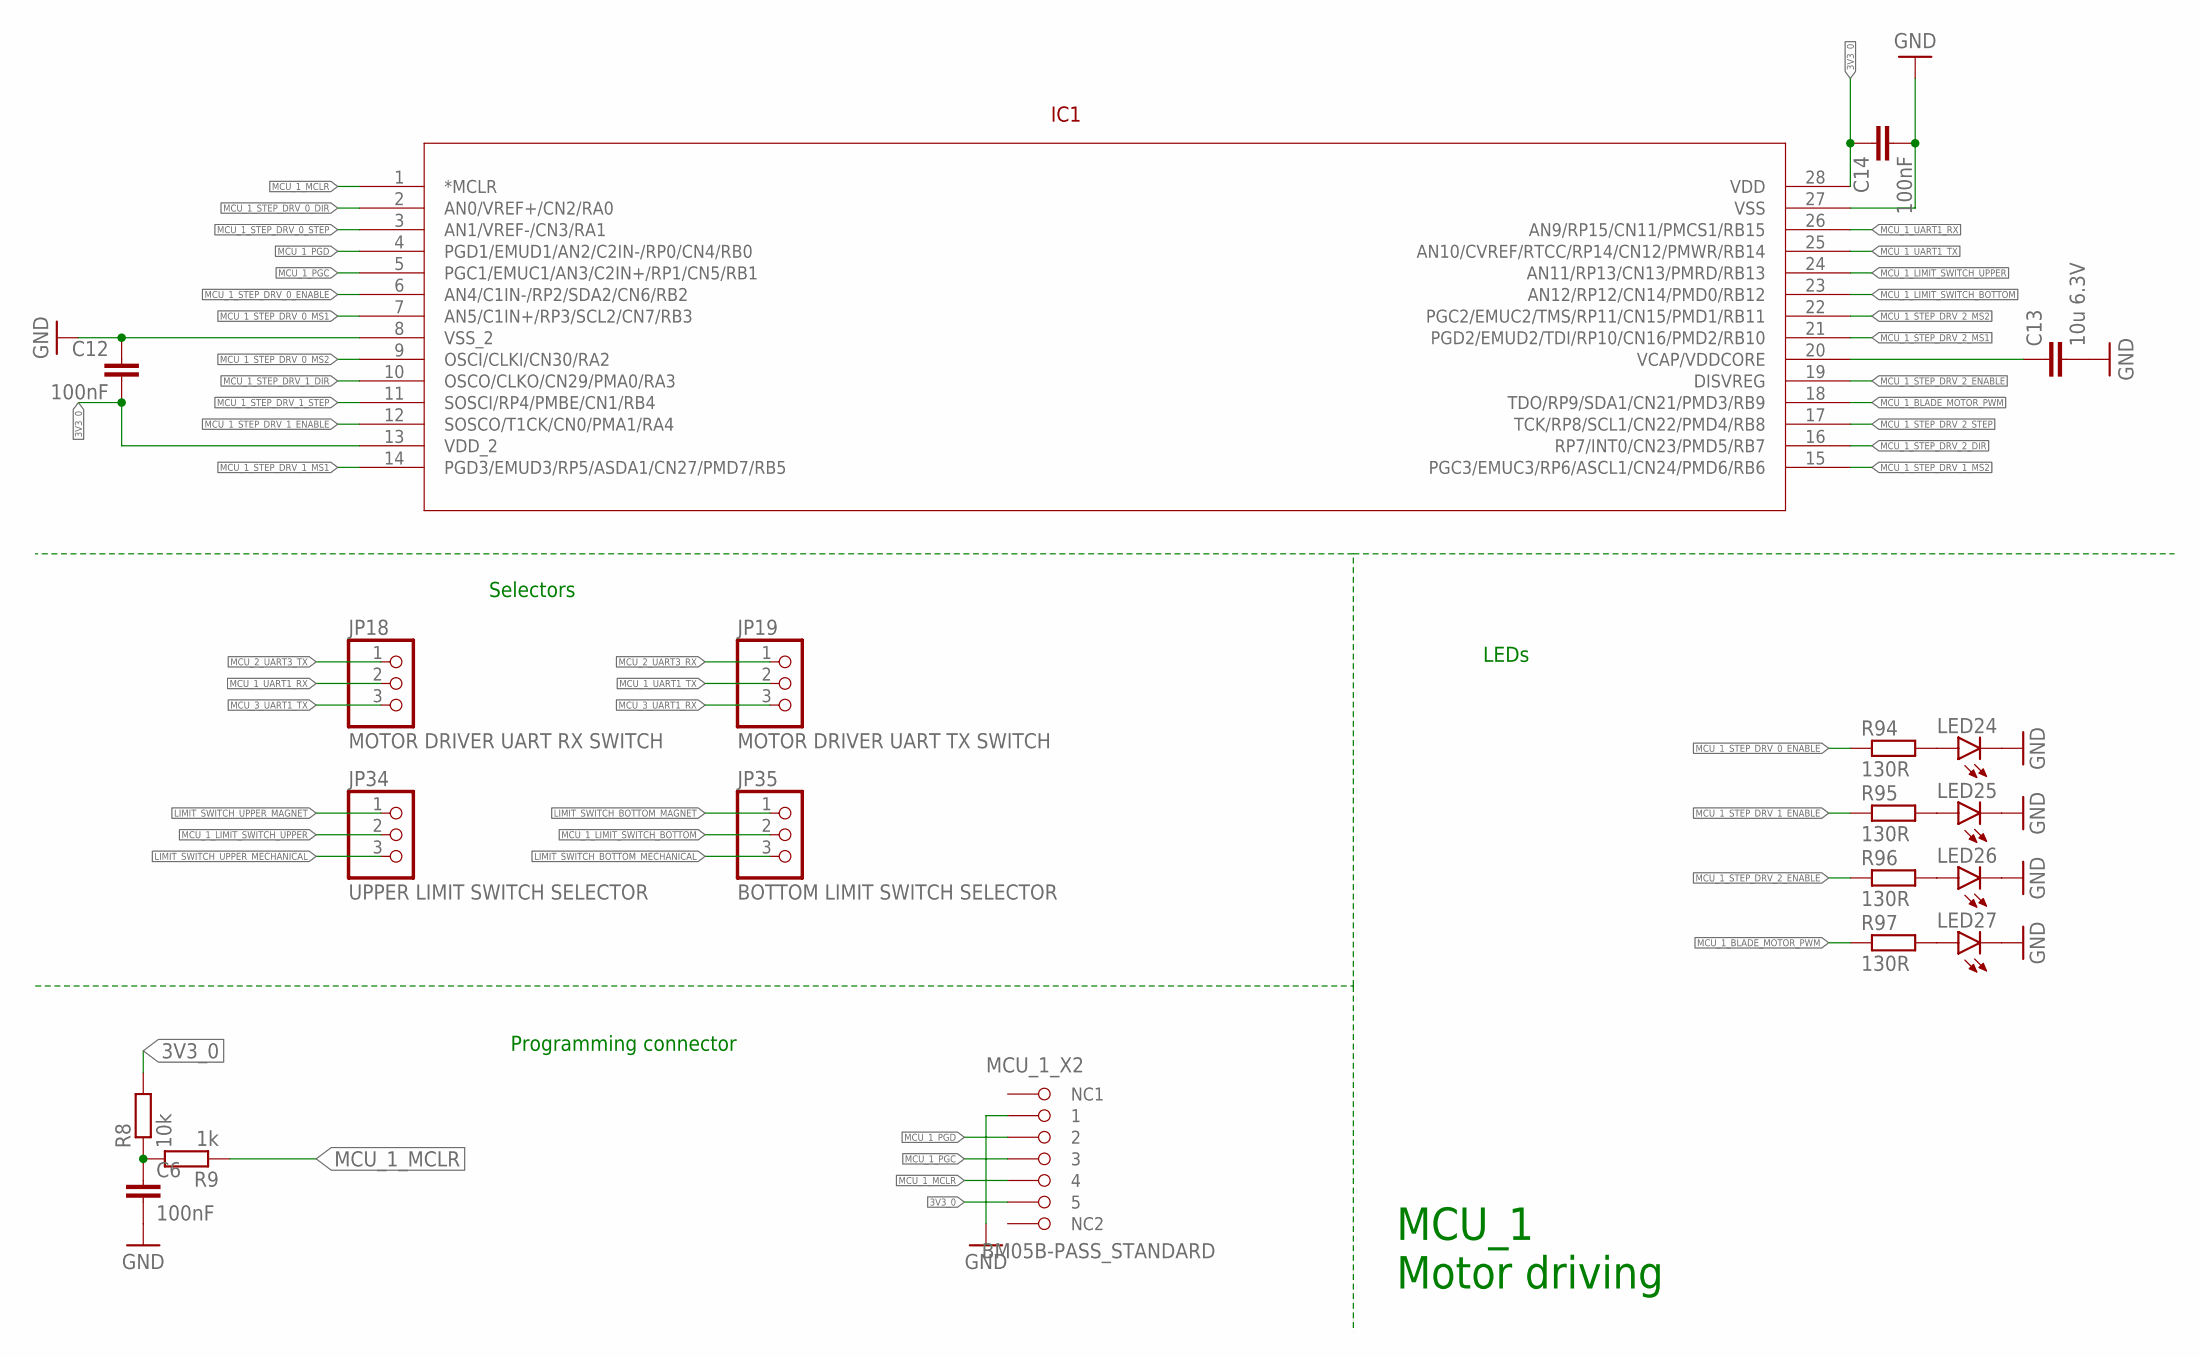
[picture p32: schematic RastoMower.sch, sheet 3, MCU_1 PIC32MM Motor Driving]

Parts:
C6, C12, C14: 100nF; C0603
C13: 10u 6.3V; C1206
IC1: PIC24FJ32GA002-X; SPDIP28_300MC
JP18: MOTOR DRIVER UART RX SWITCH; 1X03
JP19: MOTOR DRIVER UART TX SWITCH; 1X03
JP34: UPPER LIMIT SWITCH SELECTOR; 1X03
JP35: BOTTOM LIMIT SWITCH SELECTOR; 1X03
LED24, LED25, LED26, LED27: LEDSML0805; SML0805
MCU_1_X2: BM05B-PASS_STANDARD; BM05B-PASS
R8: 10k; R0805
R9: 1k; R0805
R94, R95, R96, R97: 130R; R0603

Connections:
3V3_0: C12.2, C14.1, IC1.13 (VDD_2), IC1.28 (VDD), MCU_1_X2.P$5 (5), R8.2; also elsewhere on the board
GND: C6.2, C12.1, C13.2, C14.2, IC1.8 (VSS_2), IC1.27 (VSS), LED24.C, LED25.C, LED26.C, LED27.C; also elsewhere on the board
LIMIT_SWITCH_BOTTOM_MAGNET: JP35.1; also elsewhere on the board
LIMIT_SWITCH_BOTTOM_MECHANICAL: JP35.3; also elsewhere on the board
LIMIT_SWITCH_UPPER_MAGNET: JP34.1; also elsewhere on the board
LIMIT_SWITCH_UPPER_MECHANICAL: JP34.3; also elsewhere on the board
MCU_1_BLADE_MOTOR_PWM: IC1.18 (TDO/RP9/SDA1/CN21/PMD3/RB9), R97.1; also elsewhere on the board
MCU_1_LIMIT_SWITCH_BOTTOM: IC1.23 (AN12/RP12/CN14/PMD0/RB12), JP35.2
MCU_1_LIMIT_SWITCH_UPPER: IC1.24 (AN11/RP13/CN13/PMRD/RB13), JP34.2
MCU_1_MCLR: IC1.1 (*MCLR), MCU_1_X2.P$4 (4), R9.1
MCU_1_PGC: IC1.5 (PGC1/EMUC1/AN3/C2IN+/RP1/CN5/RB1), MCU_1_X2.P$3 (3)
MCU_1_PGD: IC1.4 (PGD1/EMUD1/AN2/C2IN-/RP0/CN4/RB0), MCU_1_X2.P$2 (2)
MCU_1_STEP_DRV_0_DIR: IC1.2 (AN0/VREF+/CN2/RA0); also elsewhere on the board
MCU_1_STEP_DRV_0_ENABLE: IC1.6 (AN4/C1IN-/RP2/SDA2/CN6/RB2), R94.1; also elsewhere on the board
MCU_1_STEP_DRV_0_MS1: IC1.7 (AN5/C1IN+/RP3/SCL2/CN7/RB3); also elsewhere on the board
MCU_1_STEP_DRV_0_MS2: IC1.9 (OSCI/CLKI/CN30/RA2); also elsewhere on the board
MCU_1_STEP_DRV_0_STEP: IC1.3 (AN1/VREF-/CN3/RA1); also elsewhere on the board
MCU_1_STEP_DRV_1_DIR: IC1.10 (OSCO/CLKO/CN29/PMA0/RA3); also elsewhere on the board
MCU_1_STEP_DRV_1_ENABLE: IC1.12 (SOSCO/T1CK/CN0/PMA1/RA4), R95.1; also elsewhere on the board
MCU_1_STEP_DRV_1_MS1: IC1.14 (PGD3/EMUD3/RP5/ASDA1/CN27/PMD7/RB5); also elsewhere on the board
MCU_1_STEP_DRV_1_MS2: IC1.15 (PGC3/EMUC3/RP6/ASCL1/CN24/PMD6/RB6); also elsewhere on the board
MCU_1_STEP_DRV_1_STEP: IC1.11 (SOSCI/RP4/PMBE/CN1/RB4); also elsewhere on the board
MCU_1_STEP_DRV_2_DIR: IC1.16 (RP7/INT0/CN23/PMD5/RB7); also elsewhere on the board
MCU_1_STEP_DRV_2_ENABLE: IC1.19 (DISVREG), R96.1; also elsewhere on the board
MCU_1_STEP_DRV_2_MS1: IC1.21 (PGD2/EMUD2/TDI/RP10/CN16/PMD2/RB10); also elsewhere on the board
MCU_1_STEP_DRV_2_MS2: IC1.22 (PGC2/EMUC2/TMS/RP11/CN15/PMD1/RB11); also elsewhere on the board
MCU_1_STEP_DRV_2_STEP: IC1.17 (TCK/RP8/SCL1/CN22/PMD4/RB8); also elsewhere on the board
MCU_1_UART1_RX: IC1.26 (AN9/RP15/CN11/PMCS1/RB15), JP18.2
MCU_1_UART1_TX: IC1.25 (AN10/CVREF/RTCC/RP14/CN12/PMWR/RB14), JP19.2
MCU_2_UART3_RX: JP19.1; also elsewhere on the board
MCU_2_UART3_TX: JP18.1; also elsewhere on the board
MCU_3_UART1_RX: JP19.3; also elsewhere on the board
MCU_3_UART1_TX: JP18.3; also elsewhere on the board
unnamed 128: MCU_1_X2.P$1 (1); also elsewhere on the board
unnamed: C6.1, R8.1, R9.2
unnamed: C13.1, IC1.20 (VCAP/VDDCORE)
unnamed: LED24.A, R94.2
unnamed: LED25.A, R95.2
unnamed: LED26.A, R96.2
unnamed: LED27.A, R97.2

Notes on the sheet:
MCU_1 Motor driving
LEDs
Programming connector
Selectors

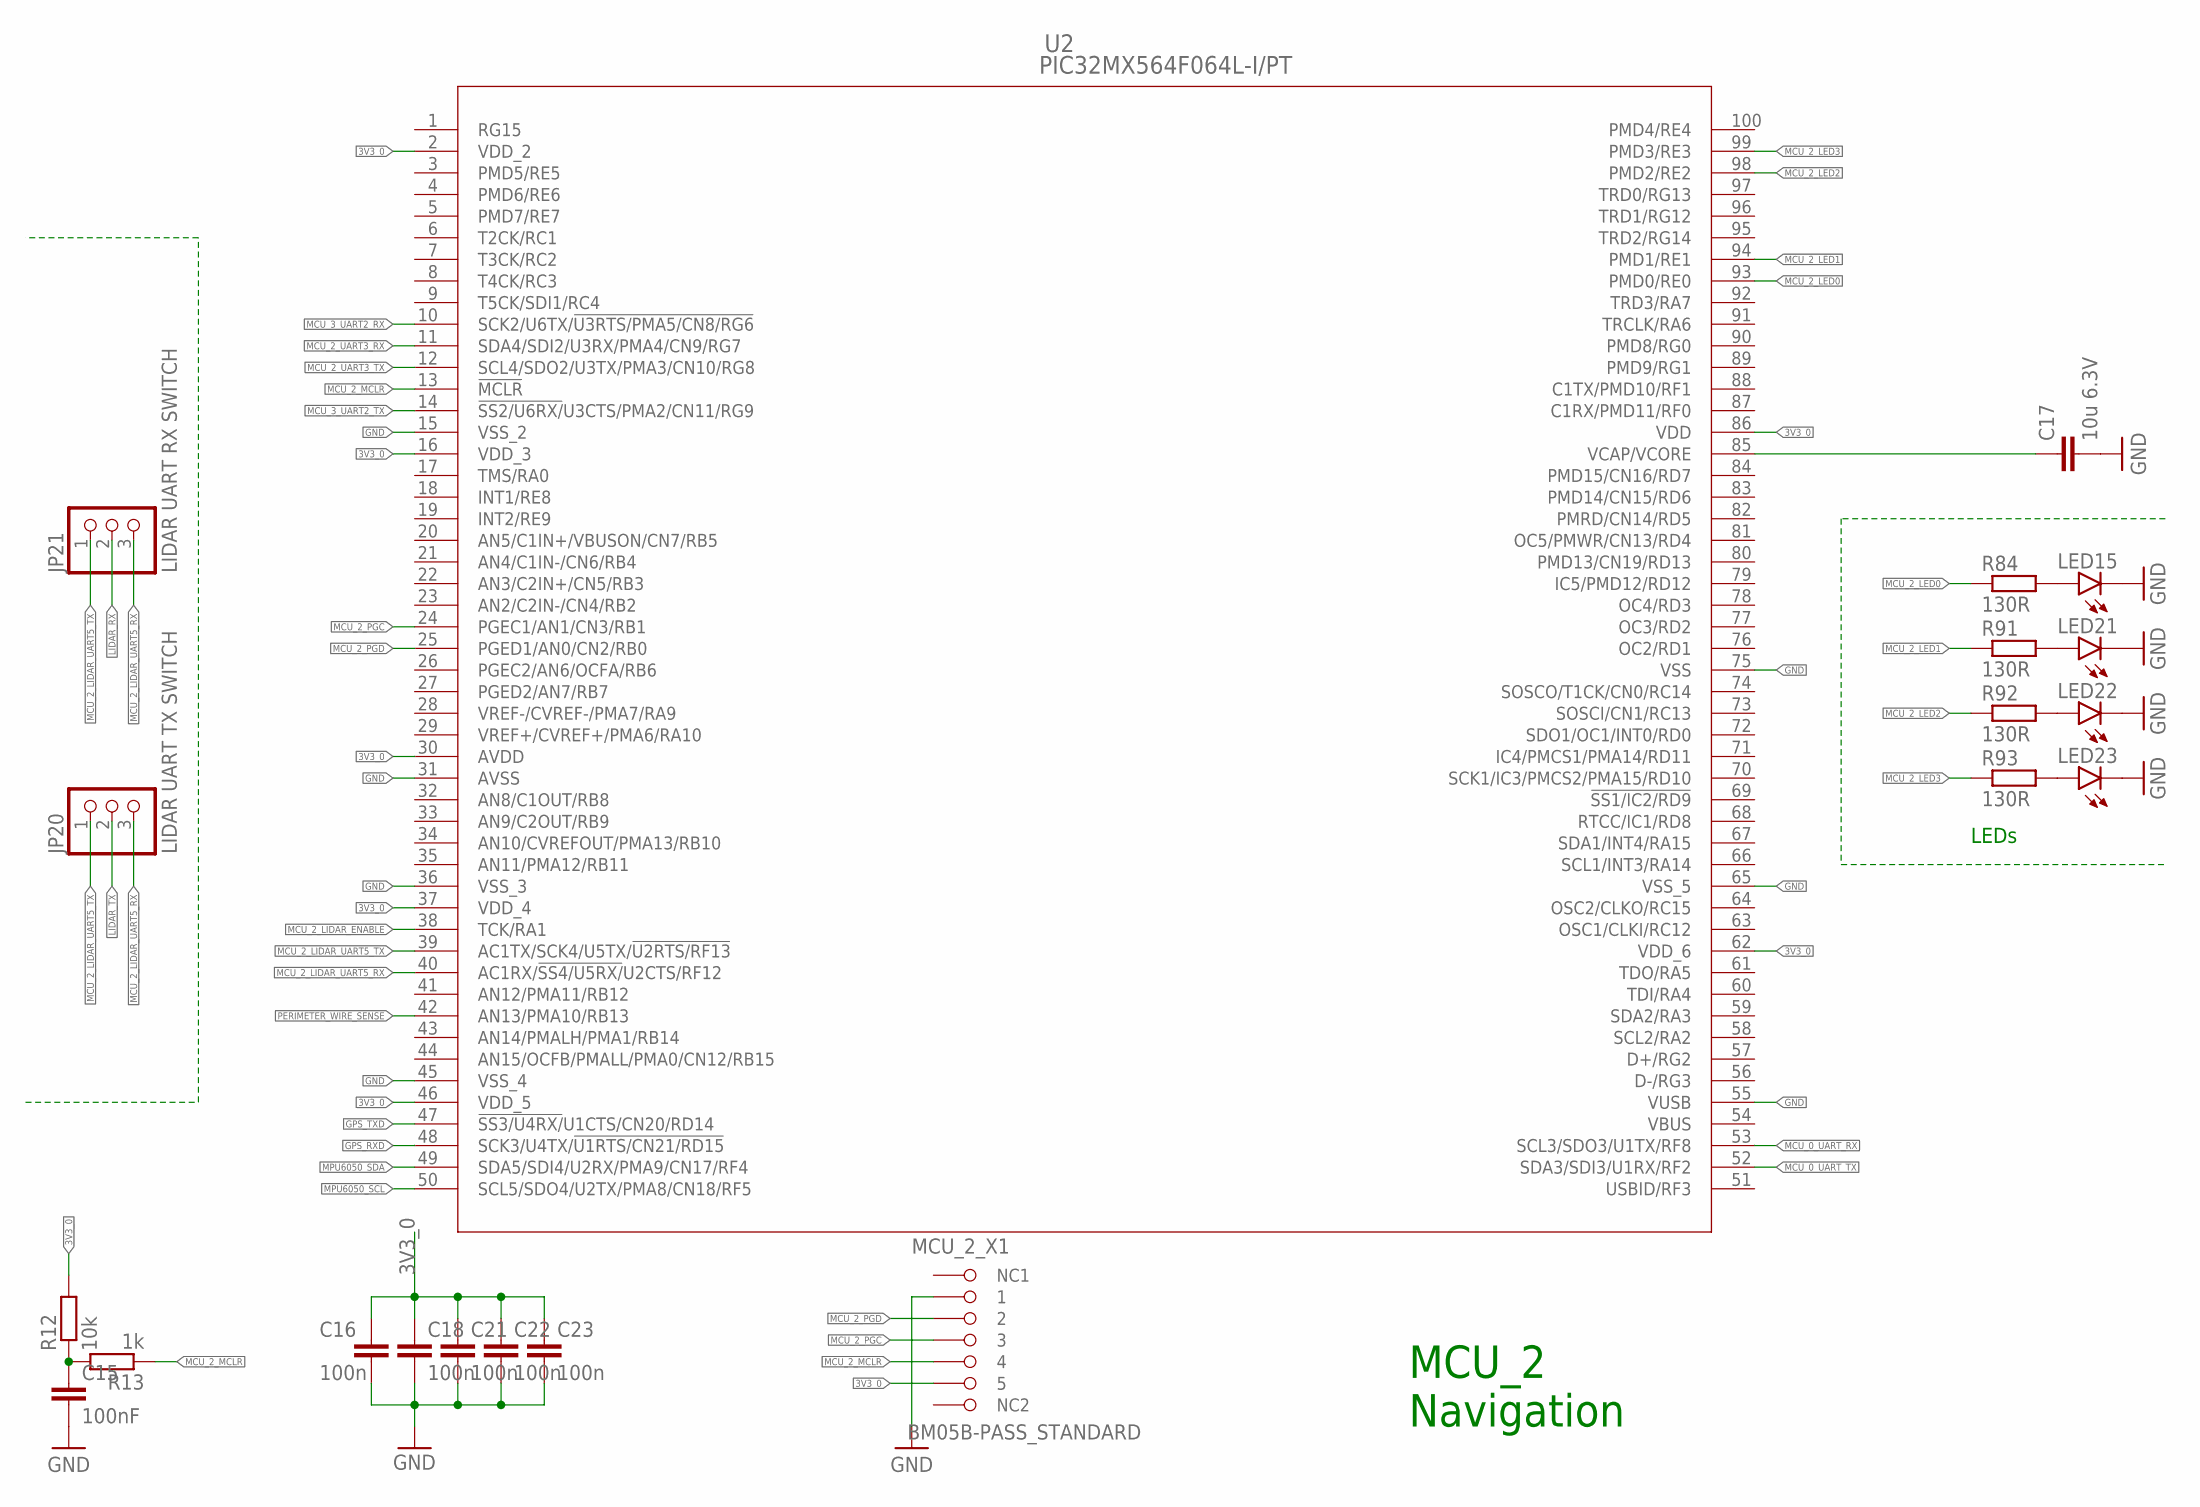
[picture p33: schematic RastoMower.sch, sheet 4, MCU_2 PIC32MX Navigation]

Parts:
C15: 100nF; C0603
C16, C18, C21, C22, C23: 100n; C0603
C17: 10u 6.3V; C1206
JP20: LIDAR UART TX SWITCH; 1X03
JP21: LIDAR UART RX SWITCH; 1X03
LED15, LED21, LED22, LED23: LEDSML0805; SML0805
MCU_2_X1: BM05B-PASS_STANDARD; BM05B-PASS
R12: 10k; R0805
R13: 1k; R0805
R84, R91, R92, R93: 130R; R0603
U2: PIC32MX564F064L-I/PT; TQFP100_12X12MC_MCH

Connections:
3V3_0: C16.1, C18.1, C21.1, C22.1, C23.1, MCU_2_X1.P$5 (5), R12.2, U2.2 (VDD_2), U2.16 (VDD_3), U2.30 (AVDD), U2.37 (VDD_4), U2.46 (VDD_5), U2.62 (VDD_6), U2.86 (VDD); also elsewhere on the board
GND: C15.2, C16.2, C17.2, C18.2, C21.2, C22.2, C23.2, LED15.C, LED21.C, LED22.C, LED23.C, U2.15 (VSS_2), U2.31 (AVSS), U2.36 (VSS_3), U2.45 (VSS_4), U2.55 (VUSB), U2.65 (VSS_5), U2.75 (VSS); also elsewhere on the board
GPS_RXD: U2.48 (SCK3/U4TX/!U1RTS/CN21/RD15); also elsewhere on the board
GPS_TXD: U2.47 (!SS3/U4RX/!U1CTS/CN20/RD14); also elsewhere on the board
LIDAR_RX: JP21.2; also elsewhere on the board
LIDAR_TX: JP20.2; also elsewhere on the board
MCU_0_UART_RX: U2.53 (SCL3/SDO3/U1TX/RF8); also elsewhere on the board
MCU_0_UART_TX: U2.52 (SDA3/SDI3/U1RX/RF2); also elsewhere on the board
MCU_2_LED0: R84.1, U2.93 (PMD0/RE0)
MCU_2_LED1: R91.1, U2.94 (PMD1/RE1)
MCU_2_LED2: R92.1, U2.98 (PMD2/RE2)
MCU_2_LED3: R93.1, U2.99 (PMD3/RE3)
MCU_2_LIDAR_ENABLE: U2.38 (TCK/RA1); also elsewhere on the board
MCU_2_LIDAR_UART5_RX: JP20.3, JP21.3, U2.40 (AC1RX/!SS4/U5RX/!U2CTS/RF12)
MCU_2_LIDAR_UART5_TX: JP20.1, JP21.1, U2.39 (AC1TX/SCK4/U5TX/!U2RTS/RF13)
MCU_2_MCLR: MCU_2_X1.P$4 (4), R13.1, U2.13 (!MCLR)
MCU_2_PGC: MCU_2_X1.P$3 (3), U2.24 (PGEC1/AN1/CN3/RB1)
MCU_2_PGD: MCU_2_X1.P$2 (2), U2.25 (PGED1/AN0/CN2/RB0)
MCU_2_UART3_RX: U2.11 (SDA4/SDI2/U3RX/PMA4/CN9/RG7); also elsewhere on the board
MCU_2_UART3_TX: U2.12 (SCL4/SDO2/U3TX/PMA3/CN10/RG8); also elsewhere on the board
MCU_3_UART2_RX: U2.10 (SCK2/U6TX/!U3RTS/PMA5/CN8/RG6); also elsewhere on the board
MCU_3_UART2_TX: U2.14 (!SS2/U6RX/!U3CTS/PMA2/CN11/RG9); also elsewhere on the board
MPU6050_SCL: U2.50 (SCL5/SDO4/U2TX/PMA8/CN18/RF5); also elsewhere on the board
MPU6050_SDA: U2.49 (SDA5/SDI4/U2RX/PMA9/CN17/RF4); also elsewhere on the board
unnamed 128: MCU_2_X1.P$1 (1); also elsewhere on the board
unnamed: C17.1, U2.85 (VCAP/VCORE)
unnamed: C15.1, R12.1, R13.2
unnamed: LED15.A, R84.2
unnamed: LED21.A, R91.2
unnamed: LED22.A, R92.2
unnamed: LED23.A, R93.2
PERIMETER_WIRE_SENSE: U2.42 (AN13/PMA10/RB13); also elsewhere on the board
VBUS: U2.54 (VBUS)

Notes on the sheet:
MCU_2 Navigation
LEDs
