roravec/RastoBot/PCB/2grounds_backup_220922/RastoMower.brd

## EAGLE design PCB/2grounds_backup_220922/RastoMower.brd (continued)

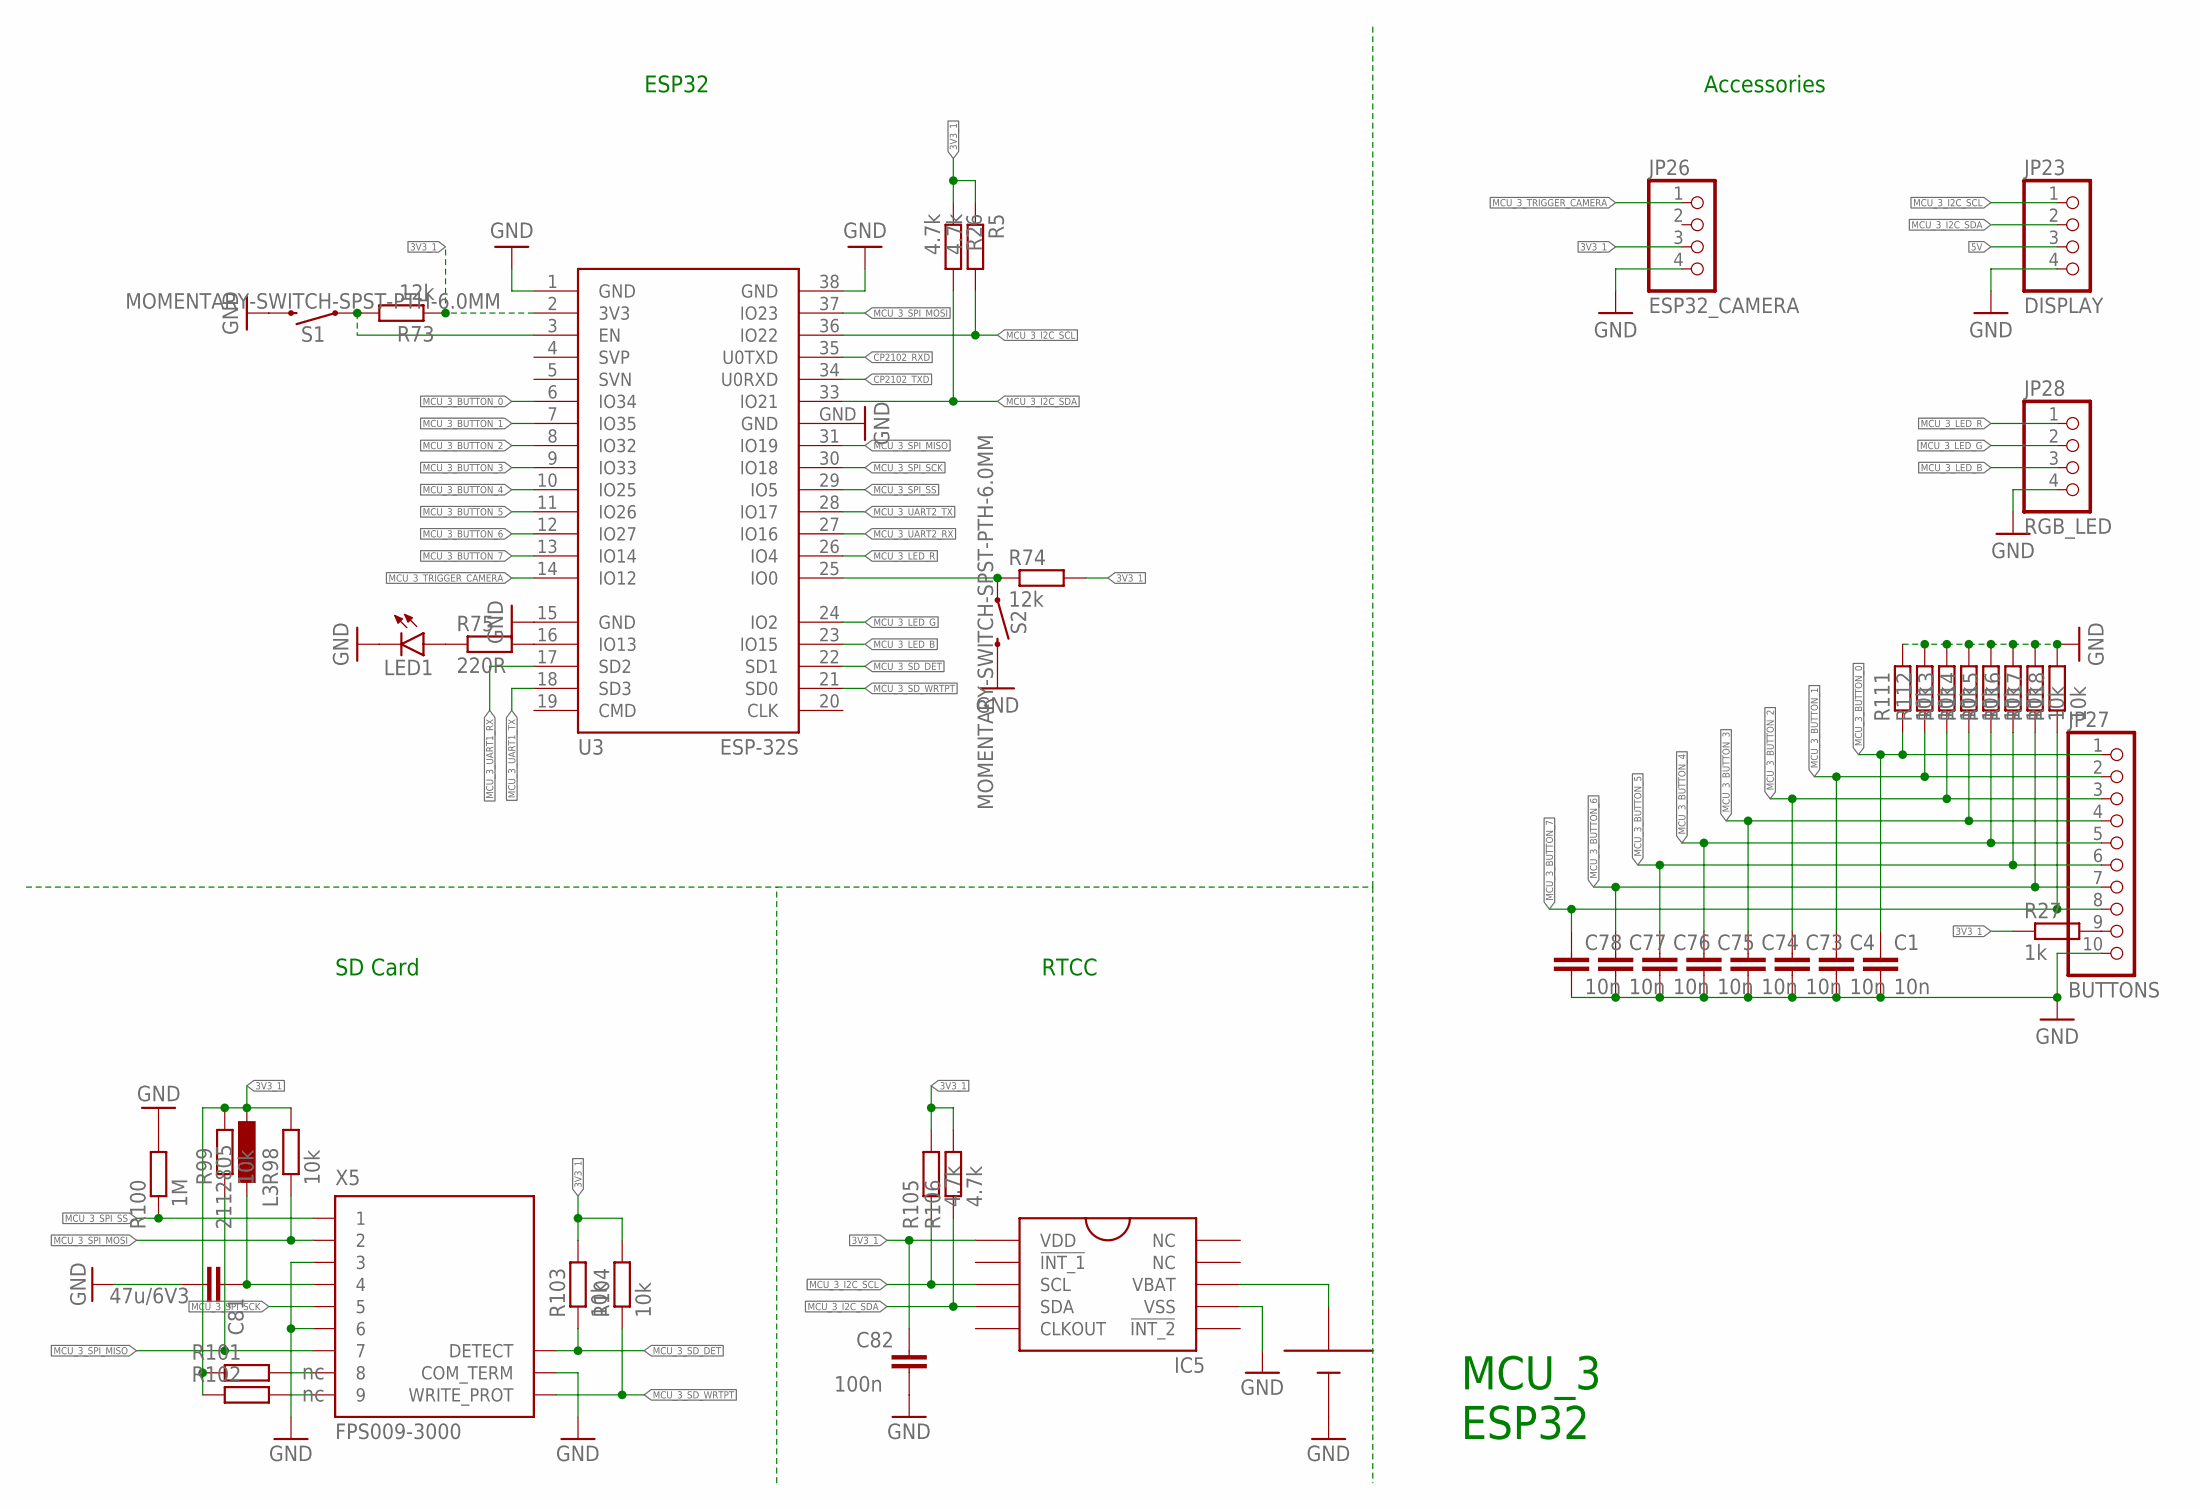
[picture p34: schematic RastoMower.sch, sheet 5, MCU_3 ESP32]

Parts:
BATT1: SMTU2032LF
C1, C4, C73, C74, C75, C76, C77, C78: 10n; C0603
C81: 47u/6V3; C1206
C82: 100n; C0603
IC5: AB-RTCMC-32.768KHZ-B5ZE-S3-T
JP23: DISPLAY; 1X04
JP26: ESP32_CAMERA; 1X04
JP27: BUTTONS; 1X10
JP28: RGB_LED; 1X04
L3: 2112805; L2825P
LED1: LEDSML0805; SML0805
R5, R26, R105, R106: 4.7k; R0603
R27: 1k; R0603
R73, R74: 12k; R0805
R75: 220R; R0805
R98, R99, R103, R104, R111, R112, R113, R114, R115, R116, R117, R118: 10k; R0603
R100: 1M; R0603
R101, R102: nc; R0603
S1, S2: MOMENTARY-SWITCH-SPST-PTH-6.0MM; TACTILE_SWITCH_PTH_6.0MM
U3: ESP-32S
X5: FPS009-3000

Connections:
3V3_1: C82.1, IC5.1 (VDD), JP26.3, L3.2, R5.1, R26.1, R27.1, R73.1, R74.2, R98.2, R99.2, R101.1, R102.1, R103.2, R104.2, R105.2, R106.2, U3.2 (3V3); also elsewhere on the board
5V: JP23.3; also elsewhere on the board
CP2102_RXD: U3.35 (U0TXD); also elsewhere on the board
CP2102_TXD: U3.34 (U0RXD); also elsewhere on the board
GND: BATT1.MINUS, C1.2, C4.2, C73.2, C74.2, C75.2, C76.2, C77.2, C78.2, C81.2, C82.2, IC5.7 (VSS), JP23.4, JP26.4, JP27.10, JP28.4, LED1.C, R100.2, R111.2, R112.2, R113.2, R114.2, R115.2, R116.2, R117.2, R118.2, S1.3 (2), S2.3 (2), U3.1 (GND), U3.15 (GND), U3.38 (GND), U3.GND, X5.3, X5.6, X5.COM_TERM; also elsewhere on the board
MCU_3_BUTTON_0: C1.1, JP27.1, R111.1, U3.6 (IO34)
MCU_3_BUTTON_1: C4.1, JP27.2, R112.1, U3.7 (IO35)
MCU_3_BUTTON_2: C73.1, JP27.3, R113.1, U3.8 (IO32)
MCU_3_BUTTON_3: C74.1, JP27.4, R114.1, U3.9 (IO33)
MCU_3_BUTTON_4: C75.1, JP27.5, R115.1, U3.10 (IO25)
MCU_3_BUTTON_5: C76.1, JP27.6, R116.1, U3.11 (IO26)
MCU_3_BUTTON_6: C77.1, JP27.7, R117.1, U3.12 (IO27)
MCU_3_BUTTON_7: C78.1, JP27.8, R118.1, U3.13 (IO14)
MCU_3_I2C_SCL: IC5.3 (SCL), JP23.1, R5.2, R105.1, U3.36 (IO22)
MCU_3_I2C_SDA: IC5.4 (SDA), JP23.2, R26.2, R106.1, U3.33 (IO21)
MCU_3_LED_B: JP28.3, U3.23 (IO15)
MCU_3_LED_G: JP28.2, U3.24 (IO2)
MCU_3_LED_R: JP28.1, U3.26 (IO4)
MCU_3_SD_DET: R103.1, U3.22 (SD1), X5.DETECT
MCU_3_SD_WRTPT: R104.1, U3.21 (SD0), X5.WRITE_PROT
MCU_3_SPI_MISO: R99.1, U3.31 (IO19), X5.7
MCU_3_SPI_MOSI: R98.1, U3.37 (IO23), X5.2
MCU_3_SPI_SCK: U3.30 (IO18), X5.5
MCU_3_SPI_SS: R100.1, U3.29 (IO5), X5.1
MCU_3_TRIGGER_CAMERA: JP26.1, U3.14 (IO12)
MCU_3_UART1_RX: U3.17 (SD2); also elsewhere on the board
MCU_3_UART1_TX: U3.18 (SD3); also elsewhere on the board
MCU_3_UART2_RX: U3.27 (IO16); also elsewhere on the board
MCU_3_UART2_TX: U3.28 (IO17); also elsewhere on the board
unnamed: JP27.9, R27.2
unnamed: R74.1, S2.1, U3.25 (IO0)
unnamed: R73.2, S1.1, U3.3 (EN)
unnamed: R75.2, U3.16 (IO13)
unnamed: LED1.A, R75.1
unnamed: R102.2, X5.9
unnamed: R101.2, X5.8
unnamed: BATT1.PLUS, IC5.8 (VBAT)
unnamed: C81.1, L3.1, X5.4

Notes on the sheet:
SD Card
RTCC
Accessories
ESP32
MCU_3 ESP32

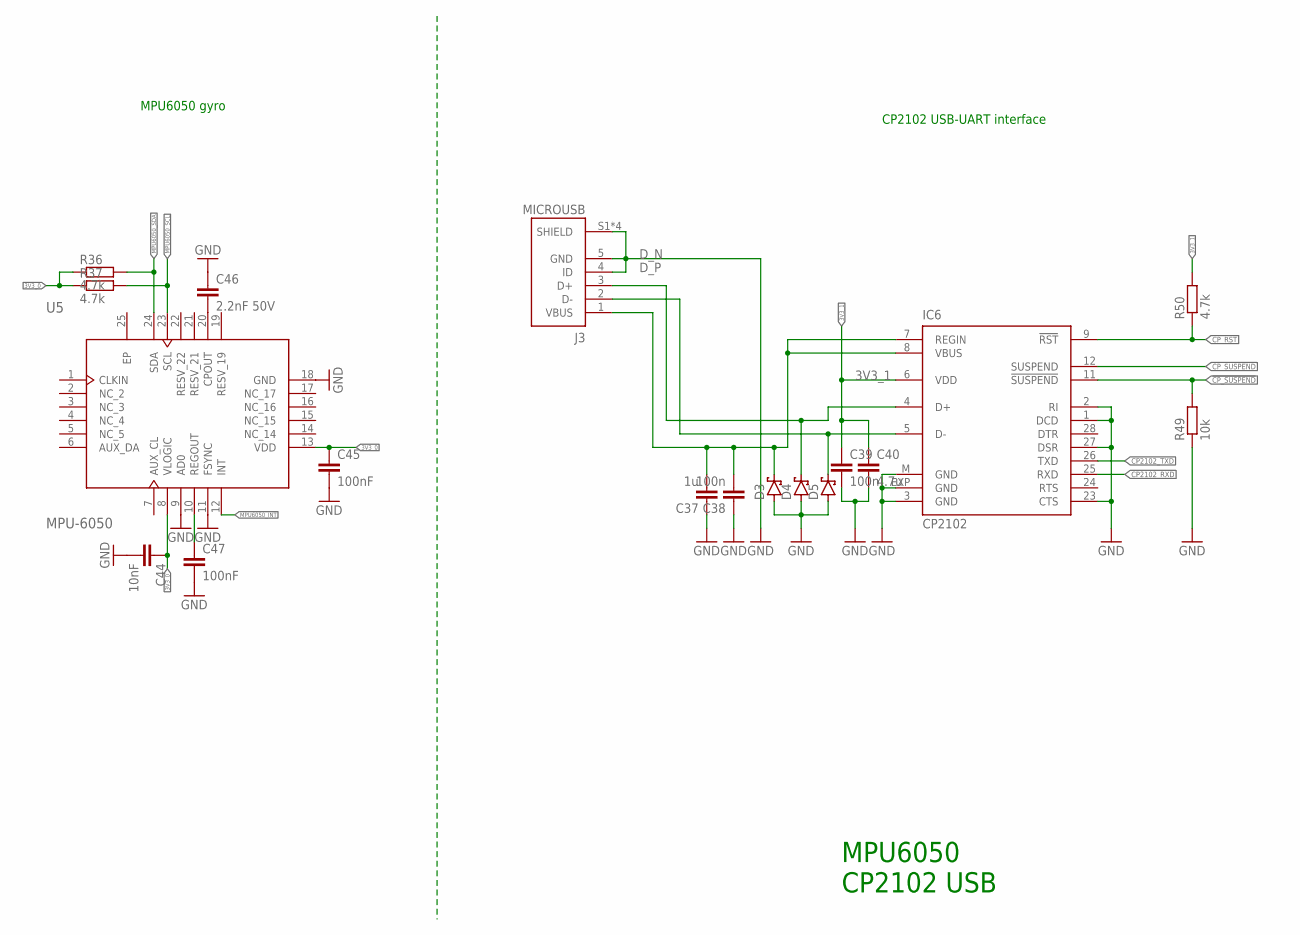
[picture p35: schematic RastoMower.sch, sheet 6, CP2102]

Parts:
C37: 1u; C0603
C38, C39: 100n; C0603
C40: 4.7u; C0603
C44: 10nF; C0603
C45, C47: 100nF; C0603
C46: 2.2nF 50V; C0603
D3, D4, D5: BAT60J; SOD323_ST
IC6: CP2102; MLP28
J3: MICROUSB; MOLEX_47642-0001
R36, R37, R50: 4.7k; R0603
R49: 10k; R0603
U5: MPU-6050; 24-VFQFN

Connections:
3V3_0: C44.1, C45.1, R36.1, R37.1, U5.8 (VLOGIC), U5.13 (VDD); also elsewhere on the board
3V3_1: C39.1, C40.1, IC6.6 (VDD), R50.2; also elsewhere on the board
!CP_SUSPEND: IC6.11 (!SUSPEND), R49.2
CP2102_RXD: IC6.25 (RXD); also elsewhere on the board
CP2102_TXD: IC6.26 (TXD); also elsewhere on the board
CP_RST: IC6.9 (!RST), R50.1
CP_SUSPEND: IC6.12 (SUSPEND)
D_N: D5.C, IC6.5 (D-), J3.2 (D-)
D_P: D4.C, IC6.4 (D+), J3.3 (D+)
EP: U5.25 (EP)
GND: C37.1, C38.1, C39.2, C40.2, C44.2, C45.2, C46.1, C47.2, D3.A, D4.A, D5.A, IC6.1 (DCD), IC6.2 (RI), IC6.3 (GND), IC6.23 (CTS), IC6.27 (DSR), IC6.EXP (GND), IC6.M (GND), J3.4 (ID), J3.5 (GND), J3.S1 (SHIELD), J3.S2 (SHIELD), J3.S3 (SHIELD), J3.S4 (SHIELD), R49.1, U5.9 (AD0), U5.11 (FSYNC), U5.18 (GND); also elsewhere on the board
MPU6050_INT: U5.12 (INT)
MPU6050_SCL: R37.2, U5.23 (SCL); also elsewhere on the board
MPU6050_SDA: R36.2, U5.24 (SDA); also elsewhere on the board
unnamed: C37.2, C38.2, D3.C, IC6.7 (REGIN), IC6.8 (VBUS), J3.1 (VBUS)
unnamed: C46.2, U5.20 (CPOUT)
unnamed: C47.1, U5.10 (REGOUT)

Notes on the sheet:
MPU6050 CP2102 USB
MPU6050 gyro
CP2102 USB-UART interface

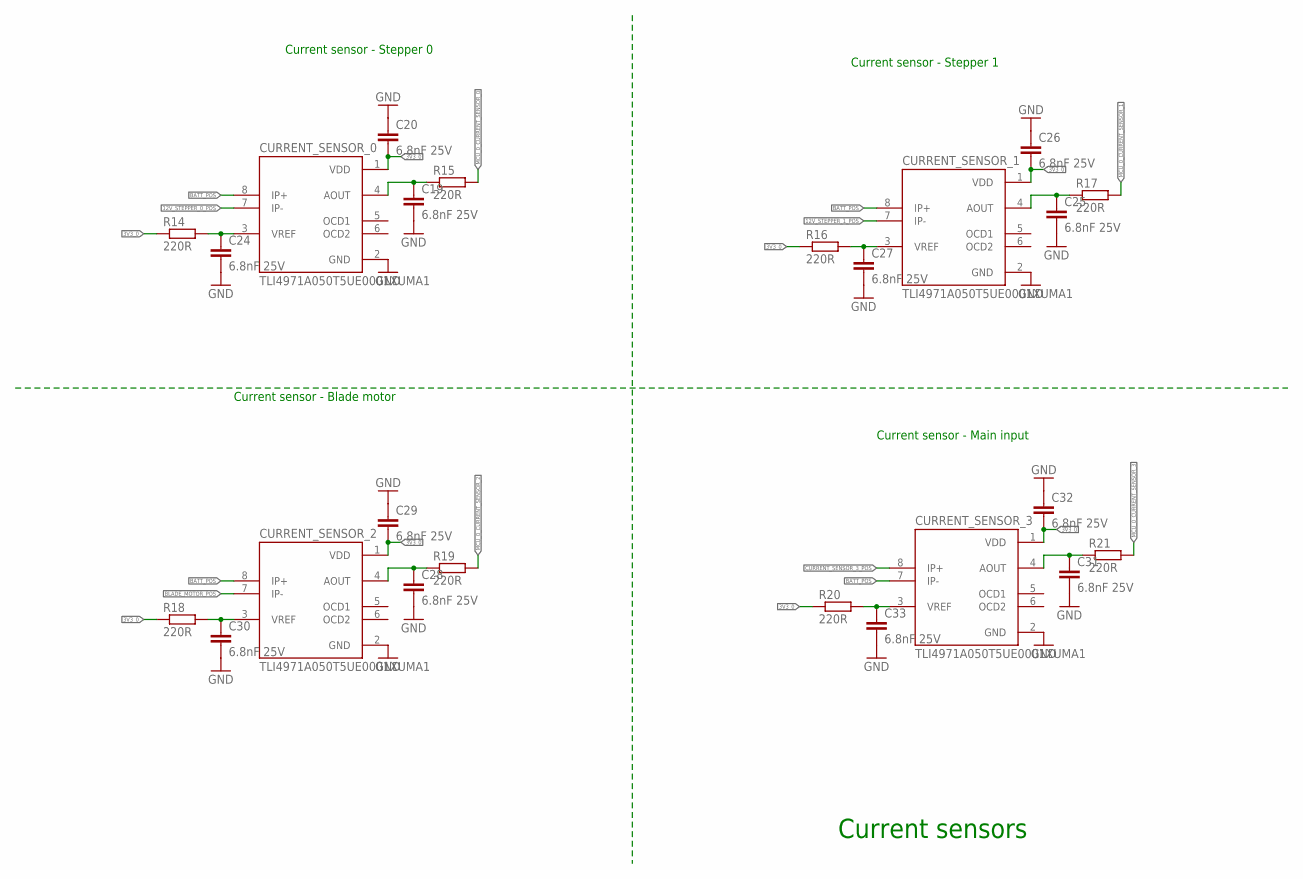
[picture p36: schematic RastoMower.sch, sheet 7, Current sensors]

Parts:
C19, C20, C24, C25, C26, C27, C28, C29, C30, C31, C32, C33: 6.8nF 25V; C0603
CURRENT_SENSOR_0, CURRENT_SENSOR_1, CURRENT_SENSOR_2, CURRENT_SENSOR_3: TLI4971A050T5UE0001XUMA1; IC_TLI4971A050T5UE0001XUMA1
R14, R15, R16, R17, R18, R19, R20, R21: 220R; R0805

Connections:
3V3_0: C20.2, C26.2, C29.2, C32.2, CURRENT_SENSOR_0.1 (VDD), CURRENT_SENSOR_1.1 (VDD), CURRENT_SENSOR_2.1 (VDD), CURRENT_SENSOR_3.1 (VDD), R14.1, R16.1, R18.1, R20.1; also elsewhere on the board
12V_STEPPER_0_POS: CURRENT_SENSOR_0.7 (IP-); also elsewhere on the board
12V_STEPPER_1_POS: CURRENT_SENSOR_1.7 (IP-); also elsewhere on the board
BATT_POS: CURRENT_SENSOR_0.8 (IP+), CURRENT_SENSOR_1.8 (IP+), CURRENT_SENSOR_2.8 (IP+), CURRENT_SENSOR_3.7 (IP-); also elsewhere on the board
BLADE_MOTOR_POS: CURRENT_SENSOR_2.7 (IP-); also elsewhere on the board
CURRENT_SENSOR_3_POS: CURRENT_SENSOR_3.8 (IP+); also elsewhere on the board
GND: C19.2, C20.1, C24.2, C25.2, C26.1, C27.2, C28.2, C29.1, C30.2, C31.2, C32.1, C33.2, CURRENT_SENSOR_0.2 (GND), CURRENT_SENSOR_1.2 (GND), CURRENT_SENSOR_2.2 (GND), CURRENT_SENSOR_3.2 (GND); also elsewhere on the board
MCU_0_CURRENT_SENSOR_0: R15.2; also elsewhere on the board
MCU_0_CURRENT_SENSOR_1: R17.2; also elsewhere on the board
MCU_0_CURRENT_SENSOR_2: R19.2; also elsewhere on the board
MCU_0_CURRENT_SENSOR_3: R21.2; also elsewhere on the board
unnamed: C19.1, CURRENT_SENSOR_0.4 (AOUT), R15.1
unnamed: C27.1, CURRENT_SENSOR_1.3 (VREF), R16.2
unnamed: C25.1, CURRENT_SENSOR_1.4 (AOUT), R17.1
unnamed: C24.1, CURRENT_SENSOR_0.3 (VREF), R14.2
unnamed: C30.1, CURRENT_SENSOR_2.3 (VREF), R18.2
unnamed: C28.1, CURRENT_SENSOR_2.4 (AOUT), R19.1
unnamed: C33.1, CURRENT_SENSOR_3.3 (VREF), R20.2
unnamed: C31.1, CURRENT_SENSOR_3.4 (AOUT), R21.1

Notes on the sheet:
Current sensors
Current sensor - Stepper 0
Current sensor - Stepper 1
Current sensor - Blade motor
Current sensor - Main input

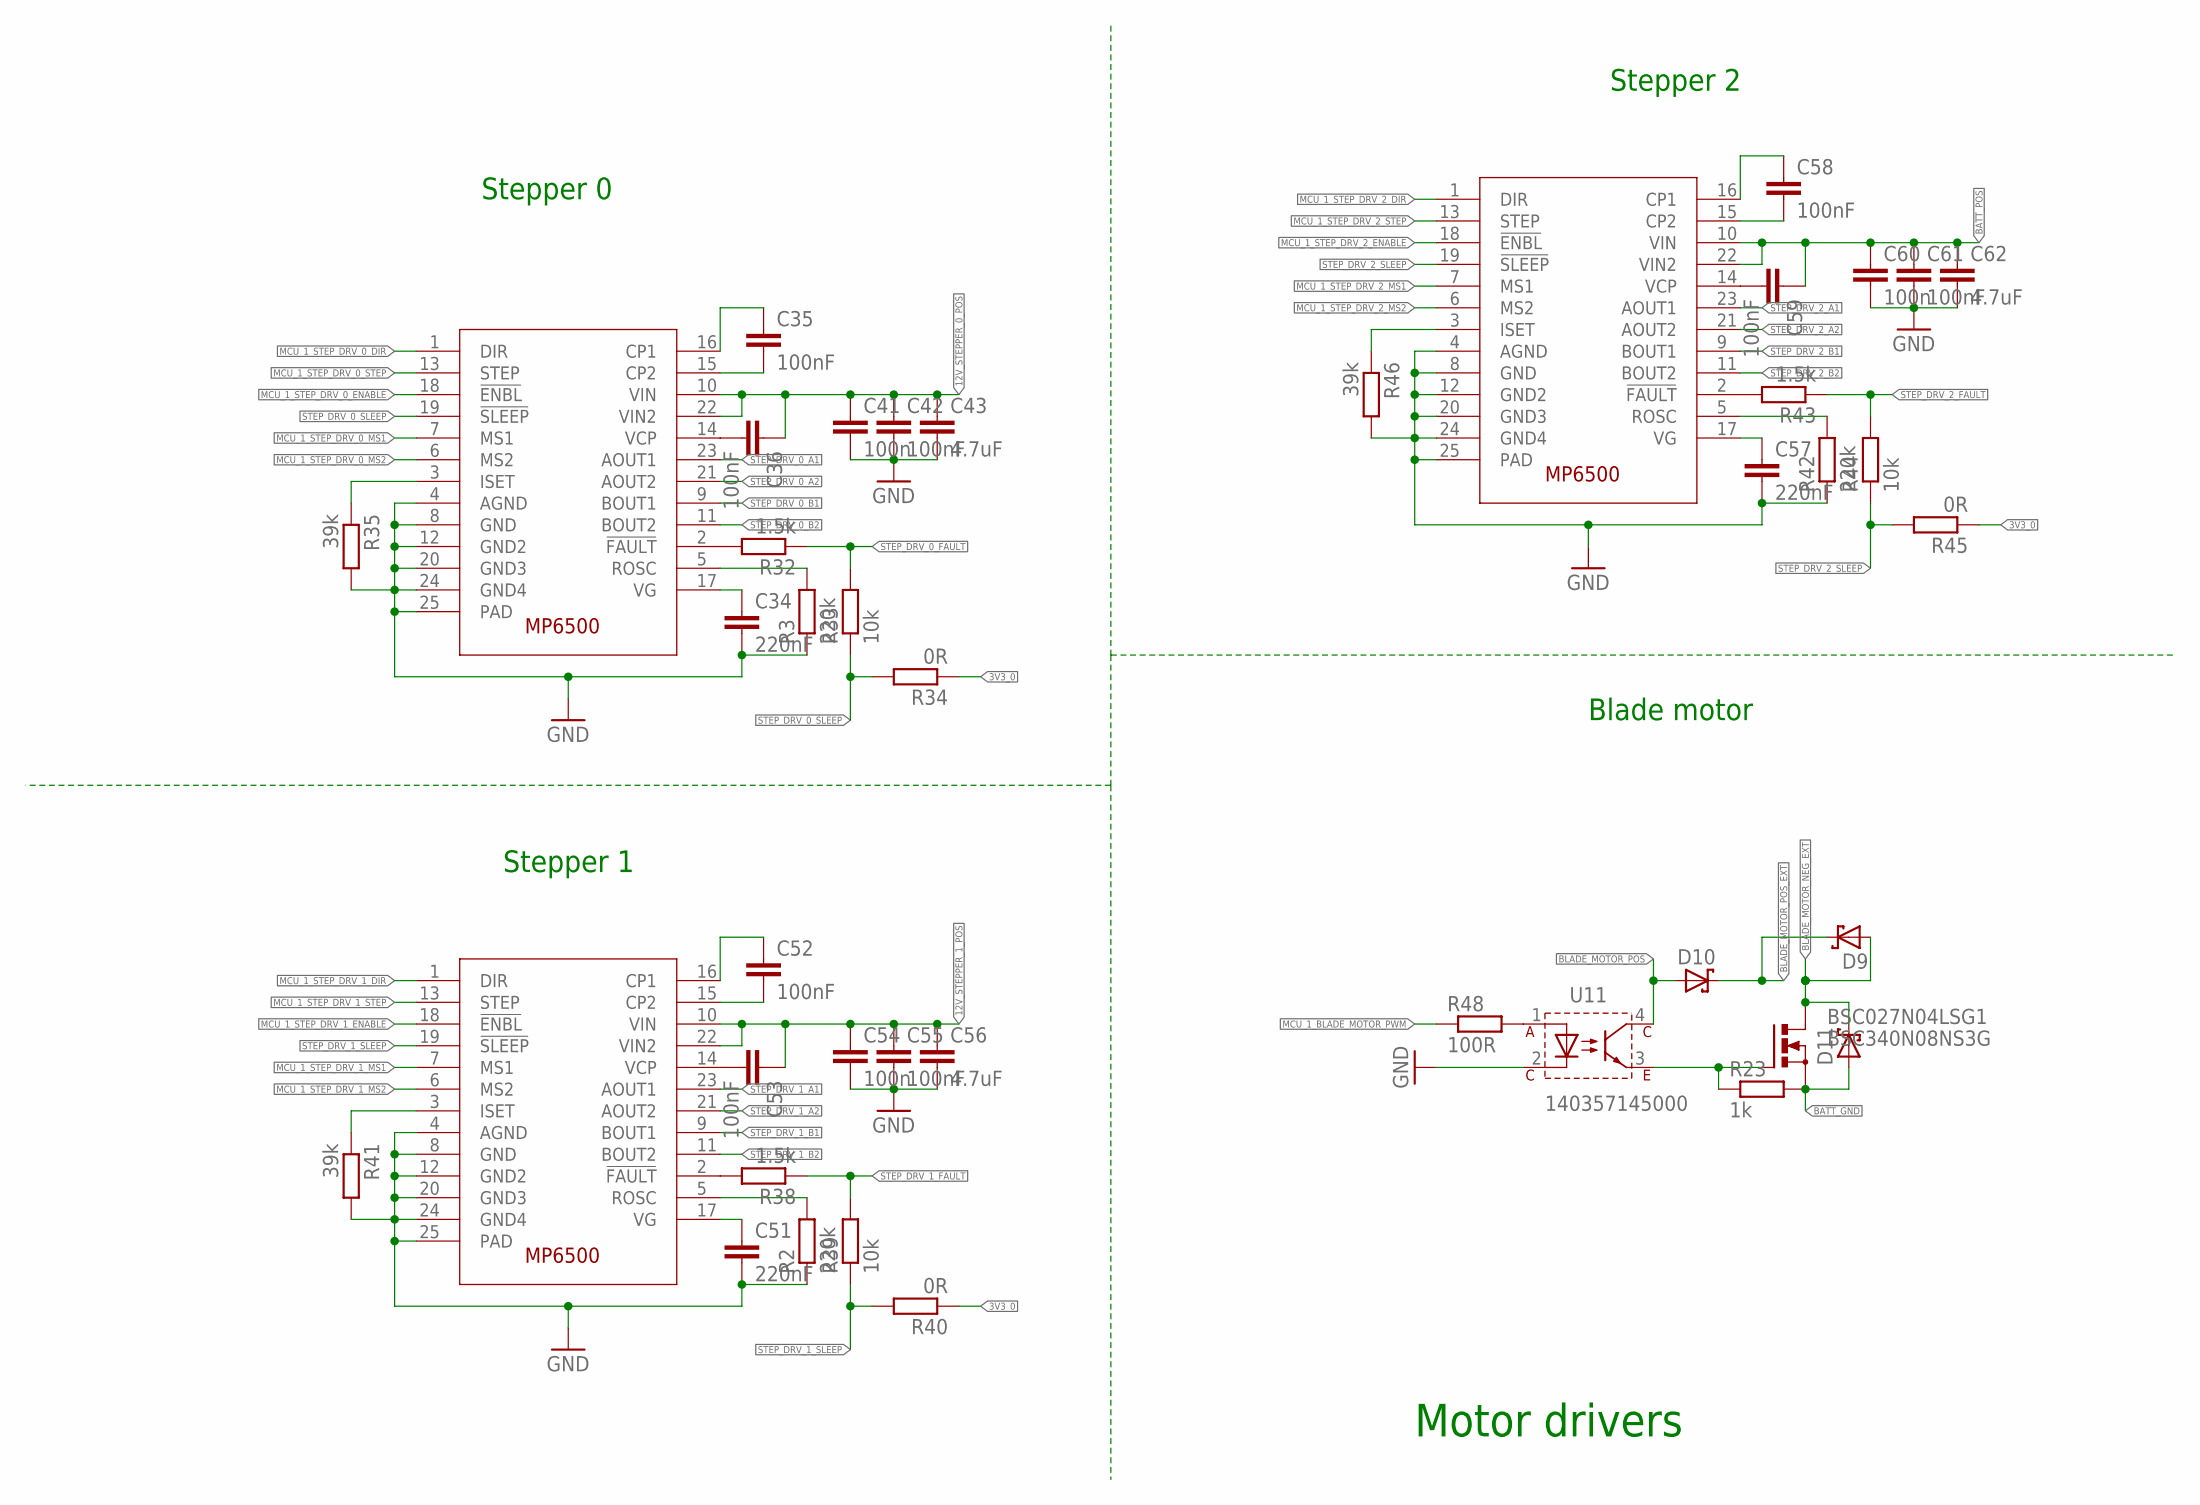
[picture p37: schematic RastoMower.sch, sheet 8, Motor drivers]

Parts:
BSC027N04LSG1: BSC340N08NS3G; PG-TDSON-8
C34, C51, C57: 220nF; C0603
C35, C36, C42, C52, C53, C55, C58, C59, C61: 100nF; C0603
C41, C54, C60: 100n; C0603
C43, C56, C62: 4.7uF; C0603
D9, D10, D11: SCHOTTKY-DIODEAG; AG
R2, R3, R42: 220k; R0603
R23: 1k; R0805
R32, R38, R43: 1.5k; R0603
R33, R39, R44: 10k; R0603
R34, R40, R45: 0R; R0603
R35, R41, R46: 39k; R0603
R48: 100R; R0805
U11: 140357145000; WL-OCPT_SOP4
U$1, U$2, U$3: MP6500; QFN65P500X500X100-25N

Connections:
3V3_0: R34.1, R40.1, R45.1; also elsewhere on the board
12V_STEPPER_0_POS: C36.1, C41.1, C42.1, C43.1, U$1.10 (VIN), U$1.22 (VIN2); also elsewhere on the board
12V_STEPPER_1_POS: C53.1, C54.1, C55.1, C56.1, U$2.10 (VIN), U$2.22 (VIN2); also elsewhere on the board
BATT_GND: BSC027N04LSG1.1 (S), BSC027N04LSG1.2 (S), BSC027N04LSG1.3 (S), D11.A, R23.2; also elsewhere on the board
BATT_POS: C59.1, C60.1, C61.1, C62.1, U$3.10 (VIN), U$3.22 (VIN2); also elsewhere on the board
BLADE_MOTOR_NEG_EXT: BSC027N04LSG1.5 (D), BSC027N04LSG1.6 (D), BSC027N04LSG1.7 (D), BSC027N04LSG1.8 (D), D9.A, D11.C; also elsewhere on the board
BLADE_MOTOR_POS: D10.A, U11.4; also elsewhere on the board
BLADE_MOTOR_POS_EXT: D9.C, D10.C; also elsewhere on the board
GND: C34.2, C41.2, C42.2, C43.2, C51.2, C54.2, C55.2, C56.2, C57.2, C60.2, C61.2, C62.2, R2.1, R3.1, R35.2, R41.2, R42.1, R46.2, U11.2, U$1.4 (AGND), U$1.8 (GND), U$1.12 (GND2), U$1.20 (GND3), U$1.24 (GND4), U$1.25 (PAD), U$2.4 (AGND), U$2.8 (GND), U$2.12 (GND2), U$2.20 (GND3), U$2.24 (GND4), U$2.25 (PAD), U$3.4 (AGND), U$3.8 (GND), U$3.12 (GND2), U$3.20 (GND3), U$3.24 (GND4), U$3.25 (PAD); also elsewhere on the board
MCU_1_BLADE_MOTOR_PWM: R48.1; also elsewhere on the board
MCU_1_STEP_DRV_0_DIR: U$1.1 (DIR); also elsewhere on the board
MCU_1_STEP_DRV_0_ENABLE: U$1.18 (!ENBL); also elsewhere on the board
MCU_1_STEP_DRV_0_MS1: U$1.7 (MS1); also elsewhere on the board
MCU_1_STEP_DRV_0_MS2: U$1.6 (MS2); also elsewhere on the board
MCU_1_STEP_DRV_0_STEP: U$1.13 (STEP); also elsewhere on the board
MCU_1_STEP_DRV_1_DIR: U$2.1 (DIR); also elsewhere on the board
MCU_1_STEP_DRV_1_ENABLE: U$2.18 (!ENBL); also elsewhere on the board
MCU_1_STEP_DRV_1_MS1: U$2.7 (MS1); also elsewhere on the board
MCU_1_STEP_DRV_1_MS2: U$2.6 (MS2); also elsewhere on the board
MCU_1_STEP_DRV_1_STEP: U$2.13 (STEP); also elsewhere on the board
MCU_1_STEP_DRV_2_DIR: U$3.1 (DIR); also elsewhere on the board
MCU_1_STEP_DRV_2_ENABLE: U$3.18 (!ENBL); also elsewhere on the board
MCU_1_STEP_DRV_2_MS1: U$3.7 (MS1); also elsewhere on the board
MCU_1_STEP_DRV_2_MS2: U$3.6 (MS2); also elsewhere on the board
MCU_1_STEP_DRV_2_STEP: U$3.13 (STEP); also elsewhere on the board
unnamed: C34.1, U$1.17 (VG)
unnamed: R3.2, U$1.5 (ROSC)
unnamed: R48.2, U11.1
unnamed: BSC027N04LSG1.4 (G), R23.1, U11.3
unnamed: C35.2, U$1.15 (CP2)
unnamed: C35.1, U$1.16 (CP1)
unnamed: R32.2, U$1.2 (!FAULT)
unnamed: C36.2, U$1.14 (VCP)
unnamed: C51.1, U$2.17 (VG)
unnamed: R35.1, U$1.3 (ISET)
unnamed: R2.2, U$2.5 (ROSC)
unnamed: C52.2, U$2.15 (CP2)
unnamed: C52.1, U$2.16 (CP1)
unnamed: C53.2, U$2.14 (VCP)
unnamed: R41.1, U$2.3 (ISET)
unnamed: R38.2, U$2.2 (!FAULT)
unnamed: C57.1, U$3.17 (VG)
unnamed: R42.2, U$3.5 (ROSC)
unnamed: C58.2, U$3.15 (CP2)
unnamed: C58.1, U$3.16 (CP1)
unnamed: C59.2, U$3.14 (VCP)
unnamed: R46.1, U$3.3 (ISET)
unnamed: R43.2, U$3.2 (!FAULT)
STEP_DRV_0_A1: U$1.23 (AOUT1); also elsewhere on the board
STEP_DRV_0_A2: U$1.21 (AOUT2); also elsewhere on the board
STEP_DRV_0_B1: U$1.9 (BOUT1); also elsewhere on the board
STEP_DRV_0_B2: U$1.11 (BOUT2); also elsewhere on the board
STEP_DRV_0_FAULT: R32.1, R33.2
STEP_DRV_0_SLEEP: R33.1, R34.2, U$1.19 (!SLEEP)
STEP_DRV_1_A1: U$2.23 (AOUT1); also elsewhere on the board
STEP_DRV_1_A2: U$2.21 (AOUT2); also elsewhere on the board
STEP_DRV_1_B1: U$2.9 (BOUT1); also elsewhere on the board
STEP_DRV_1_B2: U$2.11 (BOUT2); also elsewhere on the board
STEP_DRV_1_FAULT: R38.1, R39.2
STEP_DRV_1_SLEEP: R39.1, R40.2, U$2.19 (!SLEEP)
STEP_DRV_2_A1: U$3.23 (AOUT1); also elsewhere on the board
STEP_DRV_2_A2: U$3.21 (AOUT2); also elsewhere on the board
STEP_DRV_2_B1: U$3.9 (BOUT1); also elsewhere on the board
STEP_DRV_2_B2: U$3.11 (BOUT2); also elsewhere on the board
STEP_DRV_2_FAULT: R43.1, R44.2
STEP_DRV_2_SLEEP: R44.1, R45.2, U$3.19 (!SLEEP)

Notes on the sheet:
Stepper 0
Stepper 1
Stepper 2
Blade motor
Motor drivers

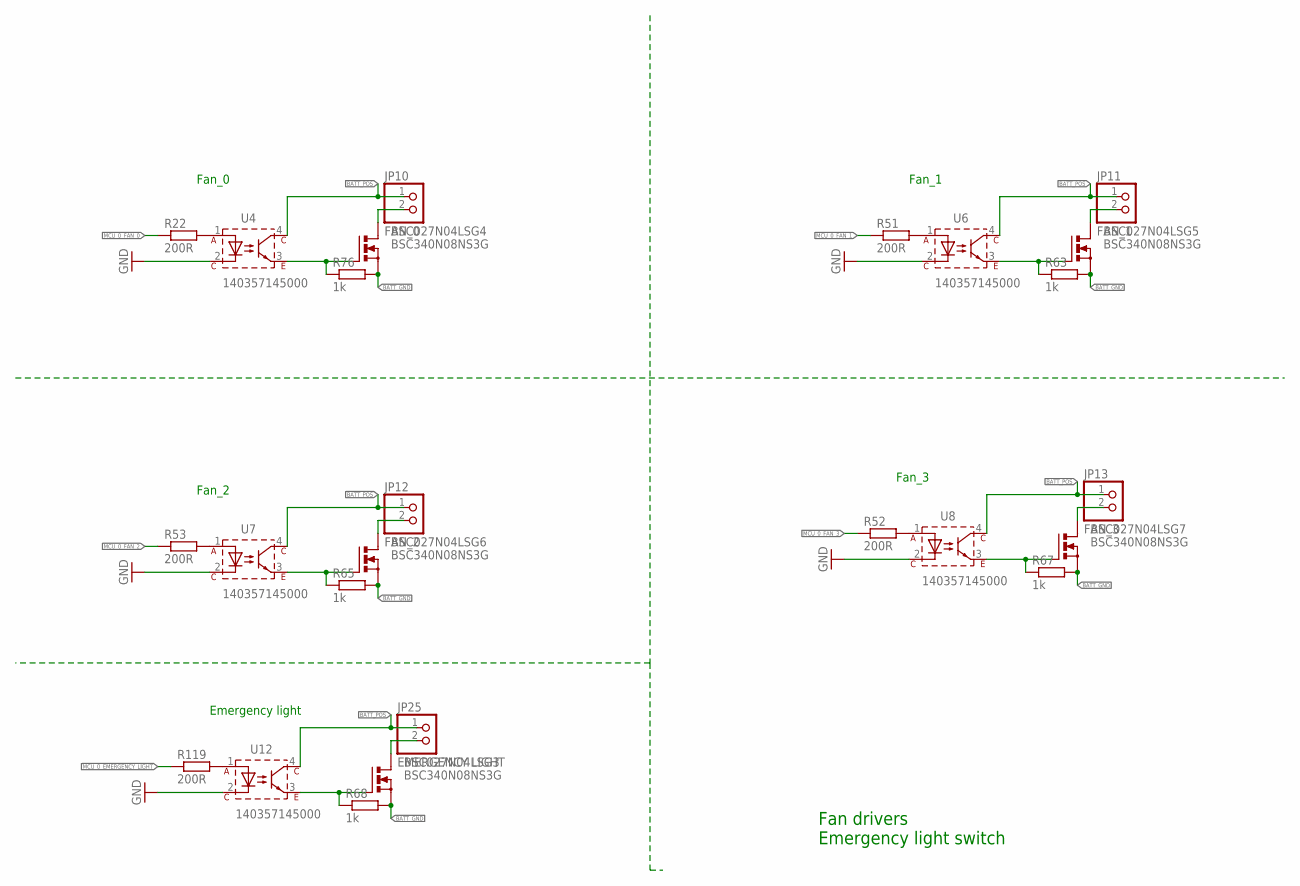
[picture p38: schematic RastoMower.sch, sheet 9, Fans]

Parts:
BSC027N04LSG3, BSC027N04LSG4, BSC027N04LSG5, BSC027N04LSG6, BSC027N04LSG7: BSC340N08NS3G; PG-TDSON-8
JP10: FAN_0; 1X02
JP11: FAN_1; 1X02
JP12: FAN_2; 1X02
JP13: FAN_3; 1X02
JP25: EMERGENCY LIGHT; 1X02
R22, R51, R52, R53, R119: 200R; R0805
R63, R65, R67, R68, R76: 1k; R0805
U4, U6, U7, U8, U12: 140357145000; WL-OCPT_SOP4

Connections:
BATT_GND: BSC027N04LSG3.1 (S), BSC027N04LSG3.2 (S), BSC027N04LSG3.3 (S), BSC027N04LSG4.1 (S), BSC027N04LSG4.2 (S), BSC027N04LSG4.3 (S), BSC027N04LSG5.1 (S), BSC027N04LSG5.2 (S), BSC027N04LSG5.3 (S), BSC027N04LSG6.1 (S), BSC027N04LSG6.2 (S), BSC027N04LSG6.3 (S), BSC027N04LSG7.1 (S), BSC027N04LSG7.2 (S), BSC027N04LSG7.3 (S), R63.2, R65.2, R67.2, R68.2, R76.2; also elsewhere on the board
BATT_POS: JP10.1, JP11.1, JP12.1, JP13.1, JP25.1, U4.4, U6.4, U7.4, U8.4, U12.4; also elsewhere on the board
GND: U4.2, U6.2, U7.2, U8.2, U12.2; also elsewhere on the board
MCU_0_EMERGENCY_LIGHT: R119.1; also elsewhere on the board
MCU_0_FAN_0: R22.1; also elsewhere on the board
MCU_0_FAN_1: R51.1; also elsewhere on the board
MCU_0_FAN_2: R53.1; also elsewhere on the board
MCU_0_FAN_3: R52.1; also elsewhere on the board
unnamed: BSC027N04LSG3.4 (G), R68.1, U12.3
unnamed: BSC027N04LSG3.5 (D), BSC027N04LSG3.6 (D), BSC027N04LSG3.7 (D), BSC027N04LSG3.8 (D), JP25.2
unnamed: R119.2, U12.1
unnamed: R22.2, U4.1
unnamed: BSC027N04LSG4.5 (D), BSC027N04LSG4.6 (D), BSC027N04LSG4.7 (D), BSC027N04LSG4.8 (D), JP10.2
unnamed: R51.2, U6.1
unnamed: R52.2, U8.1
unnamed: BSC027N04LSG4.4 (G), R76.1, U4.3
unnamed: BSC027N04LSG5.4 (G), R63.1, U6.3
unnamed: BSC027N04LSG5.5 (D), BSC027N04LSG5.6 (D), BSC027N04LSG5.7 (D), BSC027N04LSG5.8 (D), JP11.2
unnamed: R53.2, U7.1
unnamed: BSC027N04LSG6.4 (G), R65.1, U7.3
unnamed: BSC027N04LSG6.5 (D), BSC027N04LSG6.6 (D), BSC027N04LSG6.7 (D), BSC027N04LSG6.8 (D), JP12.2
unnamed: BSC027N04LSG7.4 (G), R67.1, U8.3
unnamed: BSC027N04LSG7.5 (D), BSC027N04LSG7.6 (D), BSC027N04LSG7.7 (D), BSC027N04LSG7.8 (D), JP13.2

Notes on the sheet:
Fan_0
Fan_1
Fan_2
Fan_3
Fan drivers Emergency light switch
Emergency light
