roravec/RastoBot/PCB/2grounds_backup_220922/RastoMower.brd

## EAGLE design PCB/2grounds_backup_220922/RastoMower.brd (continued)

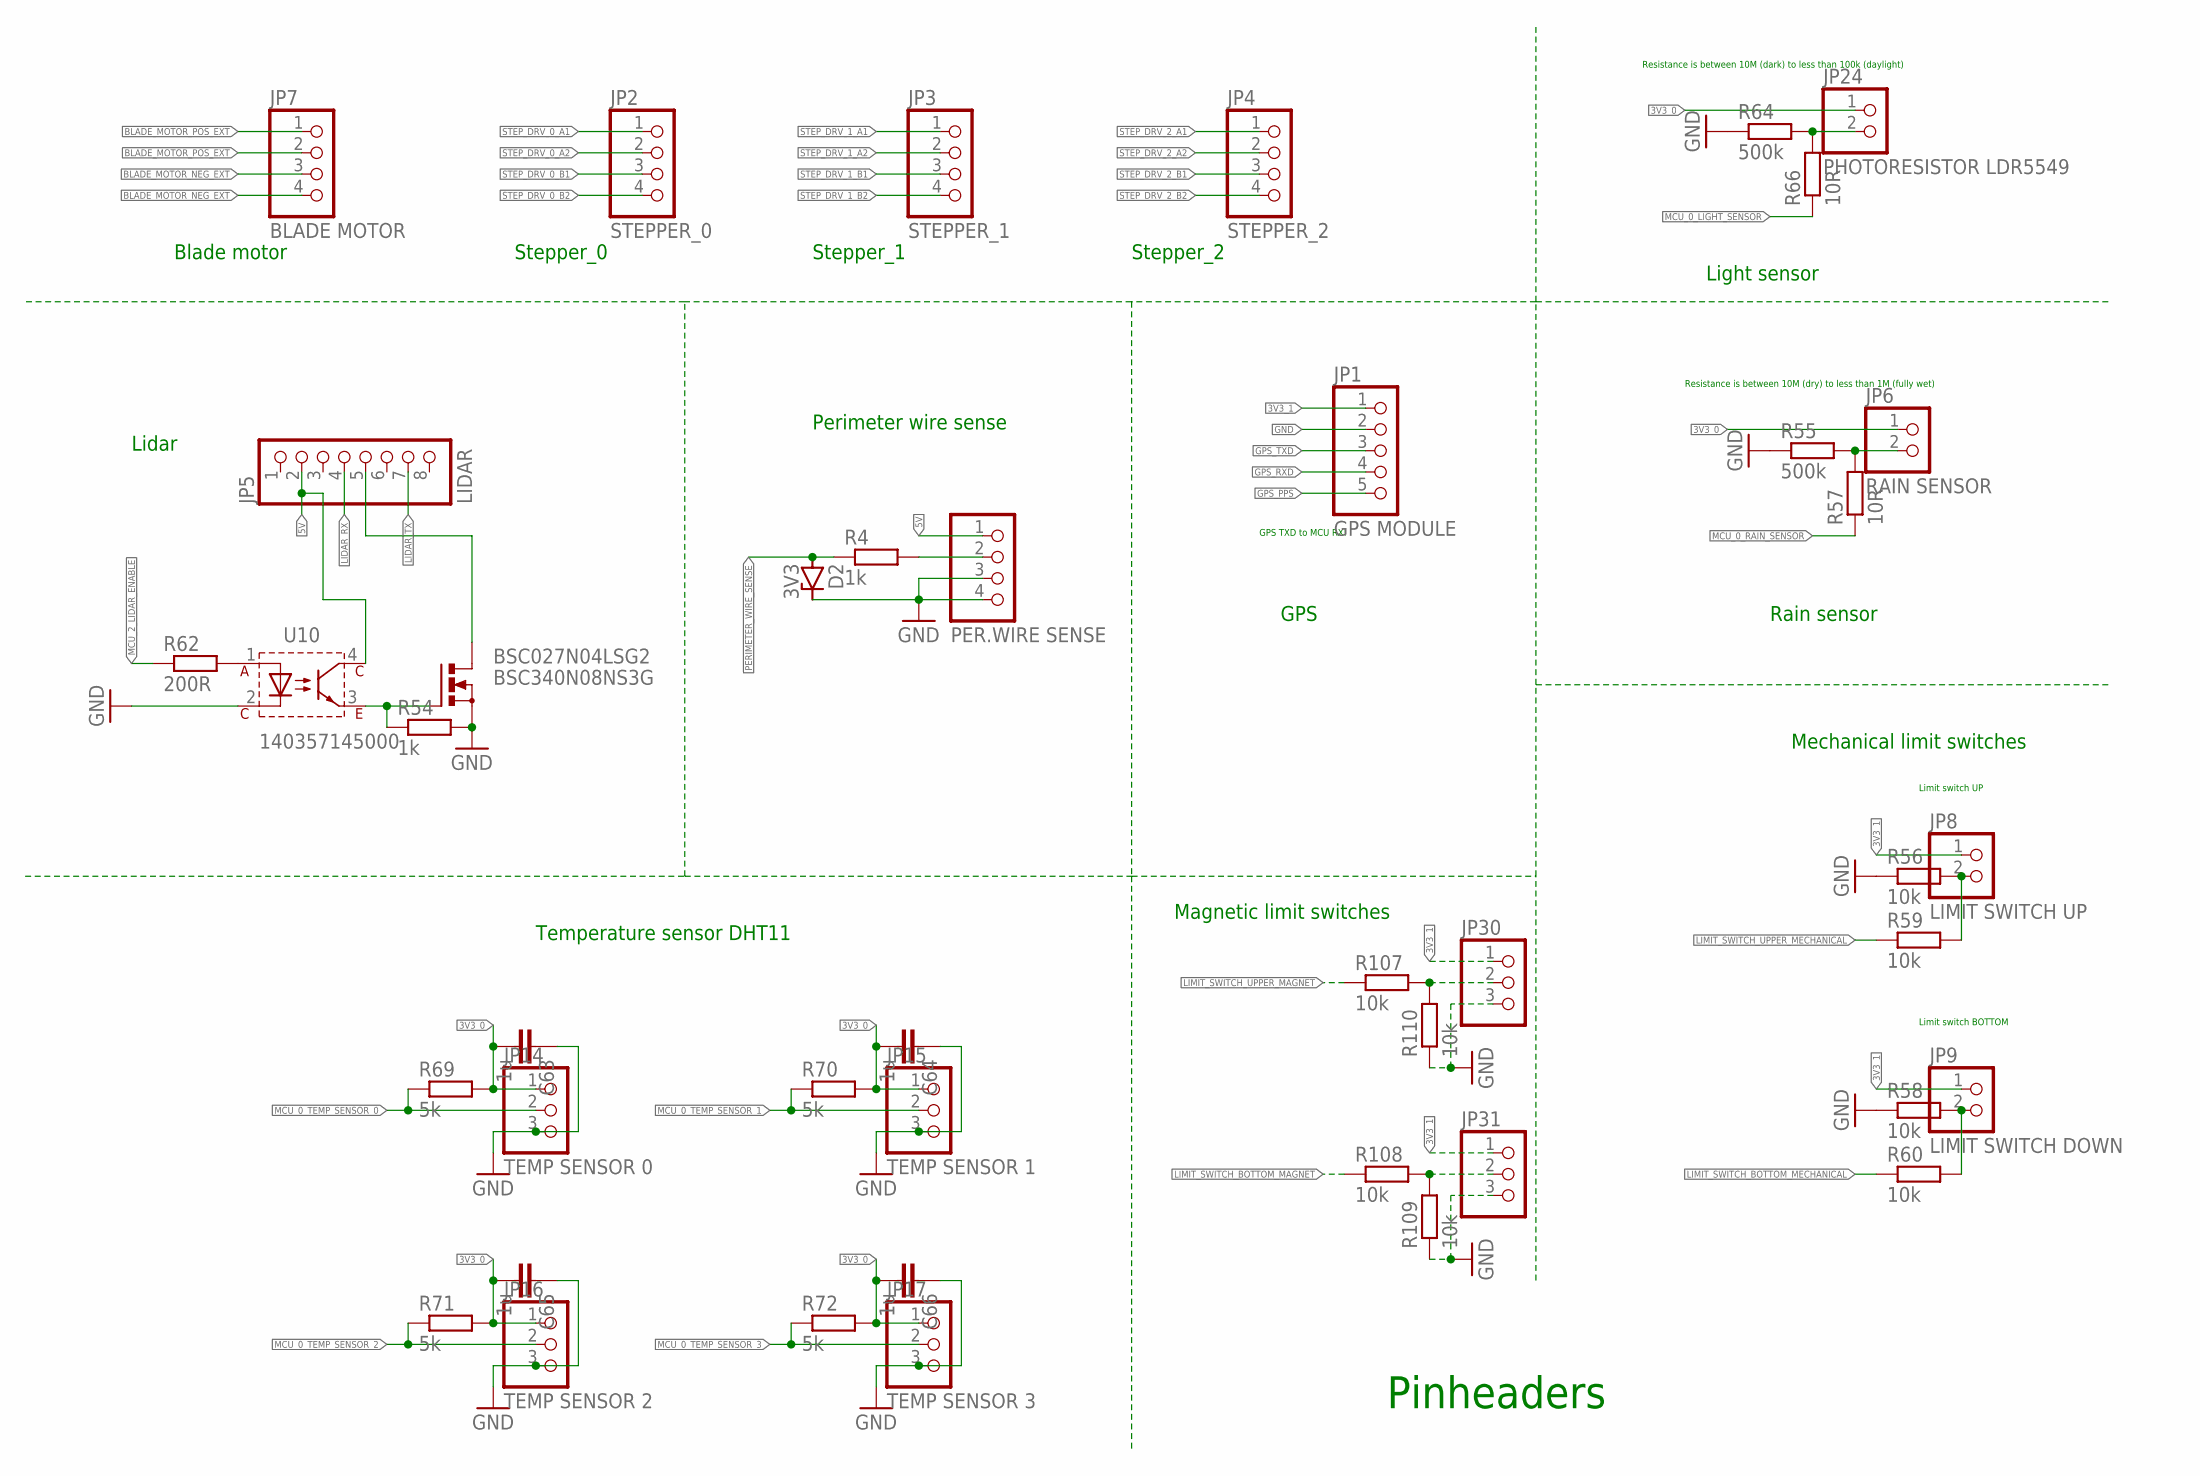
[picture p39: schematic RastoMower.sch, sheet 10, Pinheaders]

Parts:
BSC027N04LSG2: BSC340N08NS3G; PG-TDSON-8
C63, C64, C65, C66: 1u; C0603
D2: 3V3; SOD80C
JP1: GPS MODULE; 1X05
JP2: STEPPER_0; 1X04
JP3: STEPPER_1; 1X04
JP4: STEPPER_2; 1X04
JP5: LIDAR; 1X08
JP6: RAIN SENSOR; 1X02
JP7: BLADE MOTOR; 1X04
JP8: LIMIT SWITCH UP; 1X02
JP9: LIMIT SWITCH DOWN; 1X02
JP14: TEMP SENSOR 0; 1X03
JP15: TEMP SENSOR 1; 1X03
JP16: TEMP SENSOR 2; 1X03
JP17: TEMP SENSOR 3; 1X03
JP22: PER.WIRE SENSE; 1X04
JP24: PHOTORESISTOR LDR5549; 1X02
JP30, JP31: PINHD-1X3; 1X03
R4, R54: 1k; R0805
R55, R64: 500k; R0805
R56, R58, R59, R60, R107, R108, R109, R110: 10k; R0805
R57, R66: 10R; R0805
R62: 200R; R0805
R69, R70, R71, R72: 5k; R0805
U10: 140357145000; WL-OCPT_SOP4

Connections:
3V3_0: C63.2, C64.2, C65.2, C66.2, JP6.1, JP14.1, JP15.1, JP16.1, JP17.1, JP24.1, R69.2, R70.2, R71.2, R72.2; also elsewhere on the board
3V3_1: JP1.1, JP8.1, JP9.1, JP30.1, JP31.1; also elsewhere on the board
5V: JP5.2, JP22.1, U10.4; also elsewhere on the board
BLADE_MOTOR_NEG_EXT: JP7.3, JP7.4; also elsewhere on the board
BLADE_MOTOR_POS_EXT: JP7.1, JP7.2; also elsewhere on the board
GND: BSC027N04LSG2.1 (S), BSC027N04LSG2.2 (S), BSC027N04LSG2.3 (S), C63.1, C64.1, C65.1, C66.1, D2.C, JP1.2, JP14.3, JP15.3, JP16.3, JP17.3, JP22.3, JP22.4, JP30.3, JP31.3, R54.2, R55.1, R56.1, R58.1, R64.1, R109.1, R110.1, U10.2; also elsewhere on the board
GPS_PPS: JP1.5
GPS_RXD: JP1.4; also elsewhere on the board
GPS_TXD: JP1.3; also elsewhere on the board
LIDAR_RX: JP5.4; also elsewhere on the board
LIDAR_TX: JP5.7; also elsewhere on the board
LIMIT_SWITCH_BOTTOM_MAGNET: R108.1; also elsewhere on the board
LIMIT_SWITCH_BOTTOM_MECHANICAL: R60.1; also elsewhere on the board
LIMIT_SWITCH_UPPER_MAGNET: R107.1; also elsewhere on the board
LIMIT_SWITCH_UPPER_MECHANICAL: R59.1; also elsewhere on the board
MCU_0_LIGHT_SENSOR: R66.1; also elsewhere on the board
MCU_0_RAIN_SENSOR: JP6.2, JP24.2, R55.2, R57.1, R57.2, R64.2, R66.2; also elsewhere on the board
MCU_0_TEMP_SENSOR_0: JP14.2, R69.1; also elsewhere on the board
MCU_0_TEMP_SENSOR_1: JP15.2, R70.1; also elsewhere on the board
MCU_0_TEMP_SENSOR_2: JP16.2, R71.1; also elsewhere on the board
MCU_0_TEMP_SENSOR_3: JP17.2, R72.1; also elsewhere on the board
MCU_2_LIDAR_ENABLE: R62.1; also elsewhere on the board
unnamed: JP22.2, R4.2
unnamed: BSC027N04LSG2.5 (D), BSC027N04LSG2.6 (D), BSC027N04LSG2.7 (D), BSC027N04LSG2.8 (D), JP5.5
unnamed: JP8.2, R56.2, R59.2
unnamed: JP9.2, R58.2, R60.2
unnamed: BSC027N04LSG2.4 (G), R54.1, U10.3
unnamed: R62.2, U10.1
unnamed: JP31.2, R108.2, R109.2
unnamed: JP30.2, R107.2, R110.2
PERIMETER_WIRE_SENSE: D2.A, R4.1; also elsewhere on the board
STEP_DRV_0_A1: JP2.1; also elsewhere on the board
STEP_DRV_0_A2: JP2.2; also elsewhere on the board
STEP_DRV_0_B1: JP2.3; also elsewhere on the board
STEP_DRV_0_B2: JP2.4; also elsewhere on the board
STEP_DRV_1_A1: JP3.1; also elsewhere on the board
STEP_DRV_1_A2: JP3.2; also elsewhere on the board
STEP_DRV_1_B1: JP3.3; also elsewhere on the board
STEP_DRV_1_B2: JP3.4; also elsewhere on the board
STEP_DRV_2_A1: JP4.1; also elsewhere on the board
STEP_DRV_2_A2: JP4.2; also elsewhere on the board
STEP_DRV_2_B1: JP4.3; also elsewhere on the board
STEP_DRV_2_B2: JP4.4; also elsewhere on the board

Notes on the sheet:
GPS TXD to MCU RX!
Resistance is between 10M (dry) to less than 1M (fully wet)
Limit switch UP
Limit switch BOTTOM
Blade motor
Stepper_0
Stepper_1
Stepper_2
GPS
Rain sensor
Mechanical limit switches
Temperature sensor DHT11
Perimeter wire sense
Lidar
Magnetic limit switches
Pinheaders
Resistance is between 10M (dark) to less than 100k (daylight)
Light sensor

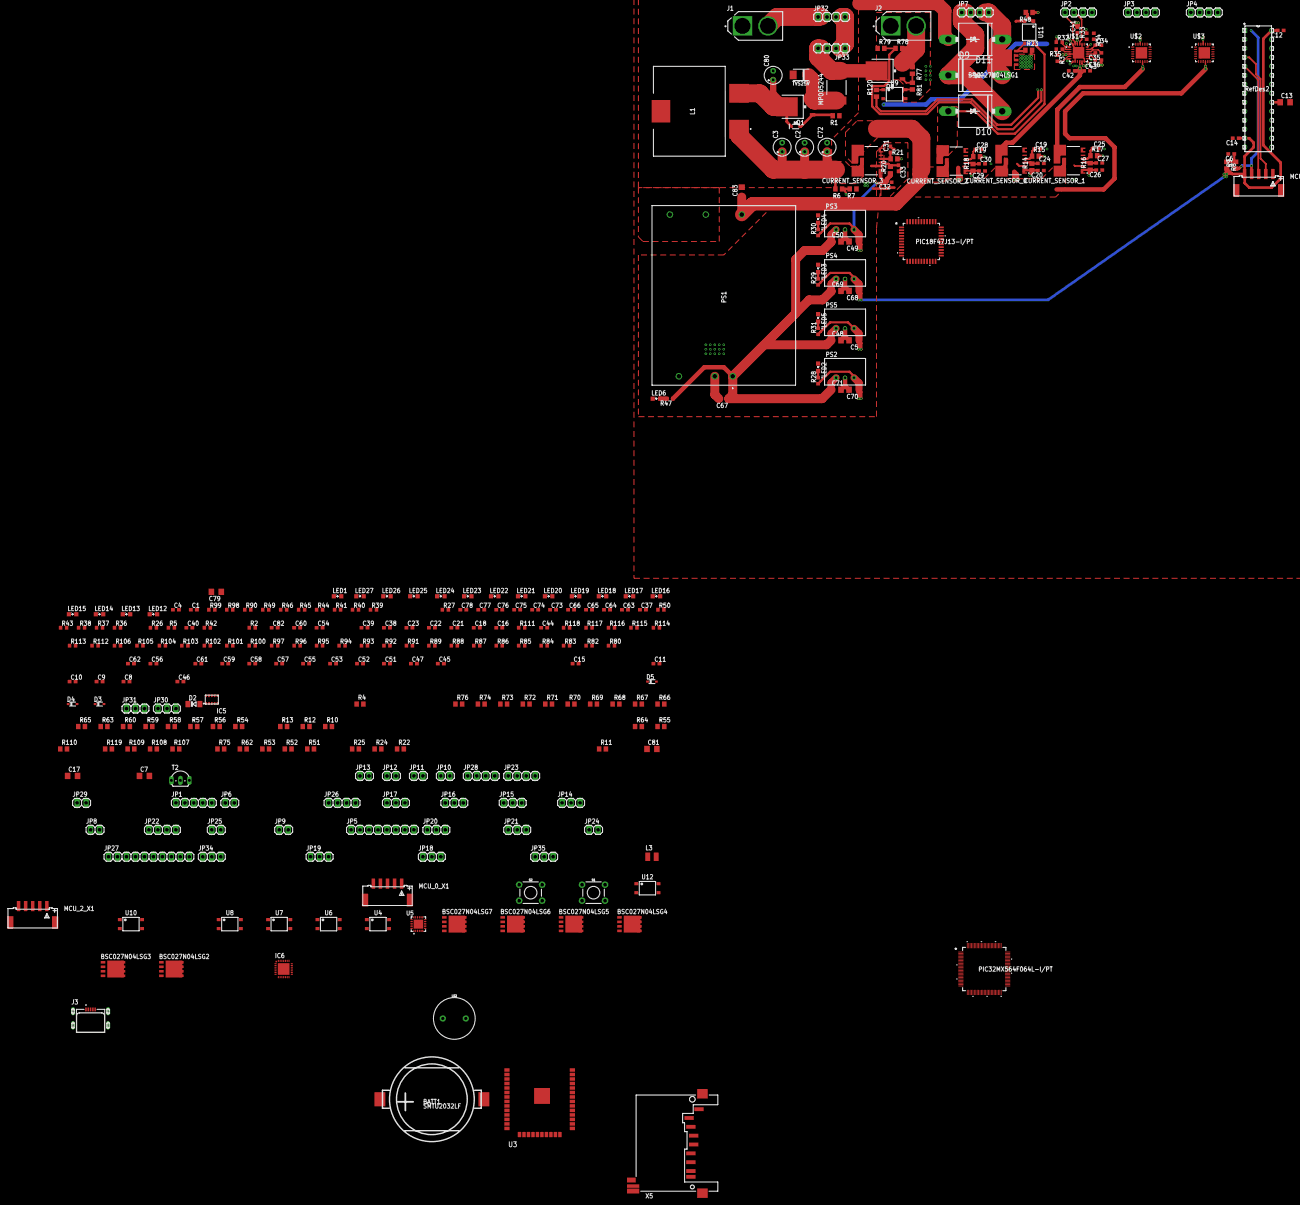
[picture p40: board RastoMower.brd from above]

Board: 2 copper layers, 319 parts (0 on the bottom side), 242 nets.
