roravec/RastoBot/MCU_0_Sensors/MCU_0_Sensors.X/main.c

/*
 * File:   main.c
 * Author: orras
 *
 * Created on January 9, 2023, 1:01 PM
 */

// PIC18F47J13 Configuration Bit Settings

// 'C' source line config statements

#pragma config WDTEN = OFF      // Watchdog Timer (Disabled - Controlled by SWDTEN bit)
#pragma config PLLDIV = 2       // 96MHz PLL Prescaler Selection (PLLSEL=0) (No prescale (4 MHz oscillator input drives PLL directly))
#pragma config CFGPLLEN = ON   // PLL Enable Configuration Bit (PLL Disabled)
#pragma config STVREN = ON      // Stack Overflow/Underflow Reset (Enabled)
#pragma config XINST = OFF      // Extended Instruction Set (Disabled)
#pragma config CP0 = OFF        // Code Protect (Program memory is not code-protected)
//#pragma config OSC = INTOSC     // Oscillator (INTOSC)
#pragma config OSC = INTOSCPLL     // Oscillator (INTOSC)
//#pragma config OSC = INTOSCPLLO     // Oscillator (INTOSC)
#pragma config SOSCSEL = HIGH   // T1OSC/SOSC Power Selection Bits (High Power T1OSC/SOSC circuit selected)
//#pragma config CLKOEC = OFF     // EC Clock Out Enable Bit  (CLKO output disabled on the RA6 pin)
#pragma config CLKOEC = ON     // EC Clock Out Enable Bit  (CLKO output disabled on the RA6 pin)
#pragma config FCMEN = ON       // Fail-Safe Clock Monitor (Enabled)
#pragma config IESO = ON        // Internal External Oscillator Switch Over Mode (Enabled)
#pragma config WDTPS = 32768    // Watchdog Postscaler (1:32768)
#pragma config DSWDTOSC = INTOSCREF// DSWDT Clock Select (DSWDT uses INTRC)
#pragma config RTCOSC = T1OSCREF// RTCC Clock Select (RTCC uses T1OSC/T1CKI)
#pragma config DSBOREN = ON     // Deep Sleep BOR (Enabled)
#pragma config DSWDTEN = ON     // Deep Sleep Watchdog Timer (Enabled)
#pragma config DSWDTPS = G2     // Deep Sleep Watchdog Postscaler (1:2,147,483,648 (25.7 days))
#pragma config IOL1WAY = ON     // IOLOCK One-Way Set Enable bit (The IOLOCK bit (PPSCON<0>) can be set once)
#pragma config ADCSEL = BIT10   // ADC 10 or 12 Bit Select (10 - Bit ADC Enabled)
//#pragma config PLLSEL = PLL4X   // PLL Selection Bit (Selects 4x PLL)
#pragma config PLLSEL = PLL96   // PLL Selection Bit (Selects 96MHz PLL)
#pragma config MSSP7B_EN = MSK7 // MSSP address masking (7 Bit address masking mode)
#pragma config WPFP = PAGE_127  // Write/Erase Protect Page Start/End Location (Write Protect Program Flash Page 127)
#pragma config WPCFG = OFF      // Write/Erase Protect Configuration Region  (Configuration Words page not erase/write-protected)
#pragma config WPDIS = OFF      // Write Protect Disable bit (WPFP<6:0>/WPEND region ignored)
#pragma config WPEND = PAGE_WPFP// Write/Erase Protect Region Select bit (valid when WPDIS = 0) (Pages WPFP<6:0> through Configuration Words erase/write protected)
// #pragma config statements should precede project file includes.
// Use project enums instead of #define for ON and OFF.

#include "config.h"
#include "RastoBot_MCU0.h"

void setup()
{
    Config_Init();
    MCU0_Init();
}

void main(void) {
    setup();
    while (1)
    {
        __delay_ms(10);
        MCU0_Loop();
    }
    return;
}
