roravec/RastoBot/MCU_2_Navigation/MCU_2_Nav.X/config.c

/* File:   config.c
 * Author: Rastislav Oravec
 * Created on Jan 26 2022
 * Version: 1.0 (1/31/2022)
 * 
 * Description: General use config file
 */ 
#include "config.h"

uint32_t rcon = 0;
uint32_t rswrst = 0;

void Config_Init(void)
{
    __builtin_disable_interrupts();
    InitOscillator();
    InitInterrupts();
    InitGPIOs();
    HwInterface_Init();
}
uint32_t __coretimer = 0; // used to calculate core ticks
void Delay_us(uint32_t us)
{
    // Convert microseconds us into how many clock ticks it will take
    us *= FCY / 1000000 / 2; // Core Timer updates every 2 ticks
    _CP0_SET_COUNT(0); // Set Core Timer count to 0
    __coretimer = _CP0_GET_COUNT();

    while (us > _CP0_GET_COUNT()); // Wait until Core Timer count reaches the number we calculated earlier
}
void Delay_ms(uint32_t ms)
{
    Delay_us(ms * 1000);
}
void Delay_ticks(uint32_t del)
{
    for(uint32_t time = 0; time < del; time++){
        asm("nop");
    }
}
void InitOscillator(void)
{
    /* unlock system for clock configuration */
    PMDUnLock();
    /* Peripheral Module Disable Configuration */
    PMD1 = 0x370;   // enable ADC
    PMD2 = 0x17001f;
    PMD3 = 0xffffffff;
    PMD4 = 0xfff01ff;
    PMD4bits.T2MD = 0;
    PMD5 = 0xf3073f08;
    //PMD5 = 0xFFF7FFC8; // I2C4, U1, U2, U3, U5, U6 // documentation page 643, table 33-1, 0 to enable clock to periphery
    PMD6 = 0xf0d0000;
    PMD7 = 0x0;
    /* Lock system since done with clock configuration */
    PMDLock();

    /* Configure CP0.K0 for optimal performance (cached instruction pre-fetch) */
    __builtin_mtc0(16, 0,(__builtin_mfc0(16, 0) | 0x3));

    /* Configure Wait States and Prefetch */
    CHECONbits.PFMWS = 1;
    CHECONbits.PREFEN = 1;
    
    // REFO1 - UART SPI
    /* Selecting the SYSCLK as input for REFO4CLK*/
    //REFO1CONbits.ROSEL = 7;
    REFO1CON = 0x200;
    /* Selecting the REFO4 prescaler to 3*/
    REFO1CONbits.RODIV = 0;
//    REFO1CONbits.RODIV = 1;
    REFO1TRIMbits.ROTRIM = 0;
    REFO1CONSET = 0x00008000;
    
    PB2DIVbits.PBDIV = 2; // U1, U2, I2C1, I2C2
    PB2DIVbits.ON = 1; 
    PB3DIVbits.PBDIV = 2; // U3, U4, U5, U6, I2C3, I2C4
    PB3DIVbits.ON = 1;
    PB4DIVbits.PBDIV = 2;
    PB4DIVbits.ON = 1;
    
    // REFO4 - CAN
    /* Selecting the SYSCLK as input for REFO4CLK*/
    //REFO4CONbits.ROSEL = 7;
    REFO4CON = 0x200;
    /* Selecting the REFO4 prescaler to 3*/
    REFO4CONbits.RODIV = 0;
    REFO4TRIMbits.ROTRIM = 0;
    REFO4CONSET = 0x00008000;
    
    rcon = RCON;
    rswrst = RSWRST;
    //RCON = 0;
    //RSWRST = 0;
    
    // free-running timer
    T2CON = 0;
    TMR2 = 0;
    PR2 = PBCLK2;
    T2CONbits.T32 = 0;
    T2CONbits.TCS = 0;
    T2CONbits.ON = 1;
}

void InitInterrupts(void)
{
    asm volatile("ei");
    INTCONSET = _INTCON_MVEC_MASK;
    /* Set up priority and subpriority of enabled interrupts */
//    IPC10SET = 0x400 | 0x0;  /* I2C1_BUS:  Priority 1 / Subpriority 0 */
//    IPC10SET = 0x4000000 | 0x0;  /* I2C1_MASTER:  Priority 1 / Subpriority 0 */
//    IPC42SET = 0x4 | 0x0;  /* CAN2:  Priority 1 / Subpriority 0 */
//    IPC42SET = 0x1F;  /* CAN2:  Priority 7 / Subpriority 3 */
    IPC48SET = 0x40000 | 0x0;  /* I2C4_BUS:  Priority 1 / Subpriority 0 */
    IPC49SET = 0x4 | 0x0;  /* I2C4_MASTER:  Priority 1 / Subpriority 0 */
    
//    IPC48bits.I2C4BIP = 3;
//    IPC48bits.I2C4BIS = 1;
//    IPC49bits.I2C4MIP = 3;
//    IPC49bits.I2C4MIS = 2;
    
    IPC10bits.U1TXIP = 6;
    IPC10bits.U1TXIS = 3;
    
    __builtin_enable_interrupts();
}

void InitGPIOs()
{
    IOUnLock();
    ANSELA = 0; // disable all analog pins
    ANSELB = 0; // disable all analog pins
    ANSELC = 0; // disable all analog pins
//    ANSELD = 0; // disable all analog pins
    ANSELE = 0; // disable all analog pins
//    ANSELF = 0; // disable all analog pins
    ANSELG = 0; // disable all analog pins
    ANSELGbits.ANSG6 = 1; // turn on analog function for wire sense; AN19 - class 2
    
    LED_0_LAT = 1;
    LED_1_LAT = 1;
    LED_2_LAT = 1;
    LED_3_LAT = 1;
    
    // UART RX
    U1RXR = 0b0010; // RPA4
    U2RXR = 0b0001; // RPB5
    U3RXR = 0b0100; // RPB7
    U5RXR = 0b0111; // RPA7
    U6RXR = 0b0110; // RPC0
    
    // UART TX
    RPA11R = 0b00001;      // U1TX
    RPB10R = 0b00010;      // U2TX
    RPC15R = 0b00001;      // U3TX
    RPB14R = 0b01011;      // U5TX
    RPC1R  = 0b01011;      // U6TX
    
    IOLock();
}

// MCU3     UART1
// RX:33
// *TX:12 

// MCU1     UART5
// RX:1
// *TX:2 

// MCU0     UART3
// RX:46
// *TX:40 

// LIDAR    UART2
// RX:43
// *TX:60 

// GPS      UART6
// RX:21
// *TX:22 

// I2C4
// SDA:27
// SCL:28
