roravec/RastoBot/MCU_0_Sensors/MCU_0_Sensors.X/config.c

/* File:   config.c
 * Author: Rastislav Oravec
 * Created on Jan 26 2022
 * Version: 1.0 (1/31/2022)
 * 
 * Description: General use config file
 */ 
#include "config.h"

//uint32_t __coretimer = 0; // used to calculate core ticks
//void Delay_us(unsigned long us)
//{
//    // Convert microseconds us into how many clock ticks it will take
//    us *= FCY / 1000000 / 2; // Core Timer updates every 2 ticks
//    //_CP0_SET_COUNT(0); // Set Core Timer count to 0
//    //__coretimer = _CP0_GET_COUNT();
//
//    //while (us > _CP0_GET_COUNT()); // Wait until Core Timer count reaches the number we calculated earlier
//}
//void Delay_ms(uint32_t ms)
//{
//    Delay_us(ms * 1000);
//}
void Delay_ticks(unsigned int del)
{
    for(uint32_t time = 0; time < del; time++){
        asm("nop");
    }
}

void Config_Init()
{
    InitOscillator();
    InitInterrupts();
    HwInterface_Init();
    InitGPIOs();
}

void InitOscillator(void)
{
    PLLEN = 1;
    //internal oscillator setup - 8 MHz
    IRCF2 = 1;
    IRCF1 = 1;
    IRCF0 = 1;
    
    REFOCONbits.ROON = 0; // disable REFO on RB2
    
    // TIMER
    // Clock source is Fosc/4
    // 8MHz / 4 = 2MHz
    // Alternative 48MHz / 4 = 12MHz
    //
    // Prescaler
    // 1:1 = 2MHz or 12MHz
    // 1:2 = 1MHz or 6MHz
    // 1:4 = xMHz or 3MHz
    //T1CON  = 0x10; // set Timer1 clock source to internal with 1:2 prescaler (Timer1 clock = 1MHz@8MHz or 6MHz@48MHz)
    //T1CON  = 0x20; // set Timer1 clock source to internal with 1:4 prescaler (Timer1 clock = 3MHz@48MHz)
    T1CON  = 0x30; // set Timer1 clock source to internal with 1:8 prescaler (Timer1 clock = 1.5MHz@48MHz)
    TMR1H  = 0;           // reset Timer1
    TMR1L  = 0;
    
    /* From documentation:
        111 = PLL output divided by 256
        110 = PLL output divided by 64
        101 = PLL output divided by 32
        100 = PLL output divided by 16
        011 = PLL output divided by 8
        010 = PLL output divided by 4
        001 = PLL output divided by 2
        000 = PLL output divided by 1
     */
}

void InitInterrupts(void)
{
    PEIE = 1;   // Peripheral Interrupt Enable bit
    GIE = 1;    // Global Interrupt Enable bit
    TMR0IE = 1;
}

void InitGPIOs()
{
    ANCON1 = 0x1F; // disable analog on Tilt sensor, MCU_TEMP_sensors (set 1 to disable)
    
    POWER_OUTPUT_0_LAT = 0;
    POWER_OUTPUT_1_LAT = 0;
    POWER_OUTPUT_2_LAT = 0;
    POWER_OUTPUT_3_LAT = 0;
    LED_0_LAT = 1;
    LED_1_LAT = 1;
    LED_2_LAT = 1;
    EXT_INPUT_ENABLE_LAT = 1;
    
    TEMP_SENSOR_0_TRIS = 0;
    TEMP_SENSOR_0_LAT = 0;
}
