roravec/RastoBot/(commit log)

2023-01-18 MCU_0 is ready for testing
    [Config_1.txt, Config_2.txt]
2023-01-23 Motors speed control
2023-01-30 DMA work in progress
2023-01-31 DMA work in progress 2
2023-01-31 ESP32 UART work in progress
2023-02-02 DMA in progress 2
2023-02-04 DMA UART work in progress
2023-02-05 DMA UART works
2023-02-07 I2C work in progress
2023-02-13 Documentation and PCB added
    [RastoBot-r1.brd, RastoBot-r1.dxf, RastoBot-r1.sch, RastoBot-r1_BOM.csv, RastoBot-r2.brd, RastoBot-r2.sch, RastoBot.brd, RastoBot.sch]
2023-02-20 DMA transfer MCU2 to MCU3
2023-02-24 DMA MCU2 to MCU3 fixed
    [DMA_PIC32MK.c, RastoBot_MCU2.c, RastoBot_MCU2.h, config.c]
2023-03-28 Control panel v1
    [RastoBot-r2.sch]
2023-03-29 Reference run, ESP32 webserver, Control panel
2023-03-30 ControlPanel - +gyro
2023-04-01 Steppers in move signal
