roravec/RastoBot/(notices)

Notices in the files:
parts and their libraries:
SparkFun-Electromechanical: Licensing: Creative Commons ShareAlike 4.0 International - https://creativecommons.org/licenses/by-sa/4.0
Wurth_Optocoupler_WL-OCPT: Copyright: Würth Elektronik
COPYRIGHT: Copyright (C) 2022 Ultra Librarian. All rights reserved.
